madeonline/GreenhouseProject_continuation/Приемник метеостанции_MisolAmega328/MeteoMisol_WN5300CA_I2C_Slave_01/DOC/Метеостанция Misol WN5300CA.png

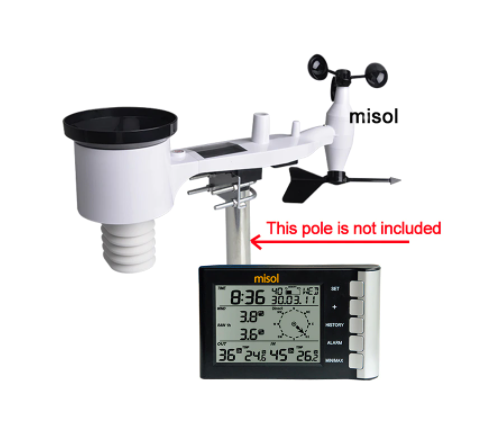
Приемник метеостанции_MisolAmega328/MeteoMisol_WN5300CA_I2C_Slave_01/DOC/Метеостанция Misol WN5300CA.png
