madeonline/GreenhouseProject_continuation/Датчик влажности грунта/Soil_moisture_sensorAmega328_6/2021-06-04_08-44-53.jpg

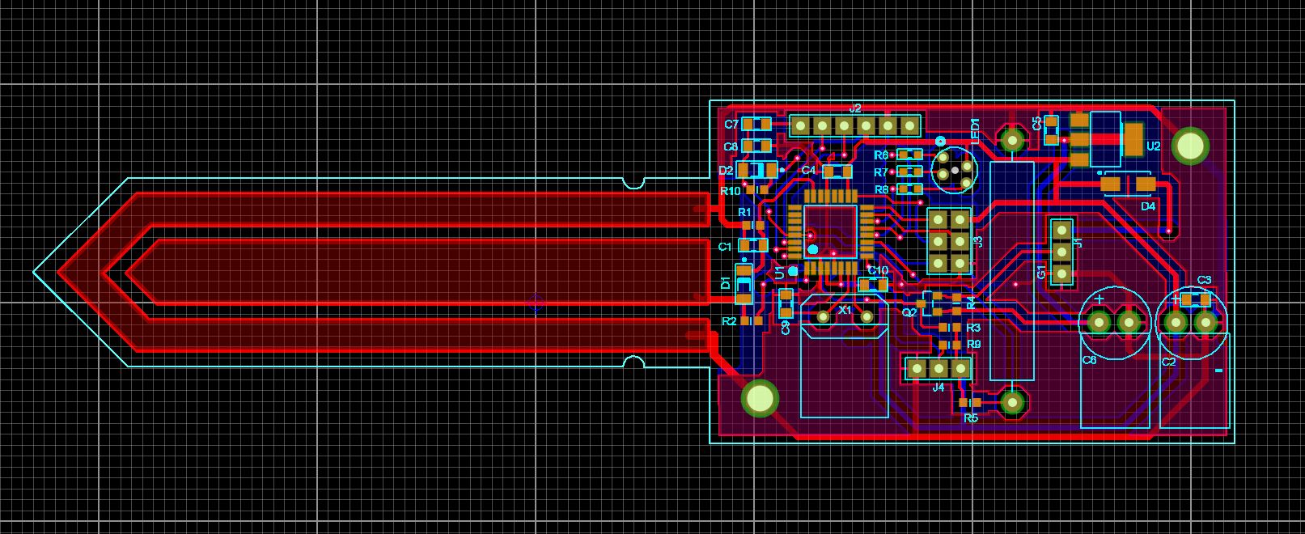
Датчик влажности грунта/Soil_moisture_sensorAmega328_6/2021-06-04_08-44-53.jpg
