madeonline/GreenhouseProject_continuation/Инструкции на контроллер теплицы/Локальный сайт теплицы/WEB/README.TXT

1. Требования к веб-серверу

  * На сервере должна быть установлена поддержка PHP версии не ниже 5.4
    (в случае Apache это mod_php5);
    
  * На сервере должна быть установлена поддержка SQLite3 для PHP,
    для Apache под Windows это:
    
      extension=php_pdo.dll
      extension=php_pdo_sqlite.dll
      extension=php_sqlite3.dll

2. Работа по расписанию.

  Для работы по расписанию необходимо поставить скрипт cron.php
  в планировщик. Этот скрипт собирает данные со всех прописанных в БД
  контроллеров и помещает их в базу. В дальнейшем на основе этих
  данных строятся графики.
