madeonline/GreenhouseProject_continuation/Инструкции на контроллер теплицы/ПРОГРАММЫ ДЛЯ ПОЛЬЗОВАТЕЛЕЙ/lang/en.ini.richTextBox4.rtf

When device is connected to the MQTT-broker, it's start publishing the topics, provided by user. Also device is subscribed to the CLIENT_NAME/SET/# topic, where "CLIENT_NAME" - is the MQTT-client name, entered in firmware settings. By publish the CLIENT_NAME/SET/..., you can send commands to the device. All of commands are in uppercase! Below you can find the list of frequently used commands:

• CLIENT_NAME/SET/STATE/WINDOW/ALL/OPEN - open all windows;
• CLIENT_NAME/SET/STATE/WINDOW/ALL/CLOSE - close all windows;
• CLIENT_NAME/SET/STATE/WINDOW/0/OPEN - open window number 1;
• CLIENT_NAME/SET/STATE/WINDOW/2/CLOSE - close window number 3;
• CLIENT_NAME/SET/WATER/ON - start watering;
• CLIENT_NAME/SET/WATER/ON/1 - start watering on channel 2;
• CLIENT_NAME/SET/WATER/OFF - stop watering;
• CLIENT_NAME/SET/WATER/OFF/0 - stop watering on channel 1;
• CLIENT_NAME/SET/LIGHT/ON - light on;
• CLIENT_NAME/SET/LIGHT/OFF - light off;
• CLIENT_NAME/SET/STATE/MODE/AUTO - switch to automatic windows management mode;
• CLIENT_NAME/SET/STATE/MODE/MANUAL - switch to manual windows management mode;
• CLIENT_NAME/SET/WATER/MODE/AUTO - switch to automatic watering management mode;
• CLIENT_NAME/SET/WATER/MODE/MANUAL - switch to manual watering management mode;
• CLIENT_NAME/SET/LIGHT/MODE/AUTO - switch to automatic light management mode;
• CLIENT_NAME/SET/LIGHT/MODE/MANUAL - switch to manual light management mode;
• CLIENT_NAME/SET/PIN/13/ON - turn pin 13 on;
• CLIENT_NAME/SET/PIN/10/OFF - turn pin 10 off;
• CLIENT_NAME/SET/CC/EXEC/0 - execute composite command number 1;
• CLIENT_NAME/SET/RULE_STATE/ALL/ON - enable all rules;
• CLIENT_NAME/SET/RULE_STATE/ALL/OFF - disable all rules;
• CLIENT_NAME/SET/RULE_ALERT/ALL/ON - enable all alarm rules;
• CLIENT_NAME/SET/RULE_ALERT/ALL/OFF - disable all alarm rules;
• CLIENT_NAME/SET/0/AUTO - turn into automatic work mode.

Also you can receive any firmware settings by publish the CLIENT_NAME/GET/... topic.

Also by using the CLIENT_NAME/SET/... topics you can set any settings of any firmware module, if you wish. For additional information - please write to spywarrior@gmail.com, and I can extend this help with explanation of your query.

Result of the requested command are published to the CLIENT_NAME/REPORT topic.
