madeonline/GreenhouseProject_continuation/Инструкции на контроллер теплицы/Аппаратная информация/Greenhouse_STM32_Maxi.png

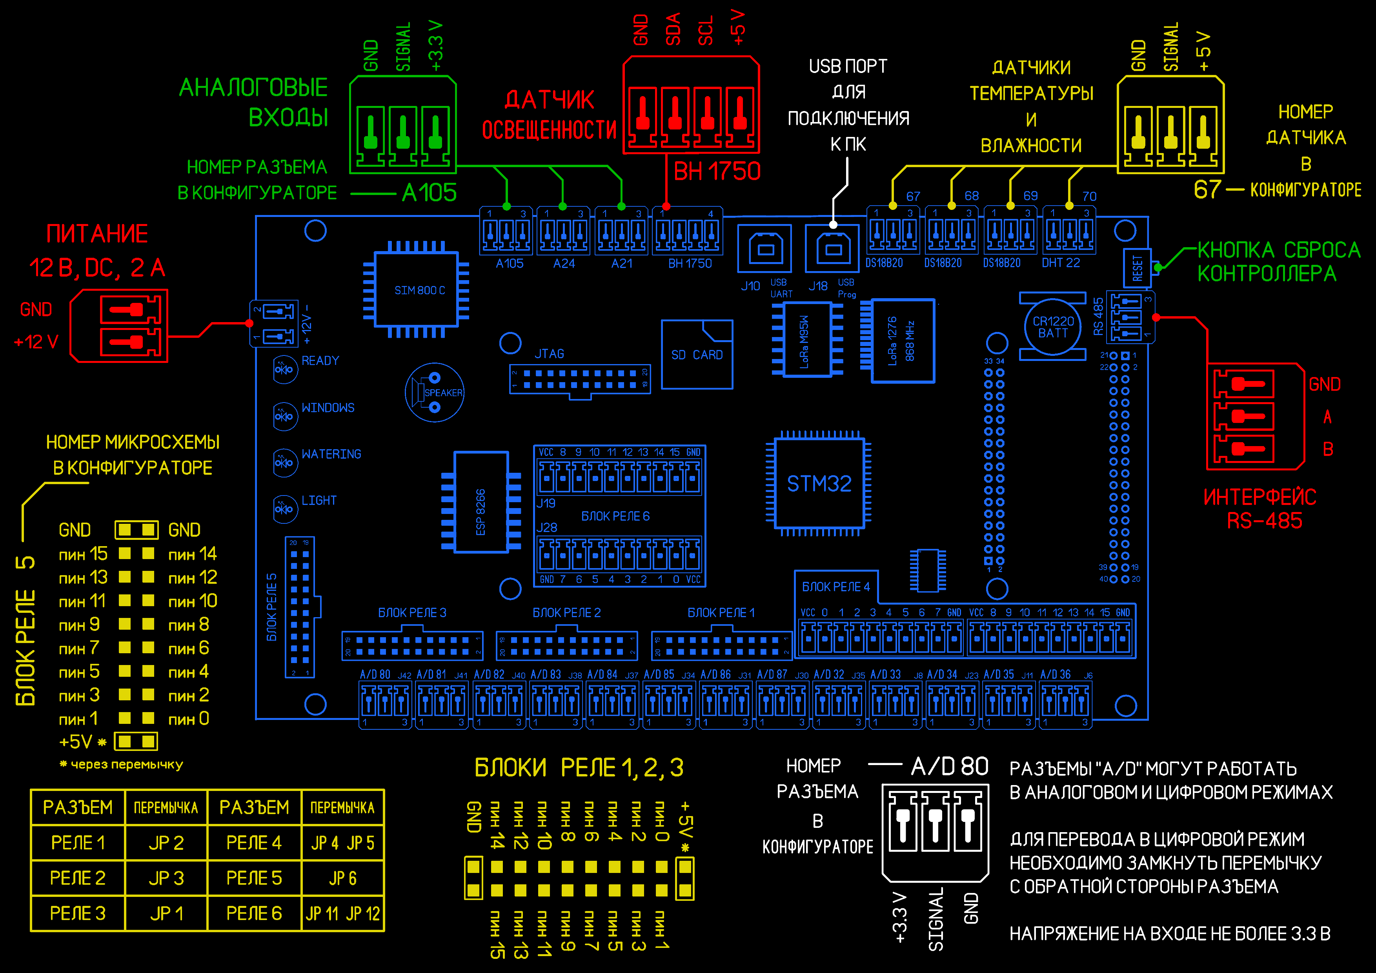
Инструкции на контроллер теплицы/Аппаратная информация/Greenhouse_STM32_Maxi.png
