madeonline/GreenhouseProject_continuation/Инструкции на контроллер теплицы/Аппаратная информация/Щит-сборка1.jpg

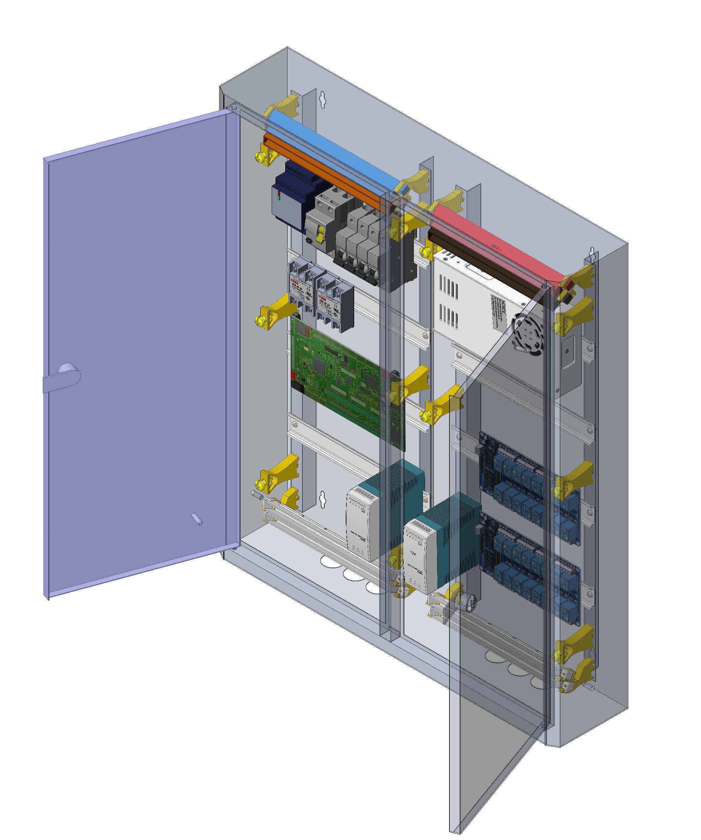
Инструкции на контроллер теплицы/Аппаратная информация/Щит-сборка1.jpg
