madeonline/GreenhouseProject_continuation/Инструкции на контроллер теплицы/Локальный сайт теплицы/2020-04-10_18-04-55.png

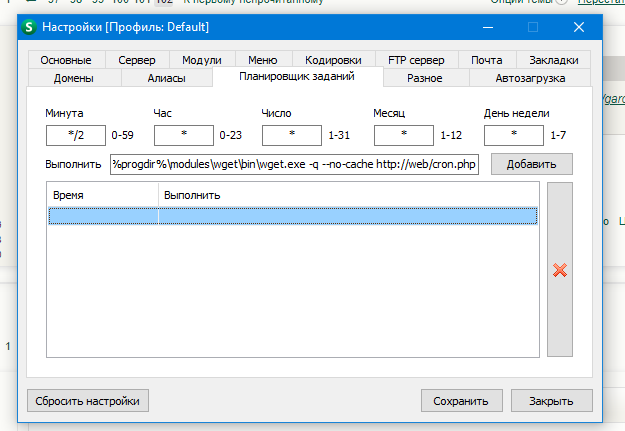
Инструкции на контроллер теплицы/Локальный сайт теплицы/2020-04-10_18-04-55.png
