madeonline/GreenhouseProject_continuation/Приемник метеостанции_MisolAmega328/2021-06-04_10-09-00.jpg

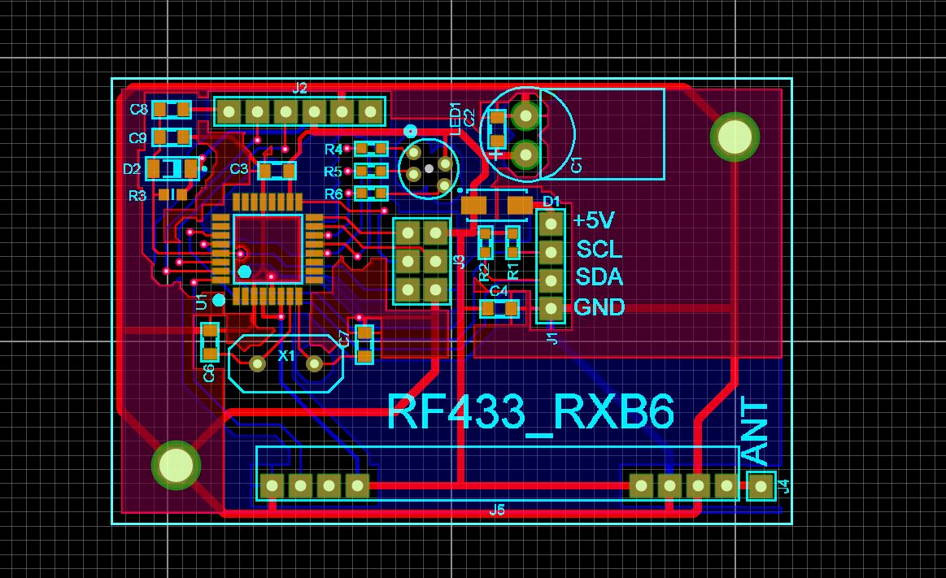
Приемник метеостанции_MisolAmega328/2021-06-04_10-09-00.jpg
