madeonline/GreenhouseProject_continuation/Приемник метеостанции_MisolAmega328/MeteoMisol_WS0232_I2C_Slave_01/DOC/Метеостанция WS0232.png

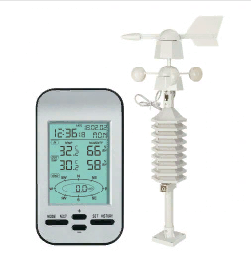
Приемник метеостанции_MisolAmega328/MeteoMisol_WS0232_I2C_Slave_01/DOC/Метеостанция WS0232.png
