madeonline/GreenhouseProject_continuation/Ультразвуковой модуль уровня воды/UniversalUltrasonicModule_02/2021-05-02_10-48-28.png

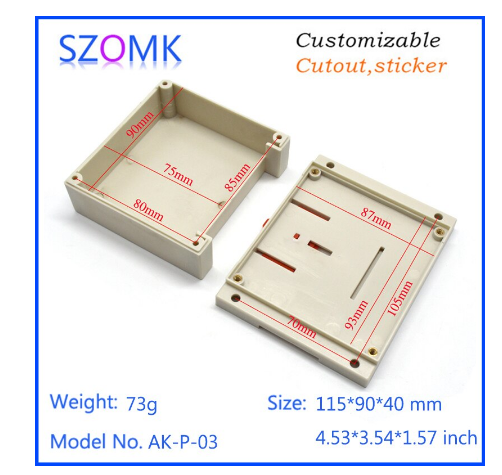
Ультразвуковой модуль уровня воды/UniversalUltrasonicModule_02/2021-05-02_10-48-28.png
