madeonline/GreenhouseProject_continuation/Приемник метеостанции_MisolAmega328/Receive_MisolAmega328_1.PDF

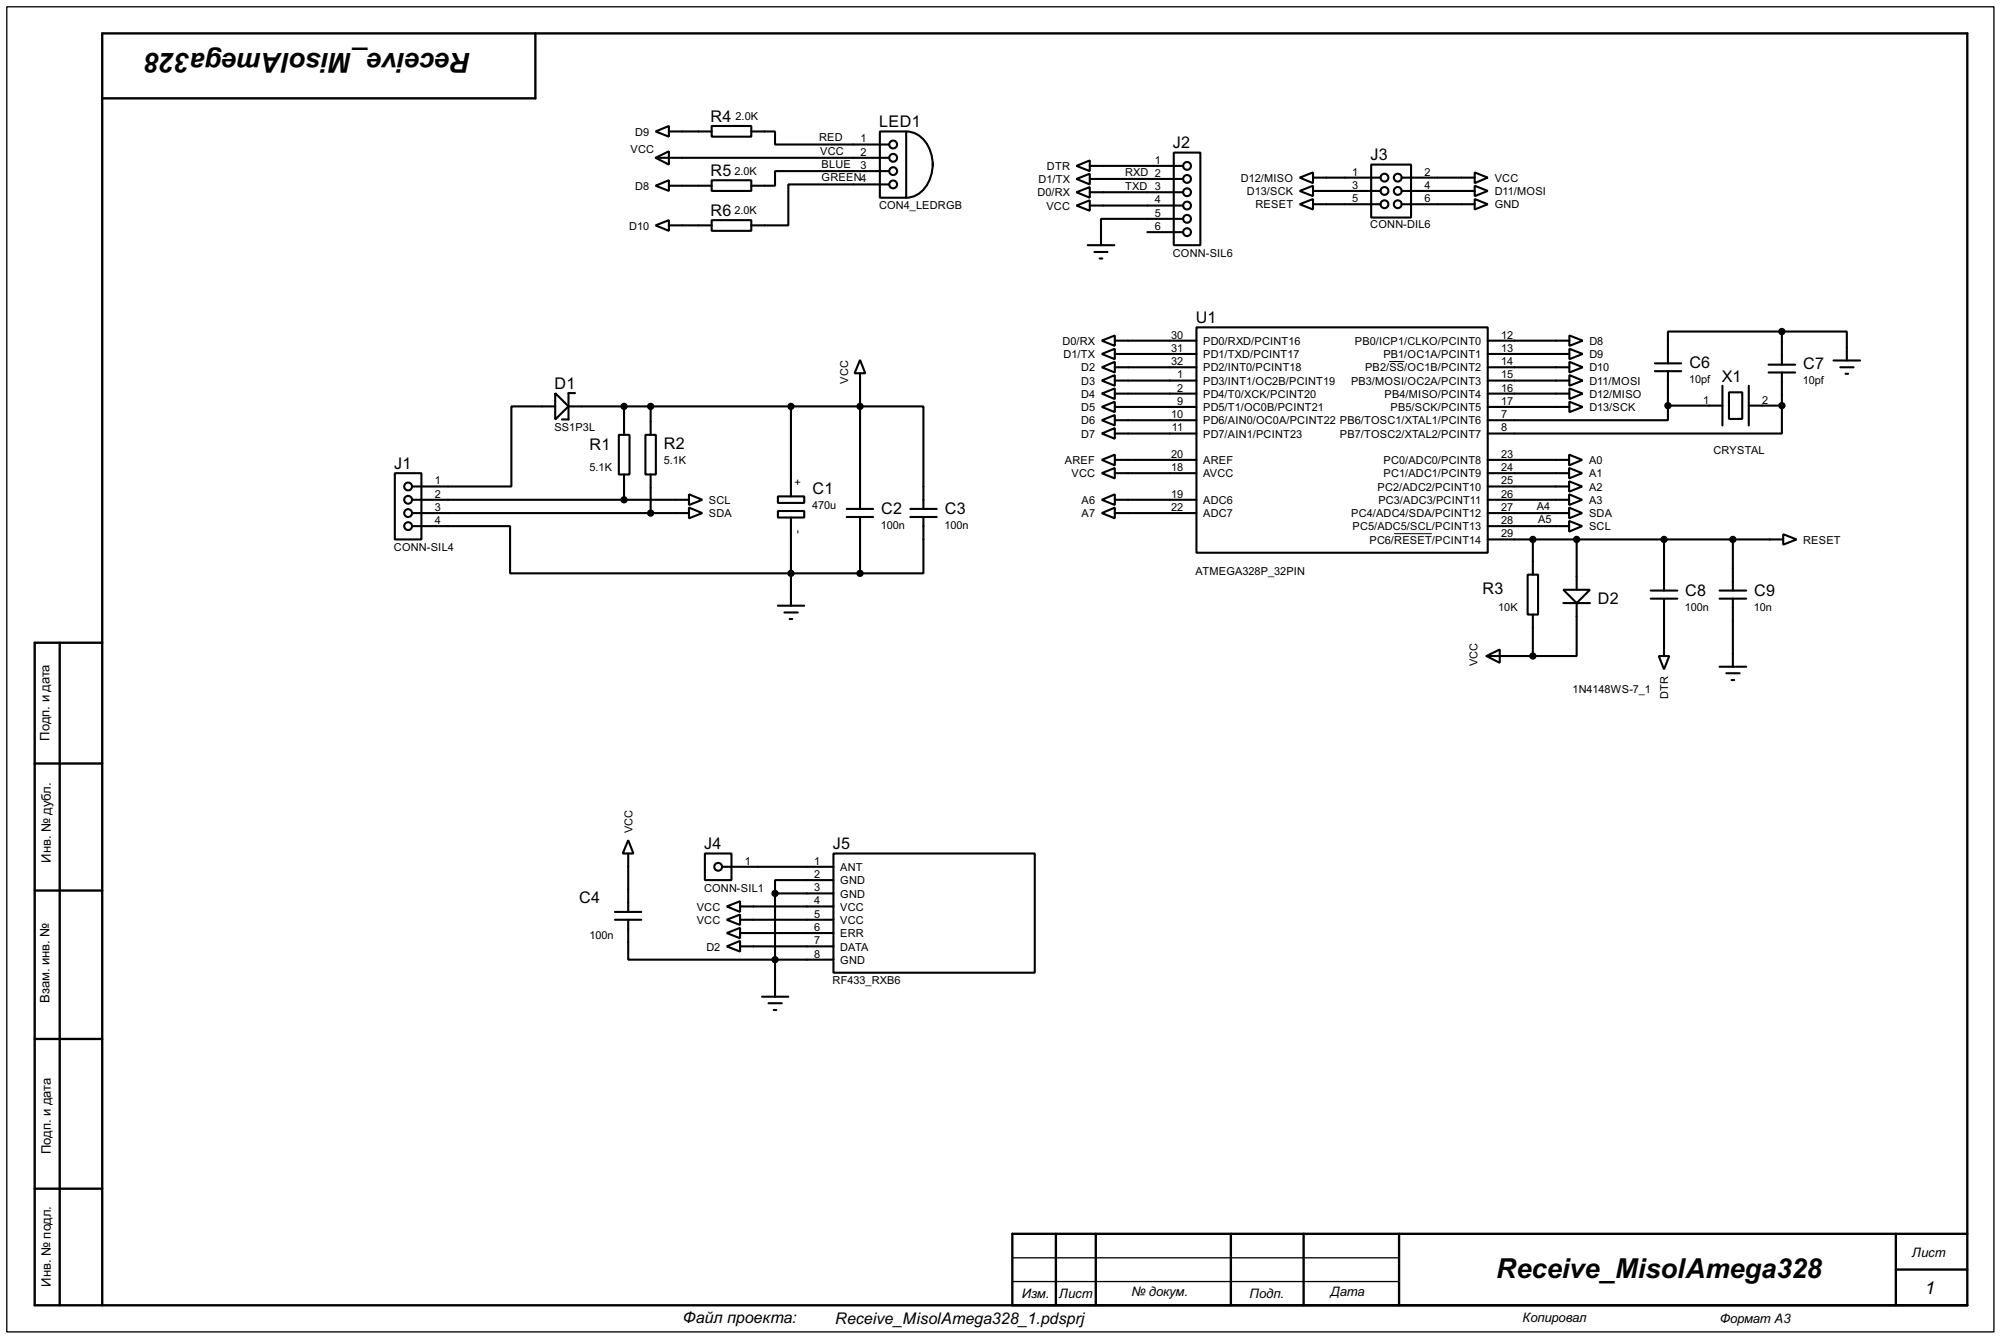
[picture p14: page 1]

Инв. № подл. Подп. и дата Взам. инв. № Инв. № дубл. Подп. и дата
