madeonline/GreenhouseProject_continuation/Внешний модуль полива/WateringExecutionModule_01.PDF

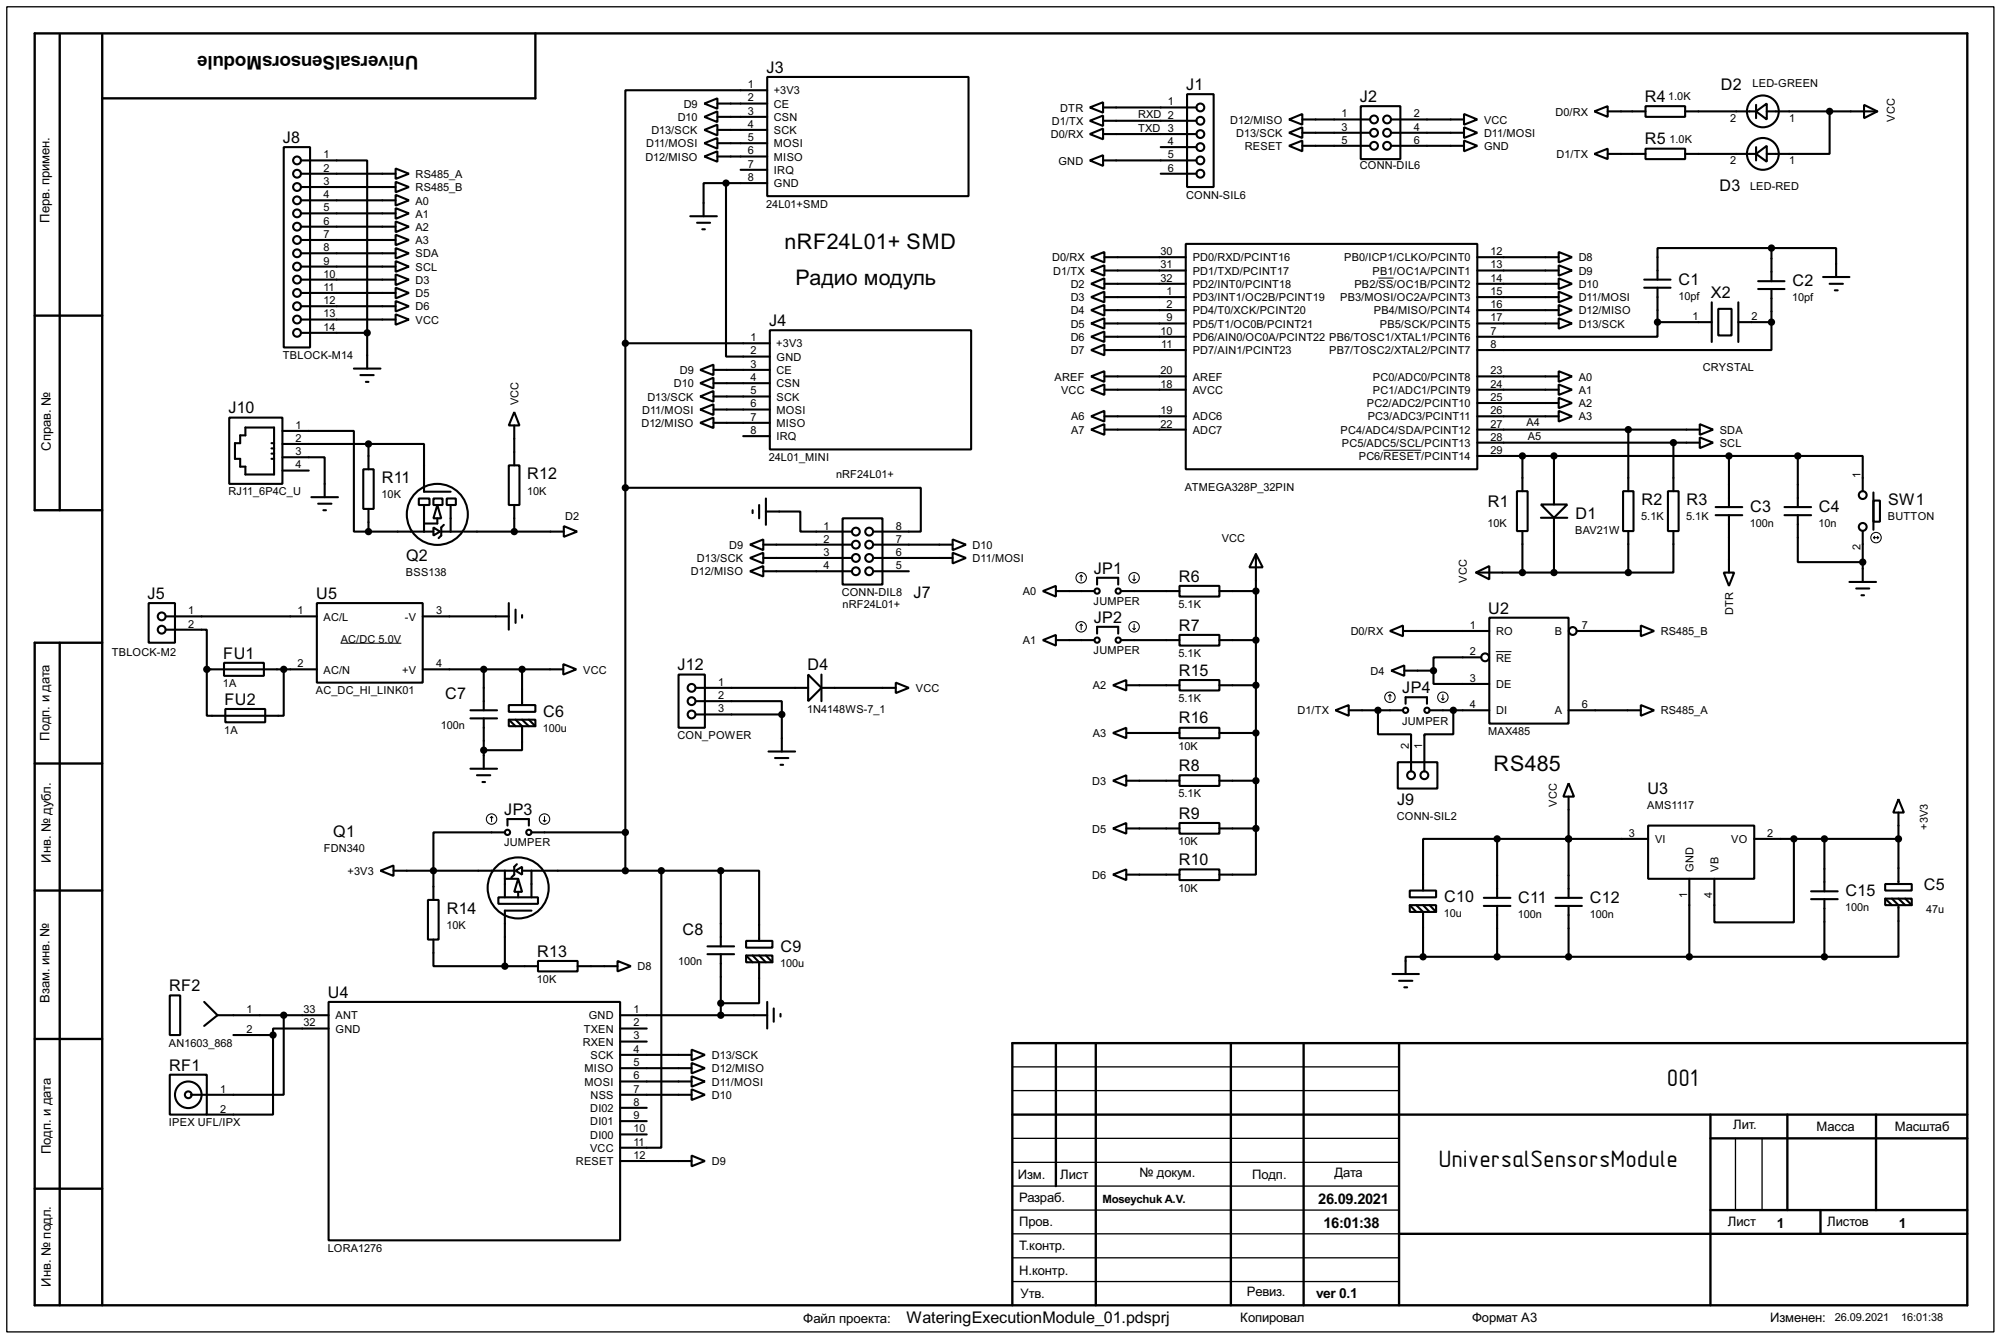
[picture p15: page 1]

Инв. № подл. Подп. и дата Взам. инв. № Инв. № дубл. Справ. № Перв. примен. Подп. и дата

Изм. Лист Разраб. Пров. Т.контр. Н.контр. Утв. | | 16:01:38 | | Лист 1 | Листов 1

№ докум. | Подп. | Дата

Moseychuk A.V. | | 26.09.2021
