madeonline/GreenhouseProject_continuation/Инструкции на контроллер теплицы/Аппаратная информация/STM32F407VGT6_Mini_01.PDF

U1

J2

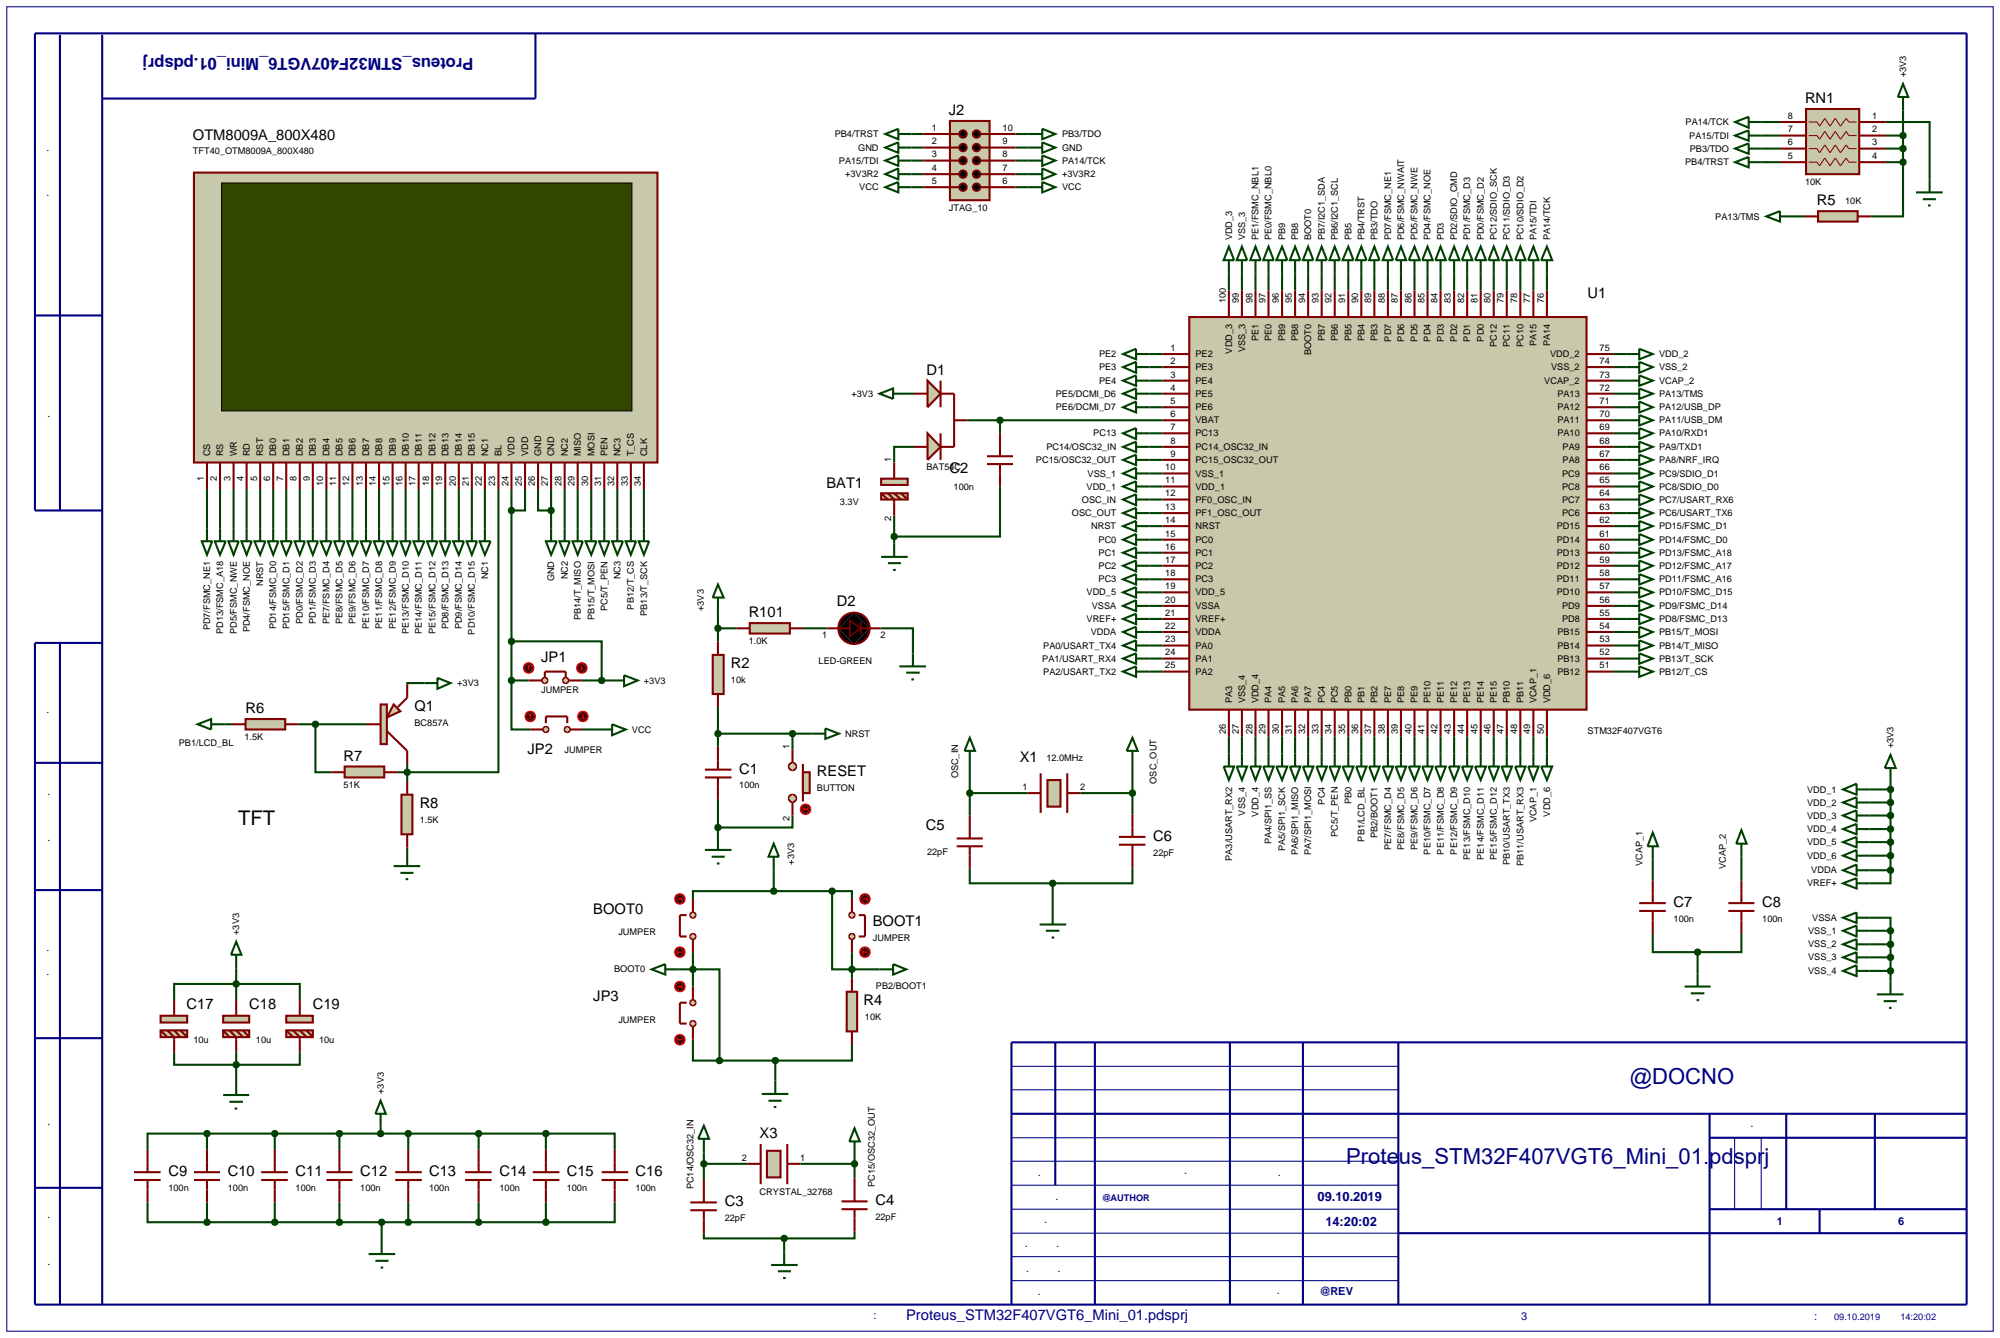
[picture p16: page 1]

Инв. № подл. Подп. и дата Взам. инв. № Инв. № дубл. Справ. № Перв. примен. Подп. и дата

@DOCNO

Лит. | Масса | Масштаб

Изм. | Лист | № докум. | Подп. | Дата
Разраб. | | @AUTHOR | | 09.10.2019
Пров. | | | 14:20:02 | | Лист 1 6 | Листов
Т.контр.

Н.контр.
Утв. | | Ревиз. | @REV
