madeonline/GreenhouseProject_continuation/Инструкции на контроллер теплицы/Аппаратная информация/STM32F407VGT6_Mini_02.PDF

U1

## OTM8009A_800X480

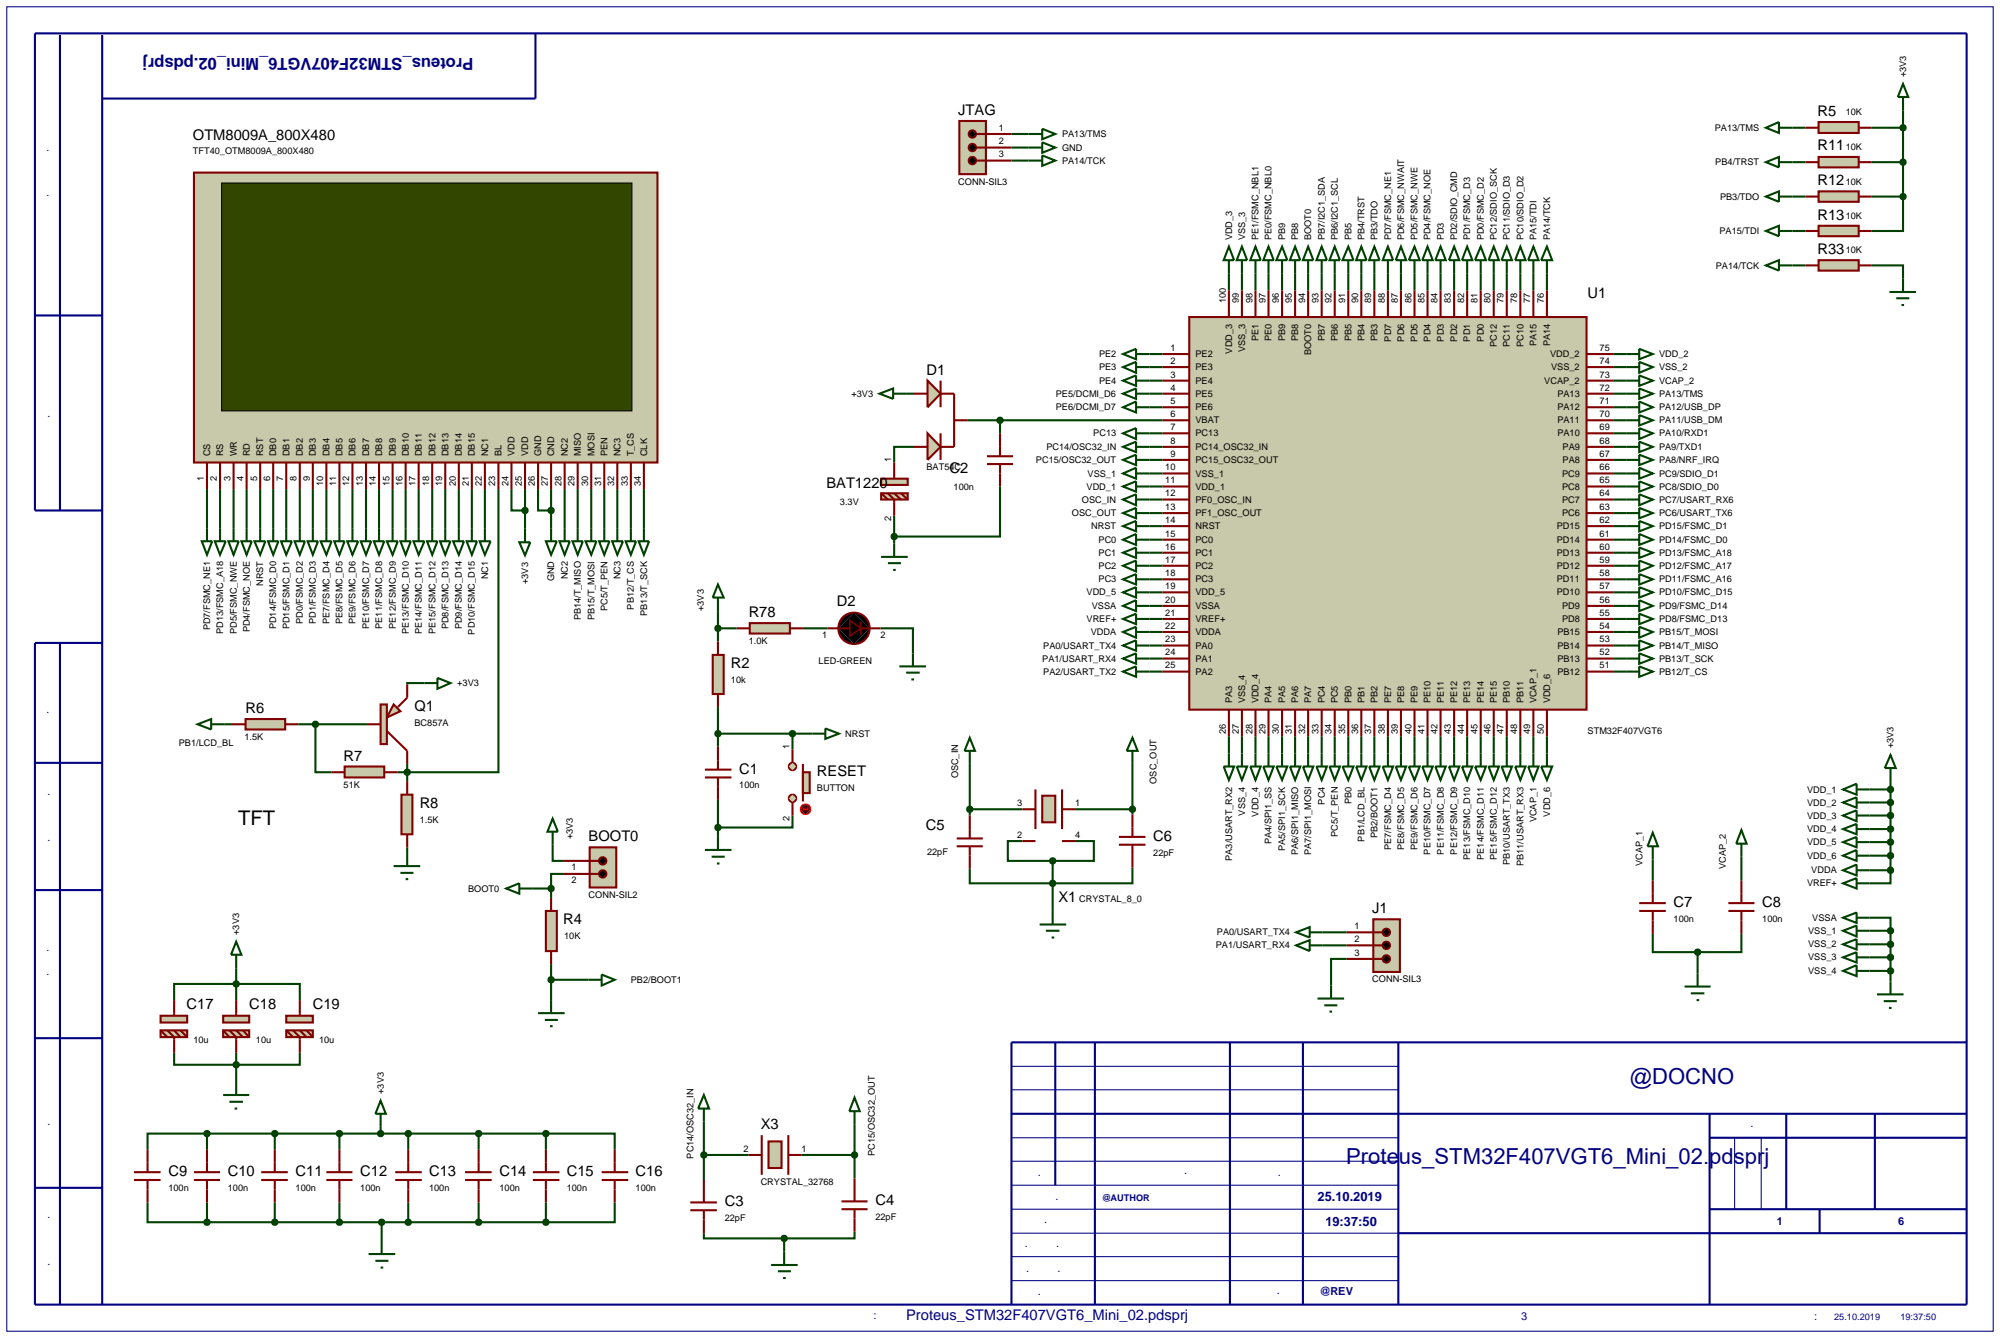
[picture p17: page 1]

Инв. № подл. Подп. и дата Взам. инв. № Инв. № дубл. Справ. № Перв. примен. Подп. и дата

Разъем TFT дисплея PD⁰/FSMC_D² PD¹/FSMC_D³ PD¹⁴/FSMC_D⁰ PD¹⁵/FSMC_D¹

@DOCNO

Лит. | Масса | Масштаб

Изм. | Лист | № докум. | Подп. | Дата
Разраб. | | @AUTHOR | | 25.10.2019
Пров. | | | 19:37:50 | | Лист 1 6 | Листов
Т.контр.

Н.контр.
Утв. | | Ревиз. | @REV

Q3

R19

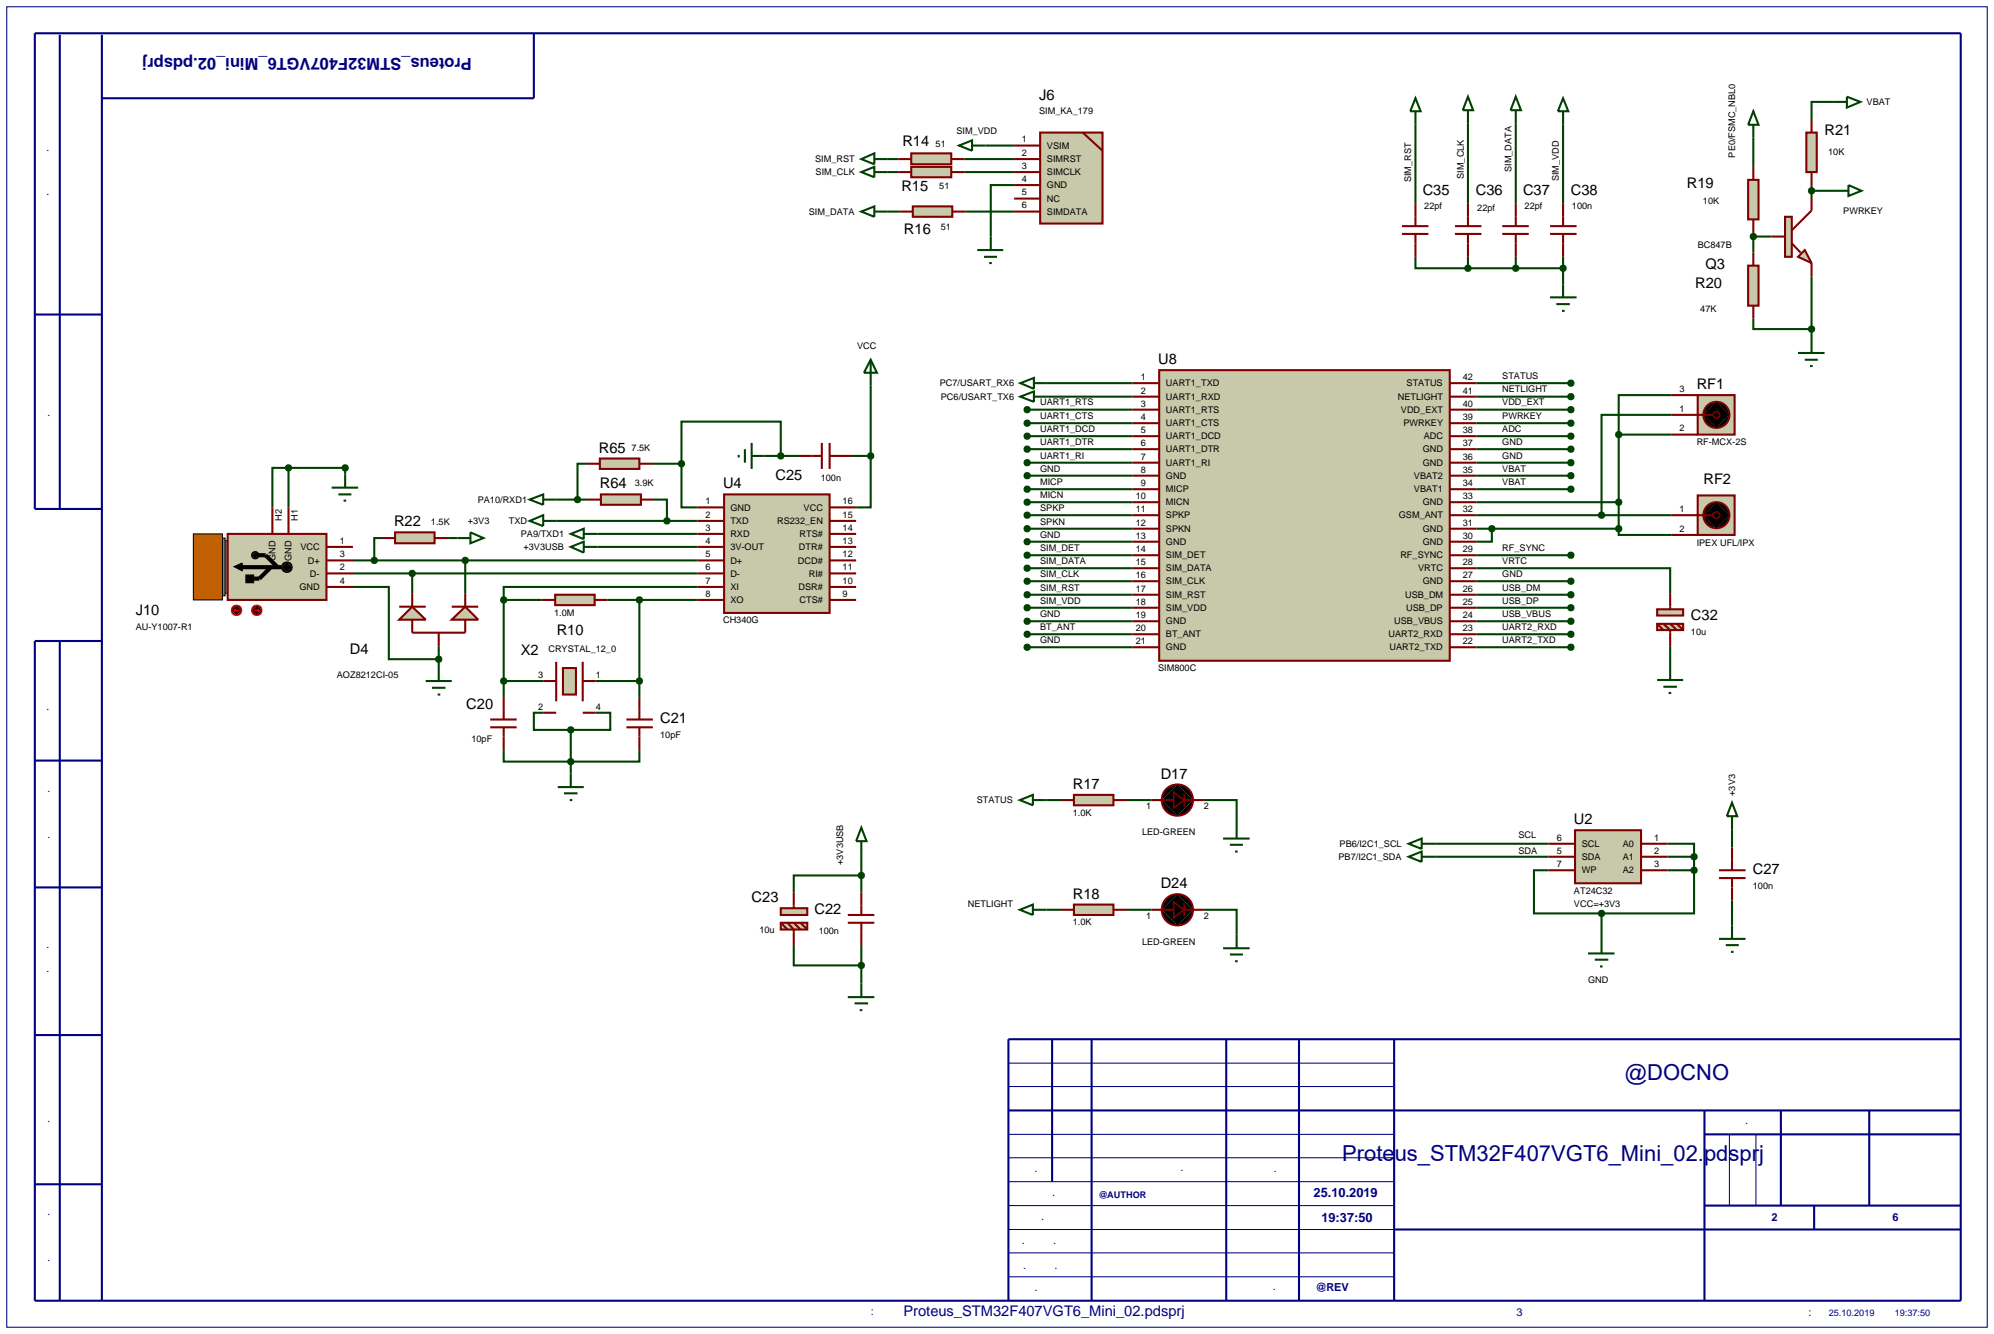
[picture p18: page 2]

Инв. № подл. Подп. и дата Взам. инв. № Инв. № дубл. Справ. № Перв. примен. Подп. и дата

@DOCNO

Лит. | Масса | Масштаб

Изм. | Лист | № докум. | Подп. | Дата
Разраб. | | @AUTHOR | | 25.10.2019
Пров. | | | 19:37:50 | | Лист 2 6 | Листов

U7

RS485

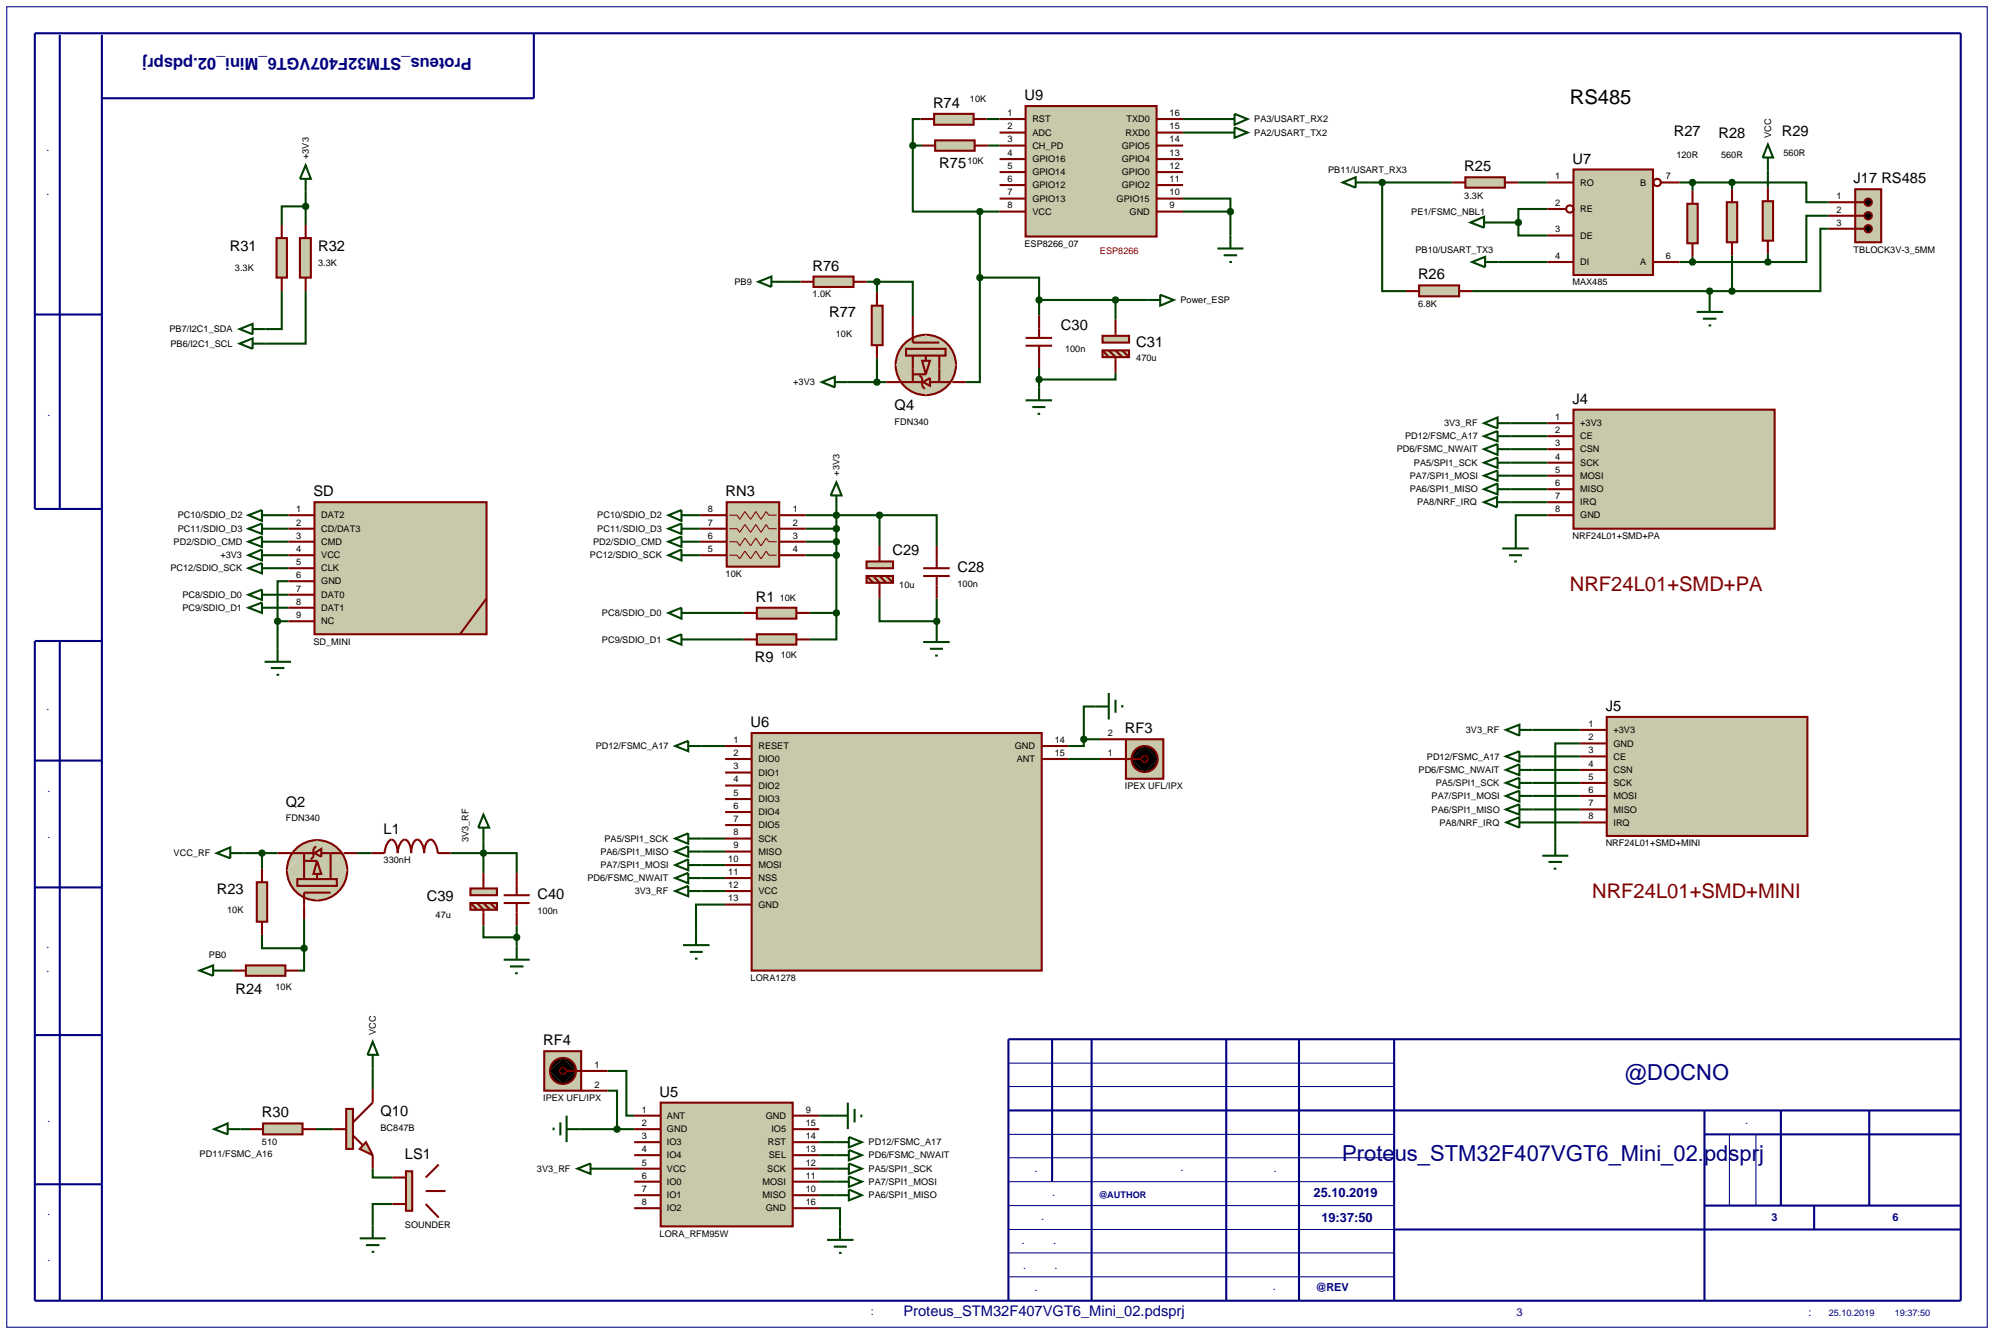
[picture p19: page 3]

Инв. № подл. Подп. и дата Взам. инв. № Инв. № дубл. Справ. № Перв. примен. Подп. и дата

@DOCNO

Лит. | Масса | Масштаб

Изм. | Лист | № докум. | Подп. | Дата
Разраб. | | @AUTHOR | | 25.10.2019
Пров. | | | 19:37:50 | | Лист 3 6 | Листов

R45

R38

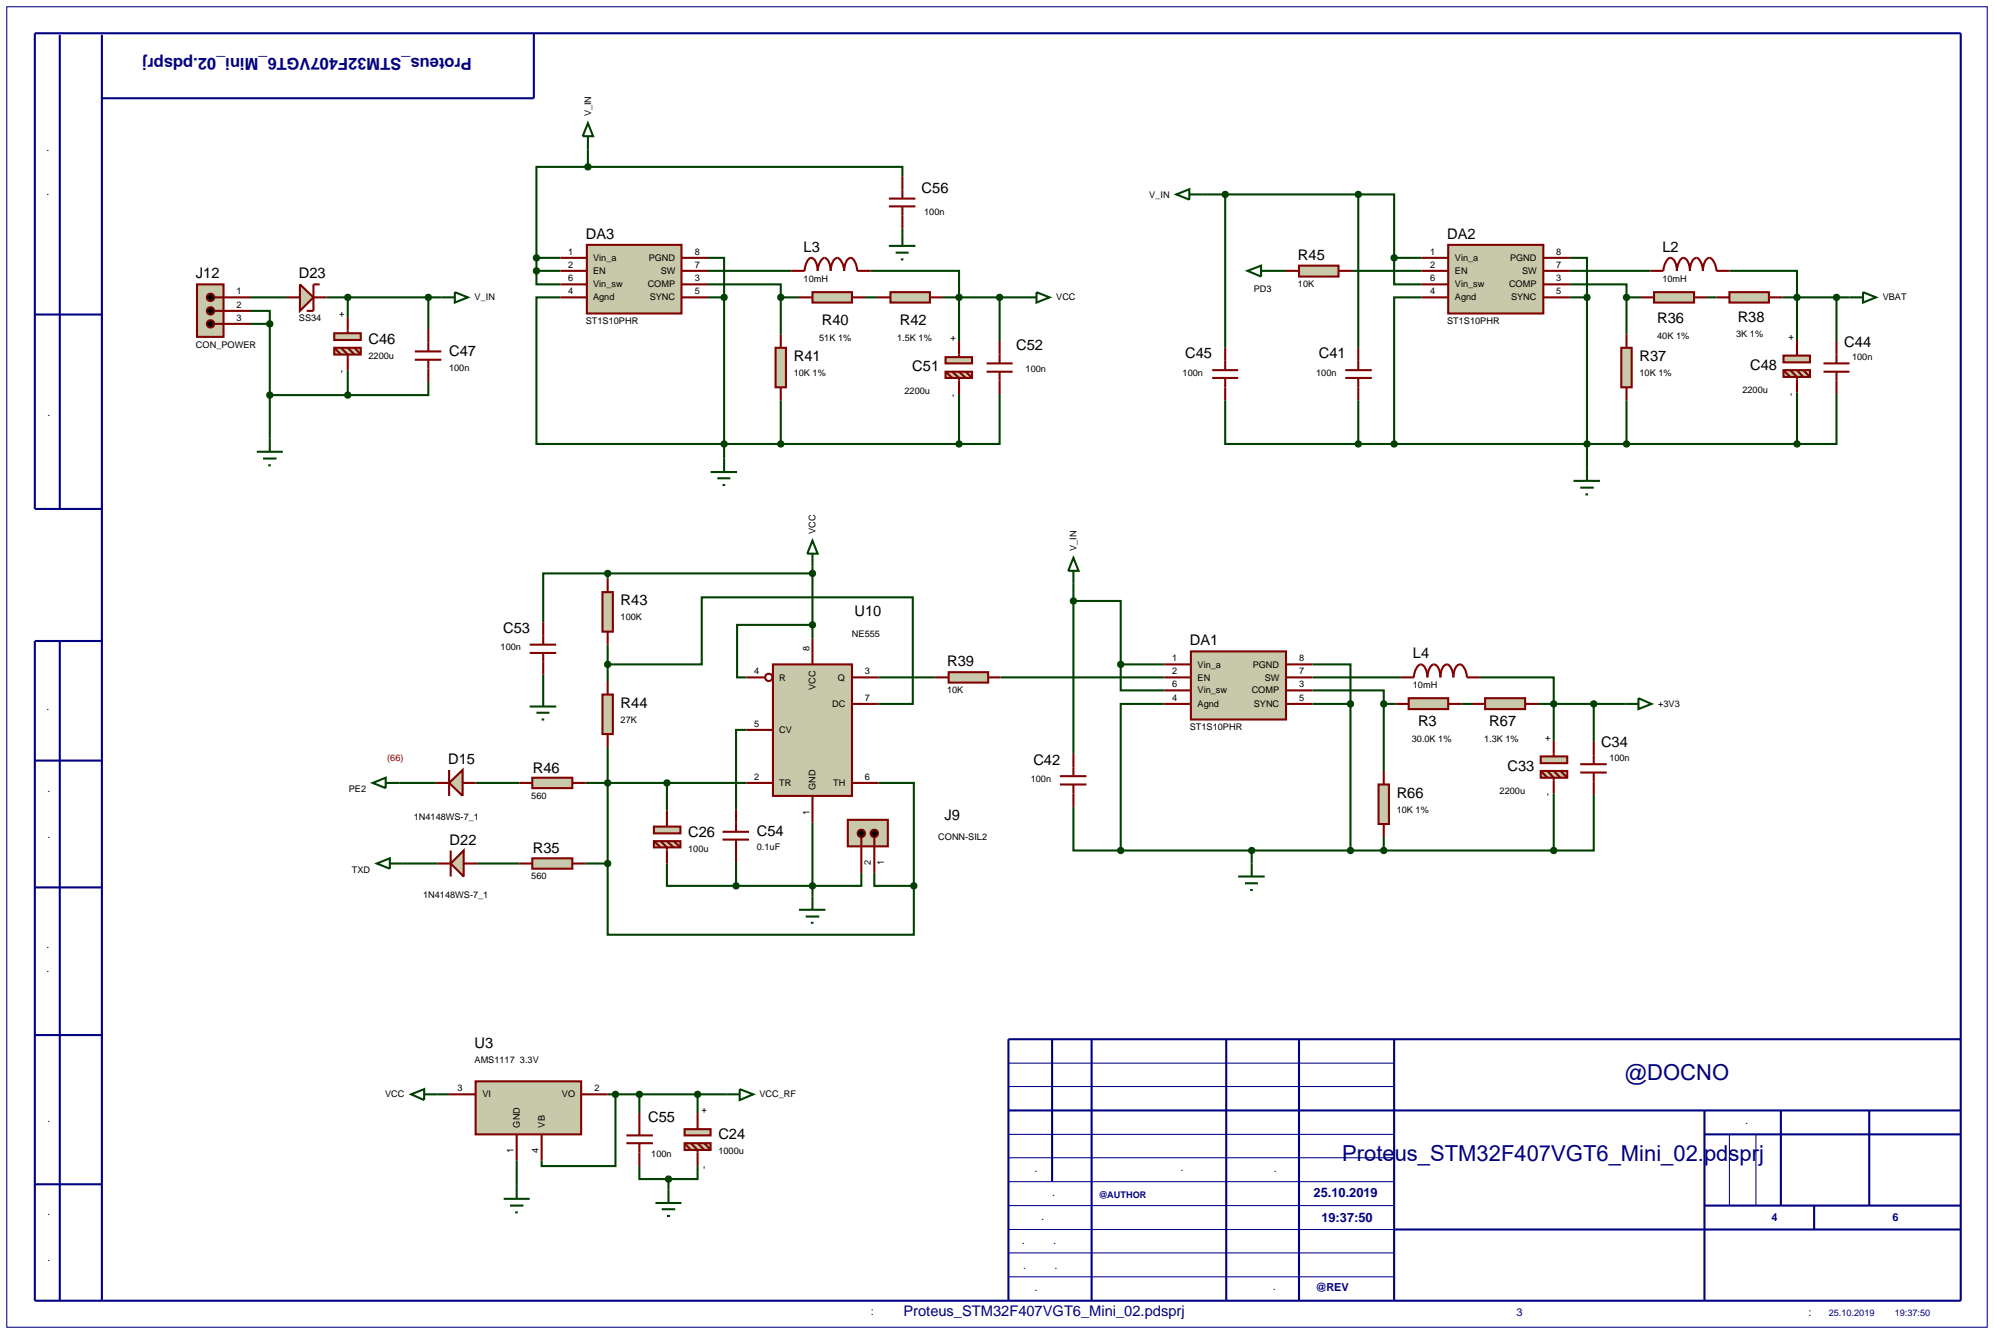
[picture p20: page 4]

Инв. № подл. Подп. и дата Взам. инв. № Инв. № дубл. Справ. № Перв. примен. Подп. и дата

@DOCNO

Лит. | Масса | Масштаб

Изм. | Лист | № докум. | Подп. | Дата
Разраб. | | @AUTHOR | | 25.10.2019
Пров. | | | 19:37:50 | | Лист 4 6 | Листов

U12

JP2

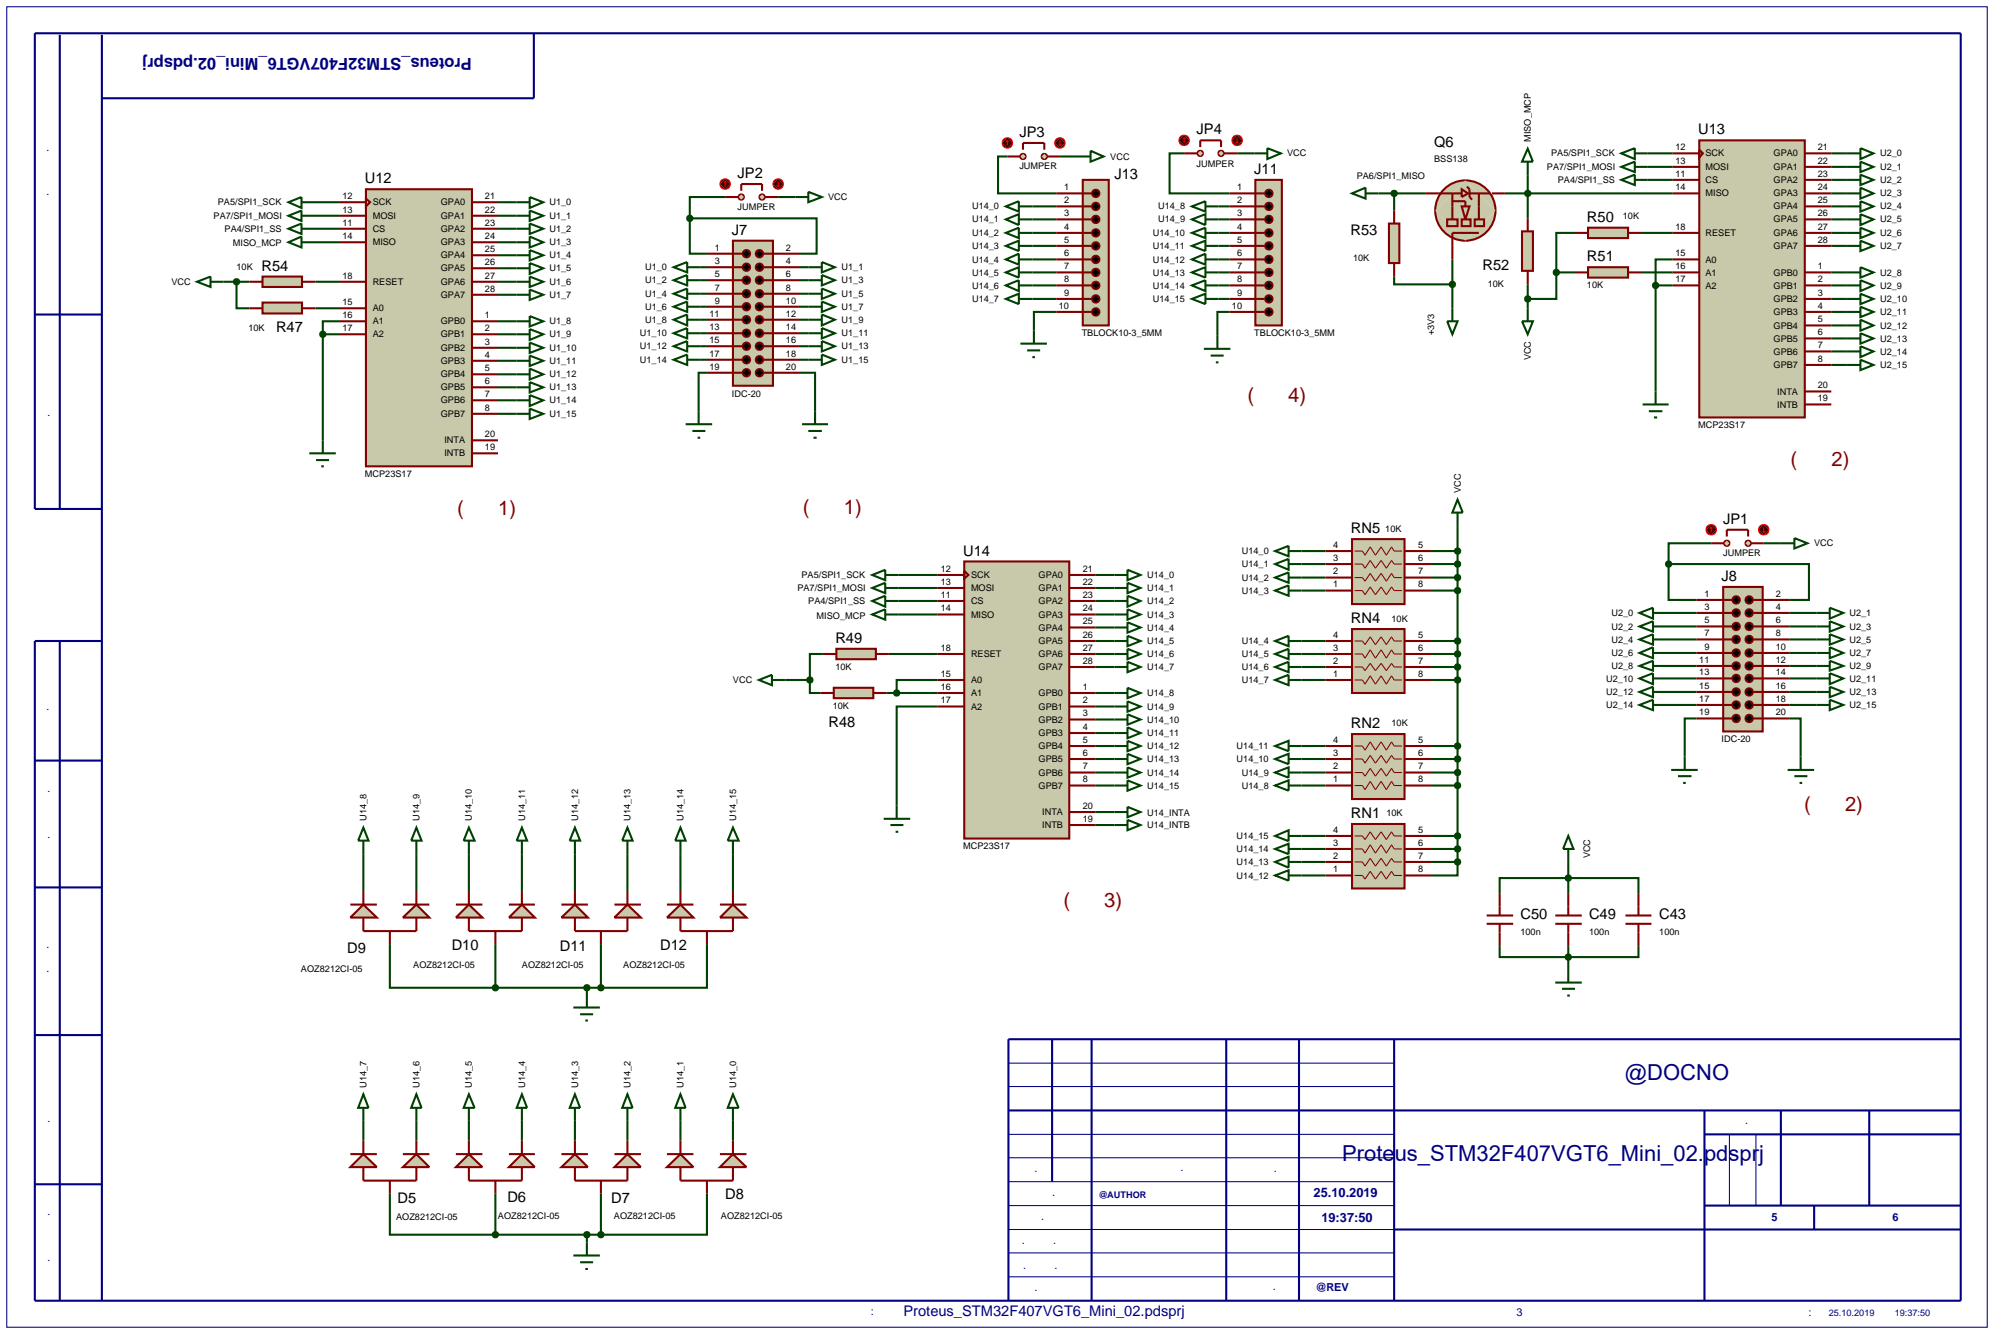
[picture p21: page 5]

Инв. № подл. Подп. и дата Взам. инв. № Инв. № дубл. Справ. № Перв. примен. Подп. и дата

@DOCNO

Лит. | Масса | Масштаб

J16 33

J14 36

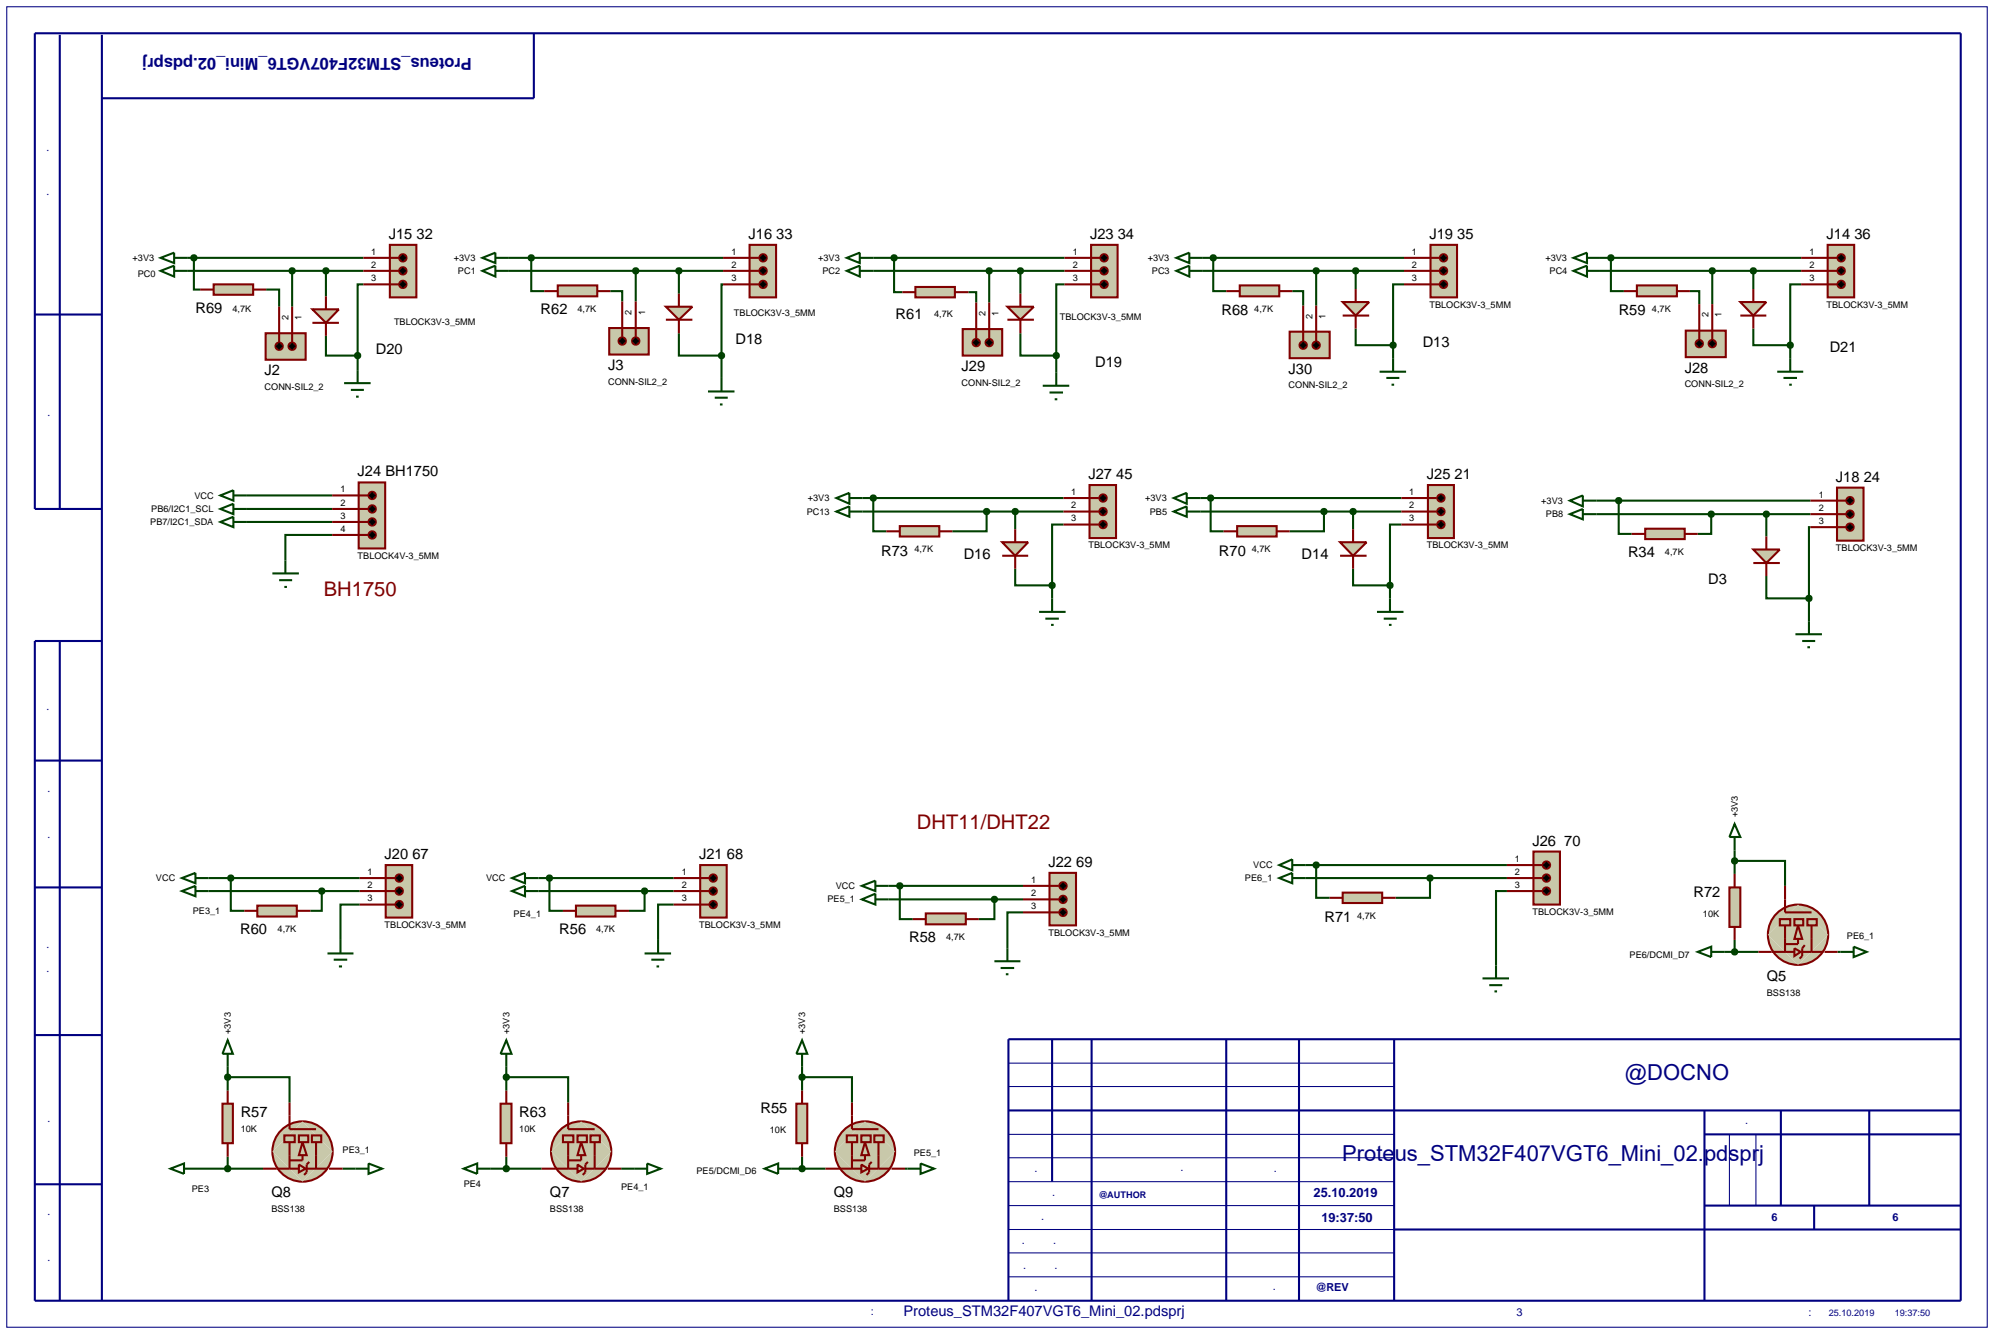
[picture p22: page 6]

Инв. № подл. Подп. и дата Взам. инв. № Инв. № дубл. Справ. № Перв. примен. Подп. и дата

@DOCNO

Лит. | Масса | Масштаб

Разраб. | @AUTHOR | 25.10.2019
Пров. | | 19:37:50 | Лист 6 6 | Листов
