madeonline/GreenhouseProject_continuation/Инструкции на контроллер теплицы/Аппаратная информация/STM32F407ZGT6_Maxi_03.PDF

J30

J31

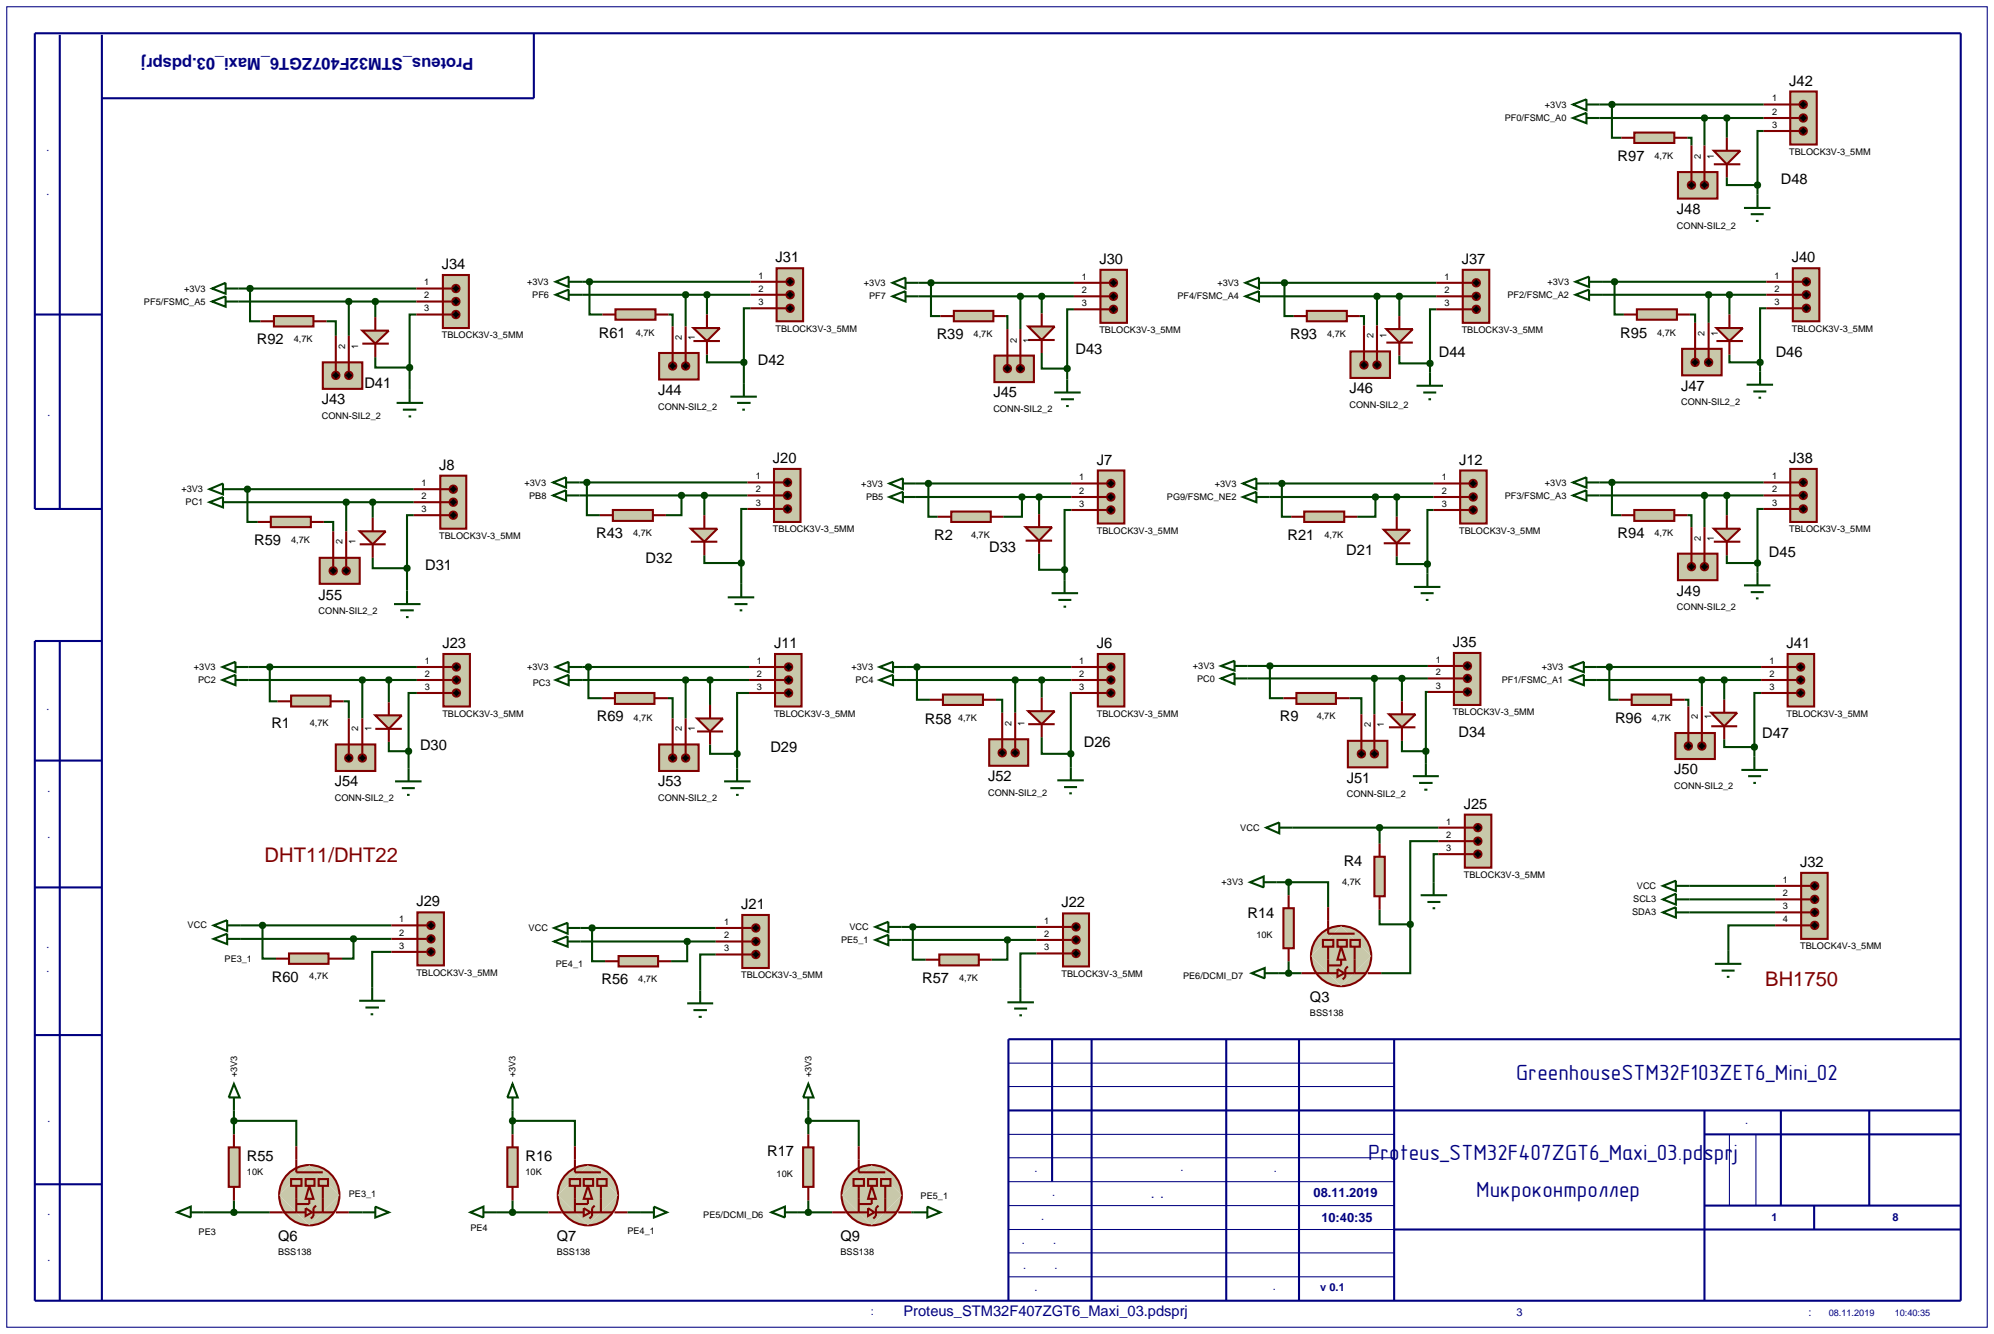
[picture p23: page 1]

Инв. № подл. Подп. и дата Взам. инв. № Инв. № дубл. Справ. № Перв. примен. Подп. и дата

GreenhouseSTM32F103ZET6_Mini_02

Микроконтроллер | Лит. | Масса | Масштаб

Изм. | Лист | № докум. | Подп. | Дата

Разраб. | | Мосейчук А.В. | | 08.11.2019

Т.контр.

Н.контр.
Утв. | Ревиз. | v 0.1

## LCD1

U3

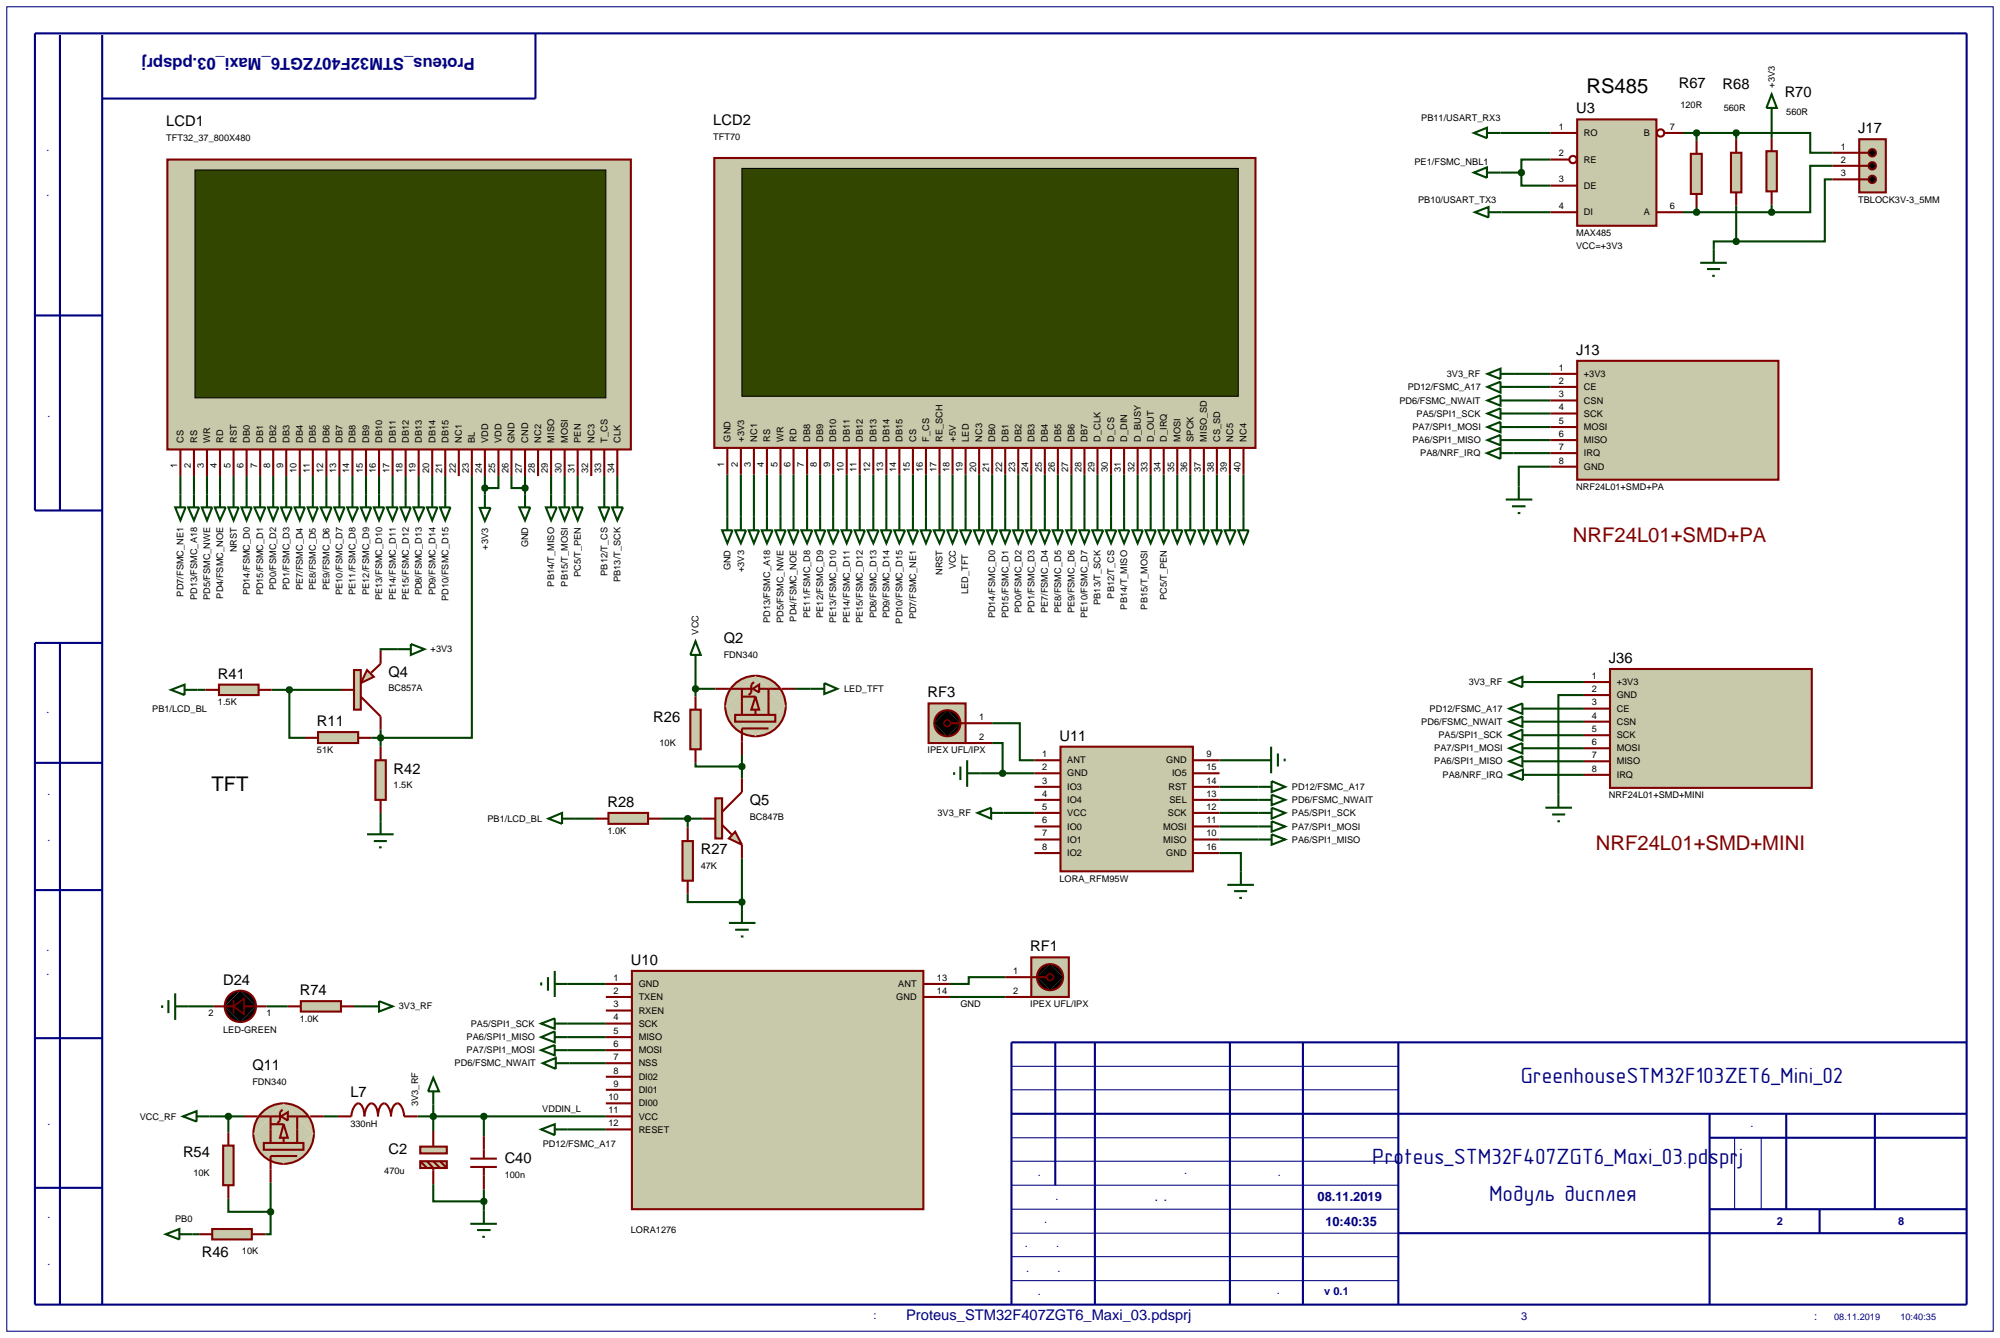
[picture p24: page 2]

Инв. № подл. Подп. и дата Взам. инв. № Инв. № дубл. Справ. № Перв. примен. Подп. и дата

Изм. | Лист | № докум. | Подп. | Дата

Разраб. | | Мосейчук А.В. | | 08.11.2019
Пров. | | | 10:40:35 | | Лист 2 8 | Листов

U2
Q1

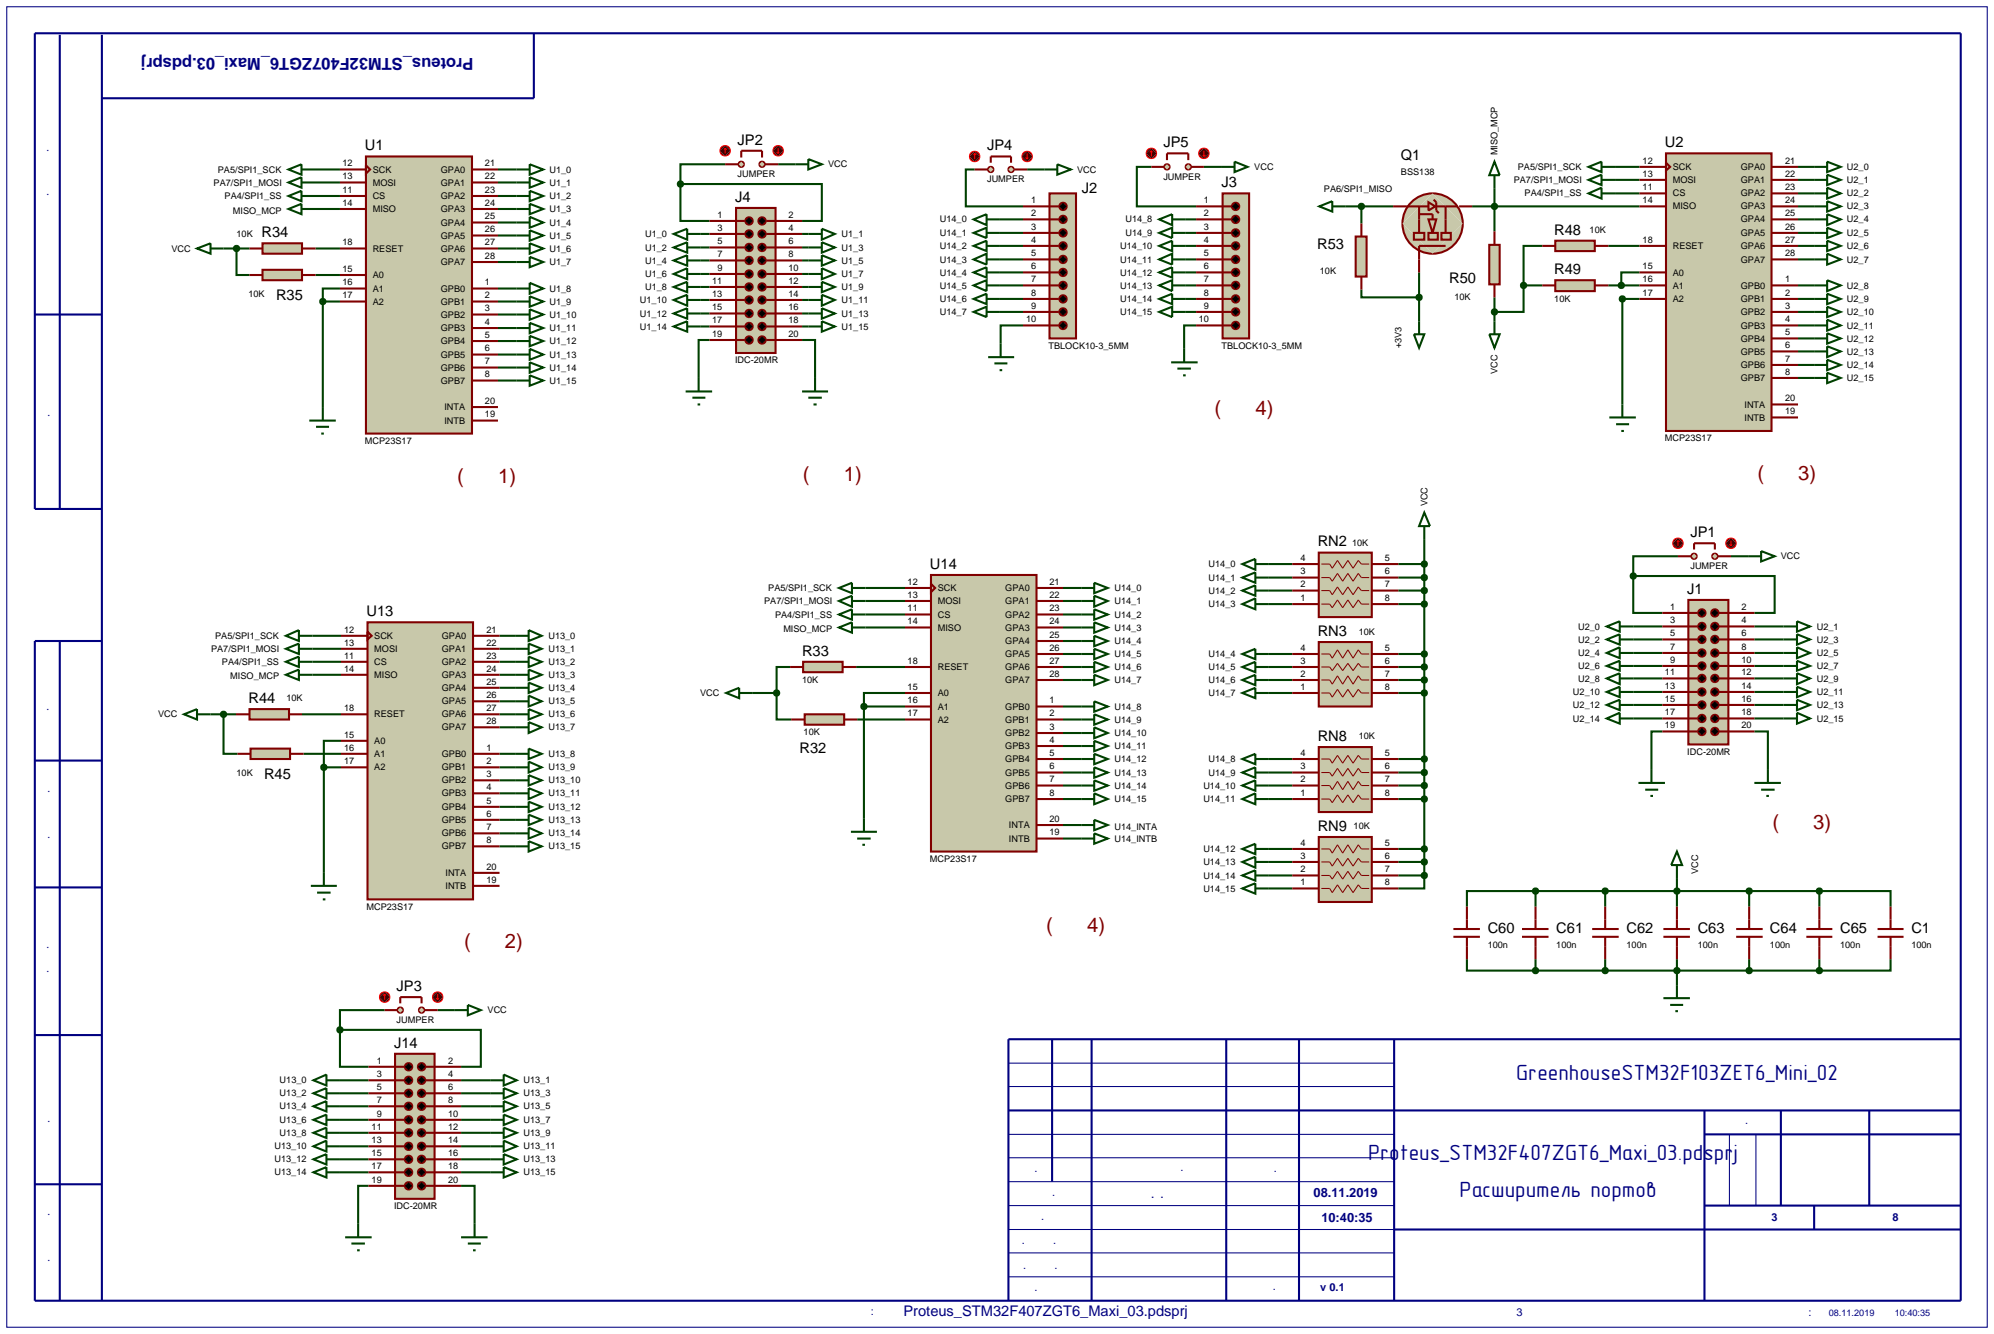
[picture p25: page 3]

Инв. № подл. Подп. и дата Взам. инв. № Инв. № дубл. Справ. № Перв. примен. Подп. и дата

GreenhouseSTM32F103ZET6_Mini_02

Расширитель портов | Лит. | Масса | Масштаб

Изм. | Лист | № докум. | Подп. | Дата

Разраб. | | Мосейчук А.В. | | 08.11.2019
Пров. | | | 10:40:35 | | Лист 3 8 | Листов

R18

L2

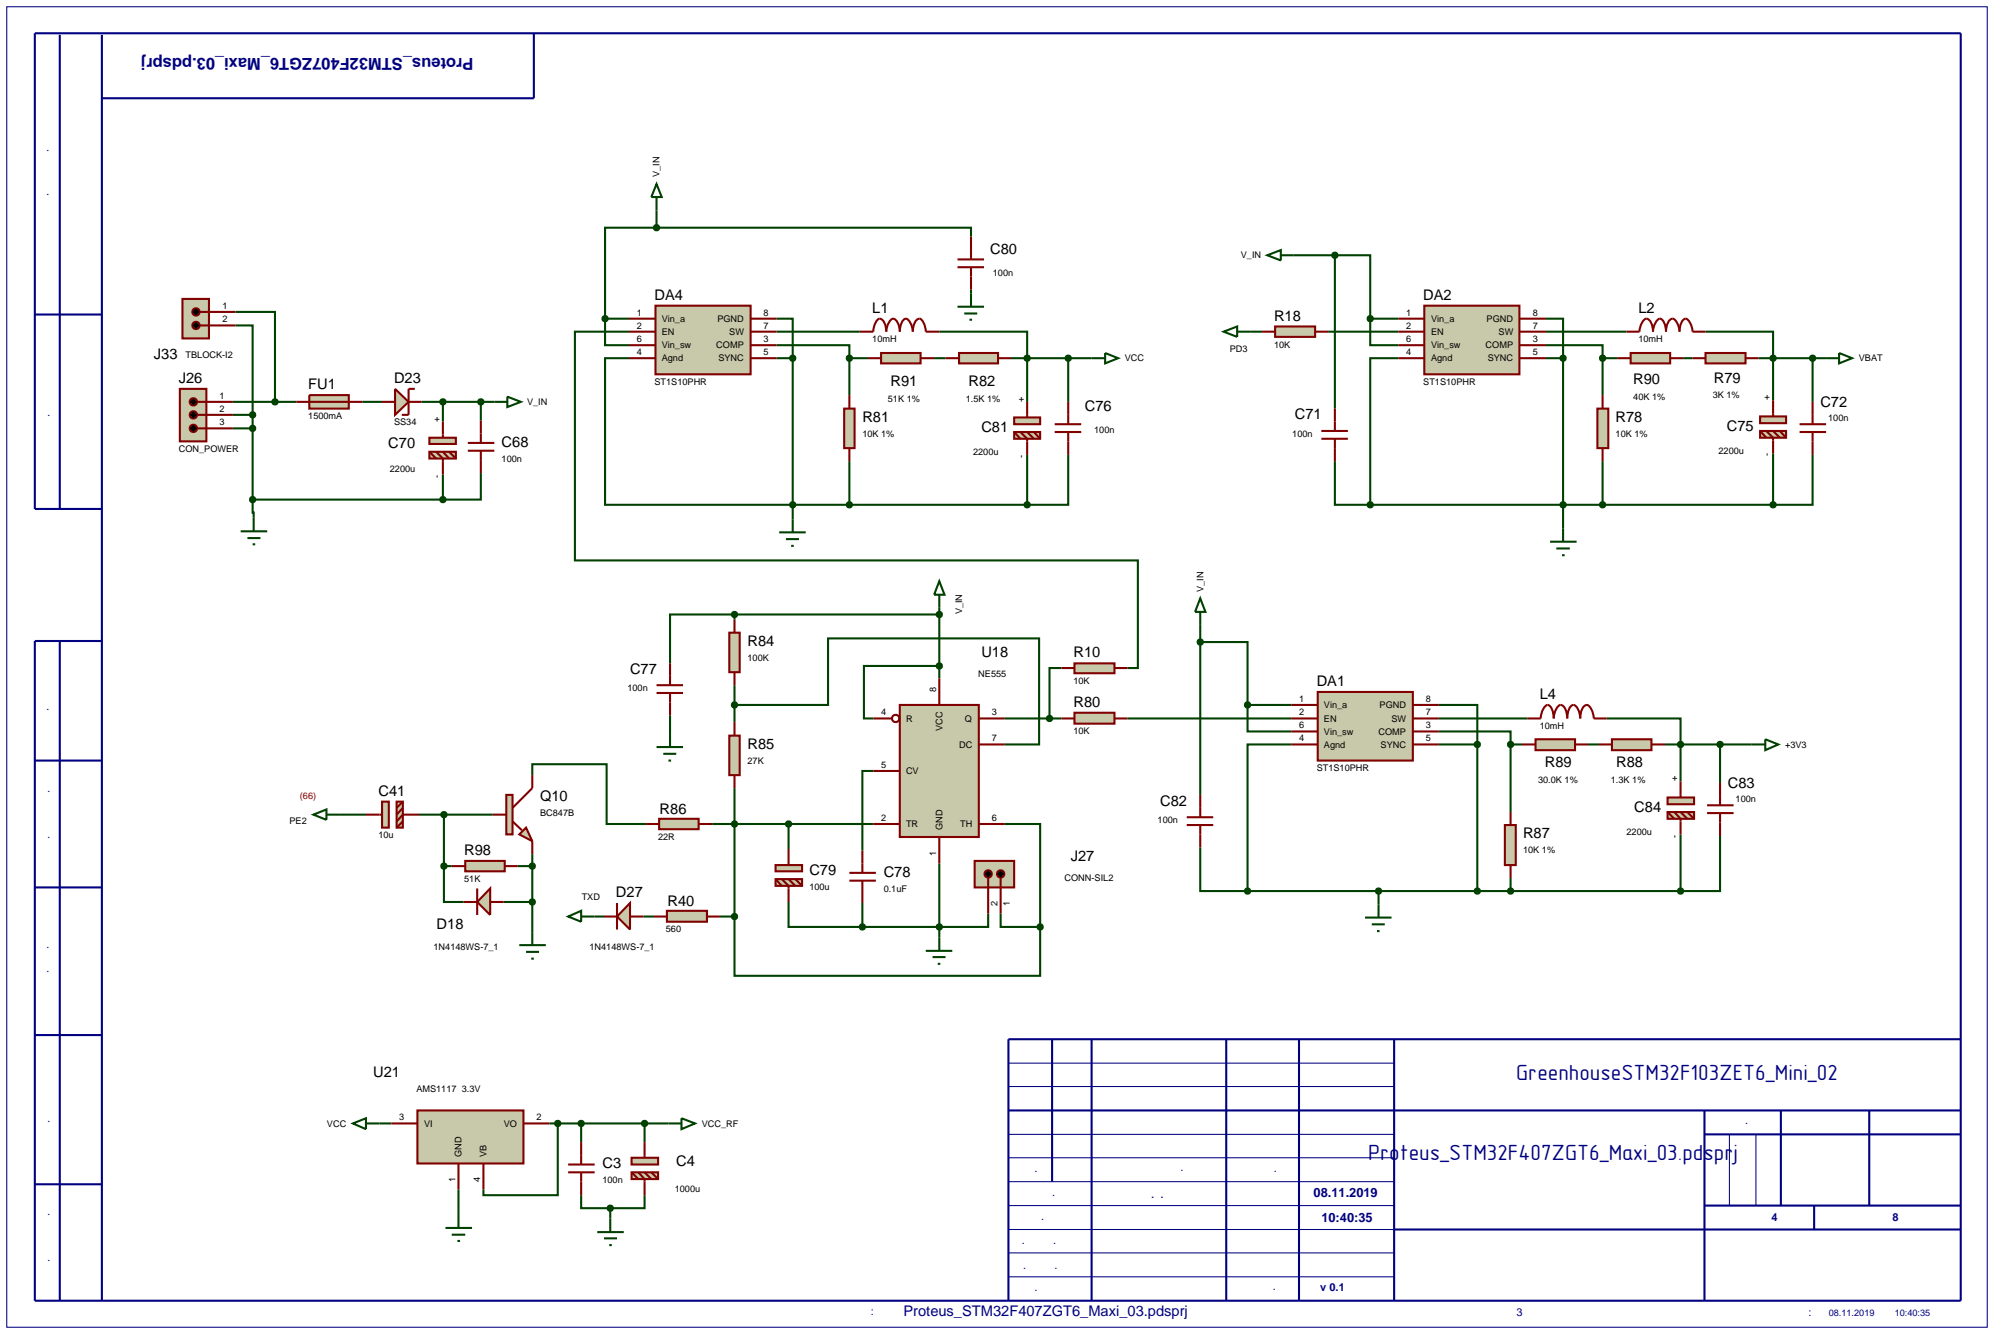
[picture p26: page 4]

Инв. № подл. Подп. и дата Взам. инв. № Инв. № дубл. Справ. № Перв. примен. Подп. и дата

GreenhouseSTM32F103ZET6_Mini_02

Лит. | Масса | Масштаб

Изм. | Лист | № докум. | Подп. | Дата

Разраб. | | Мосейчук А.В. | | 08.11.2019
Пров. | | | 10:40:35 | | Лист 4 8 | Листов

D6

J18

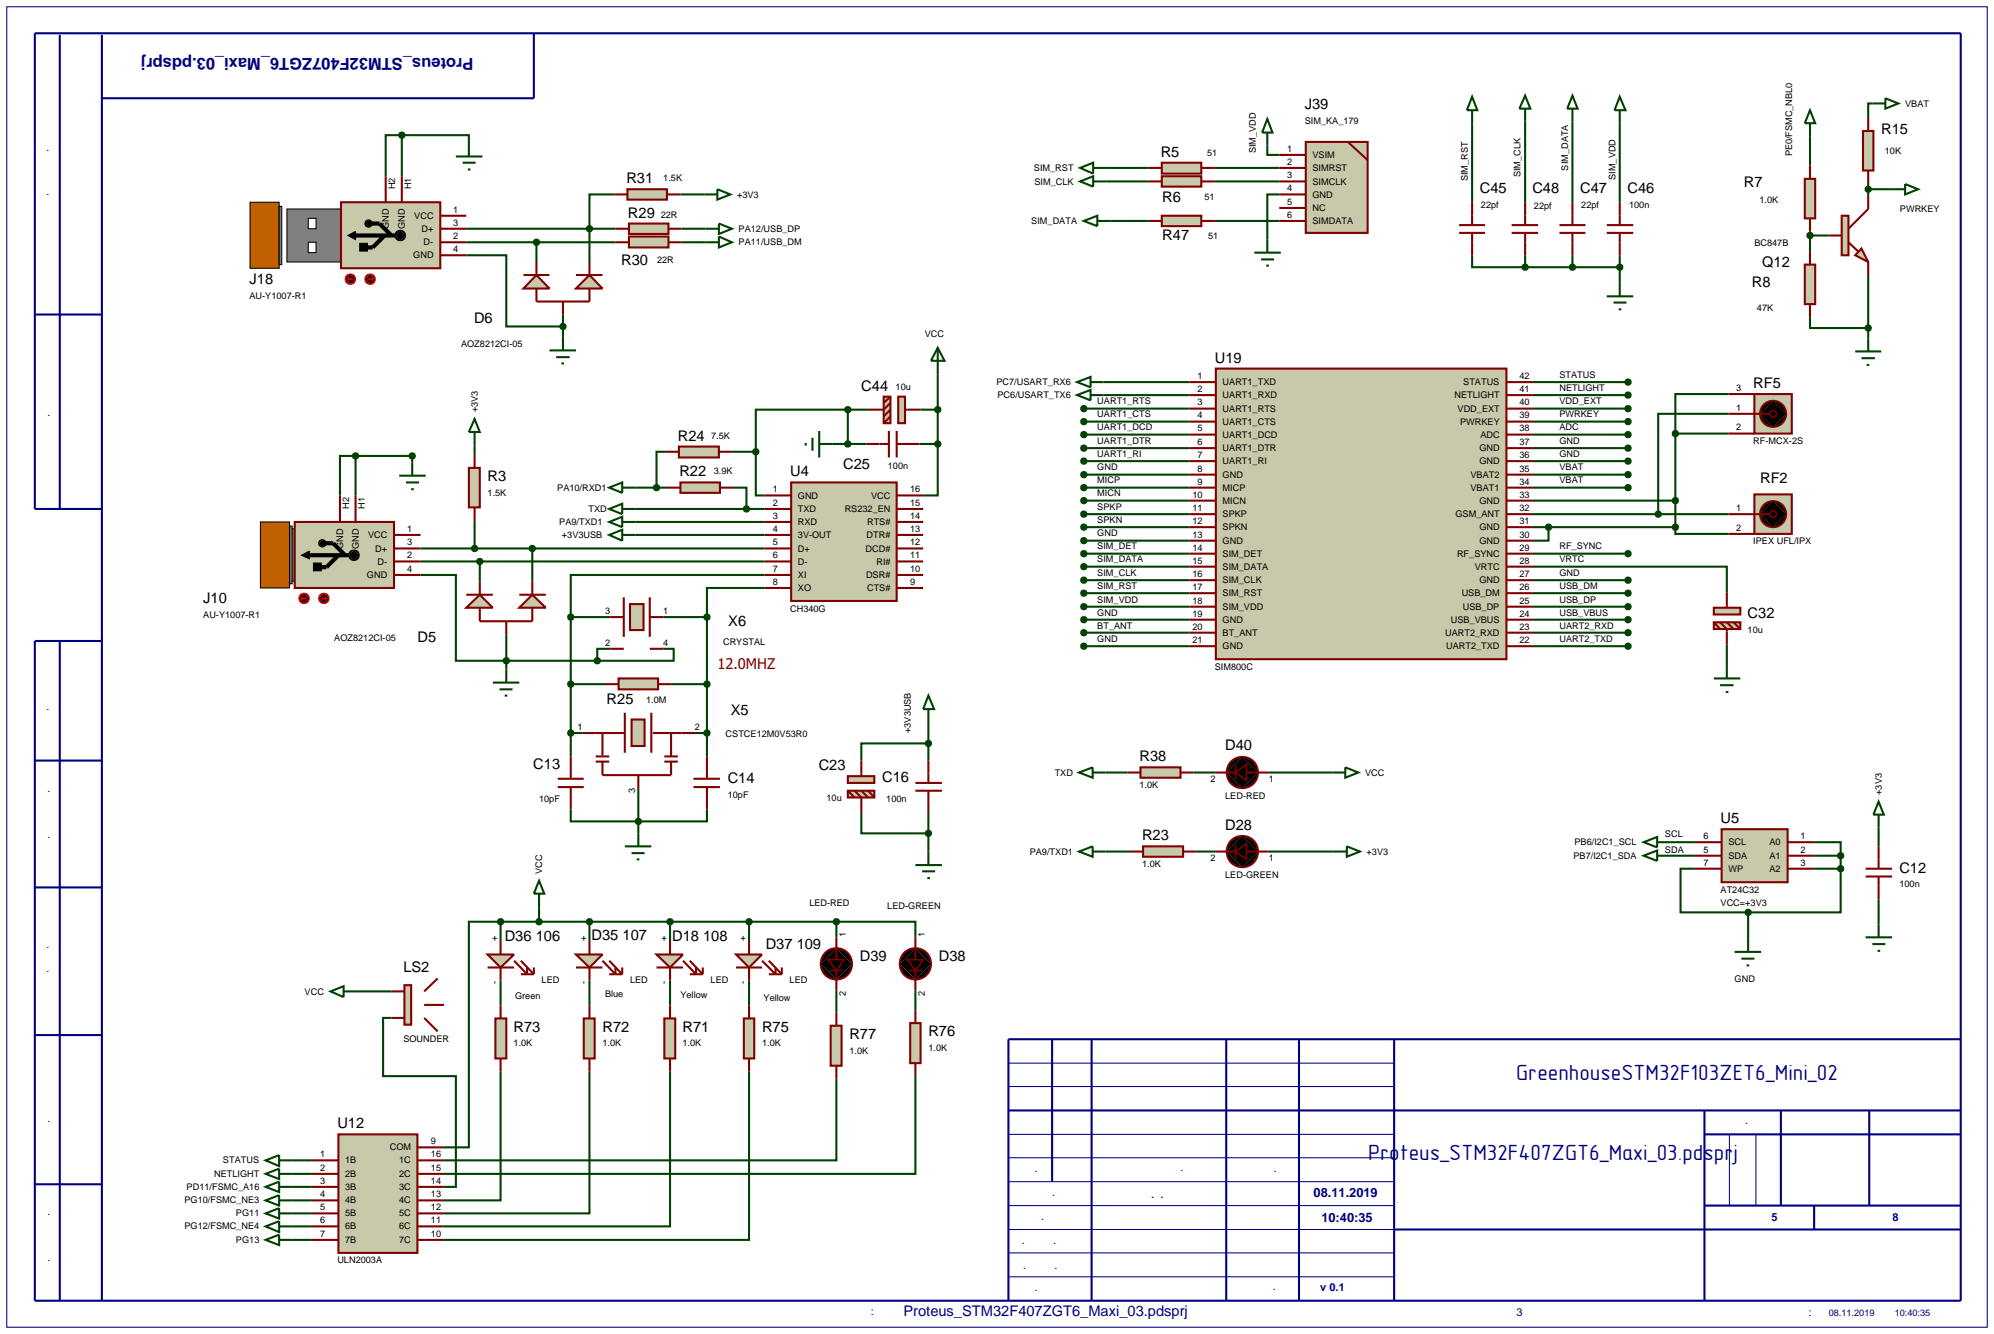
[picture p27: page 5]

Инв. № подл. Подп. и дата Взам. инв. № Инв. № дубл. Справ. № Перв. примен. Подп. и дата

GreenhouseSTM32F103ZET6_Mini_02

Лит. | Масса | Масштаб

U6
RN7

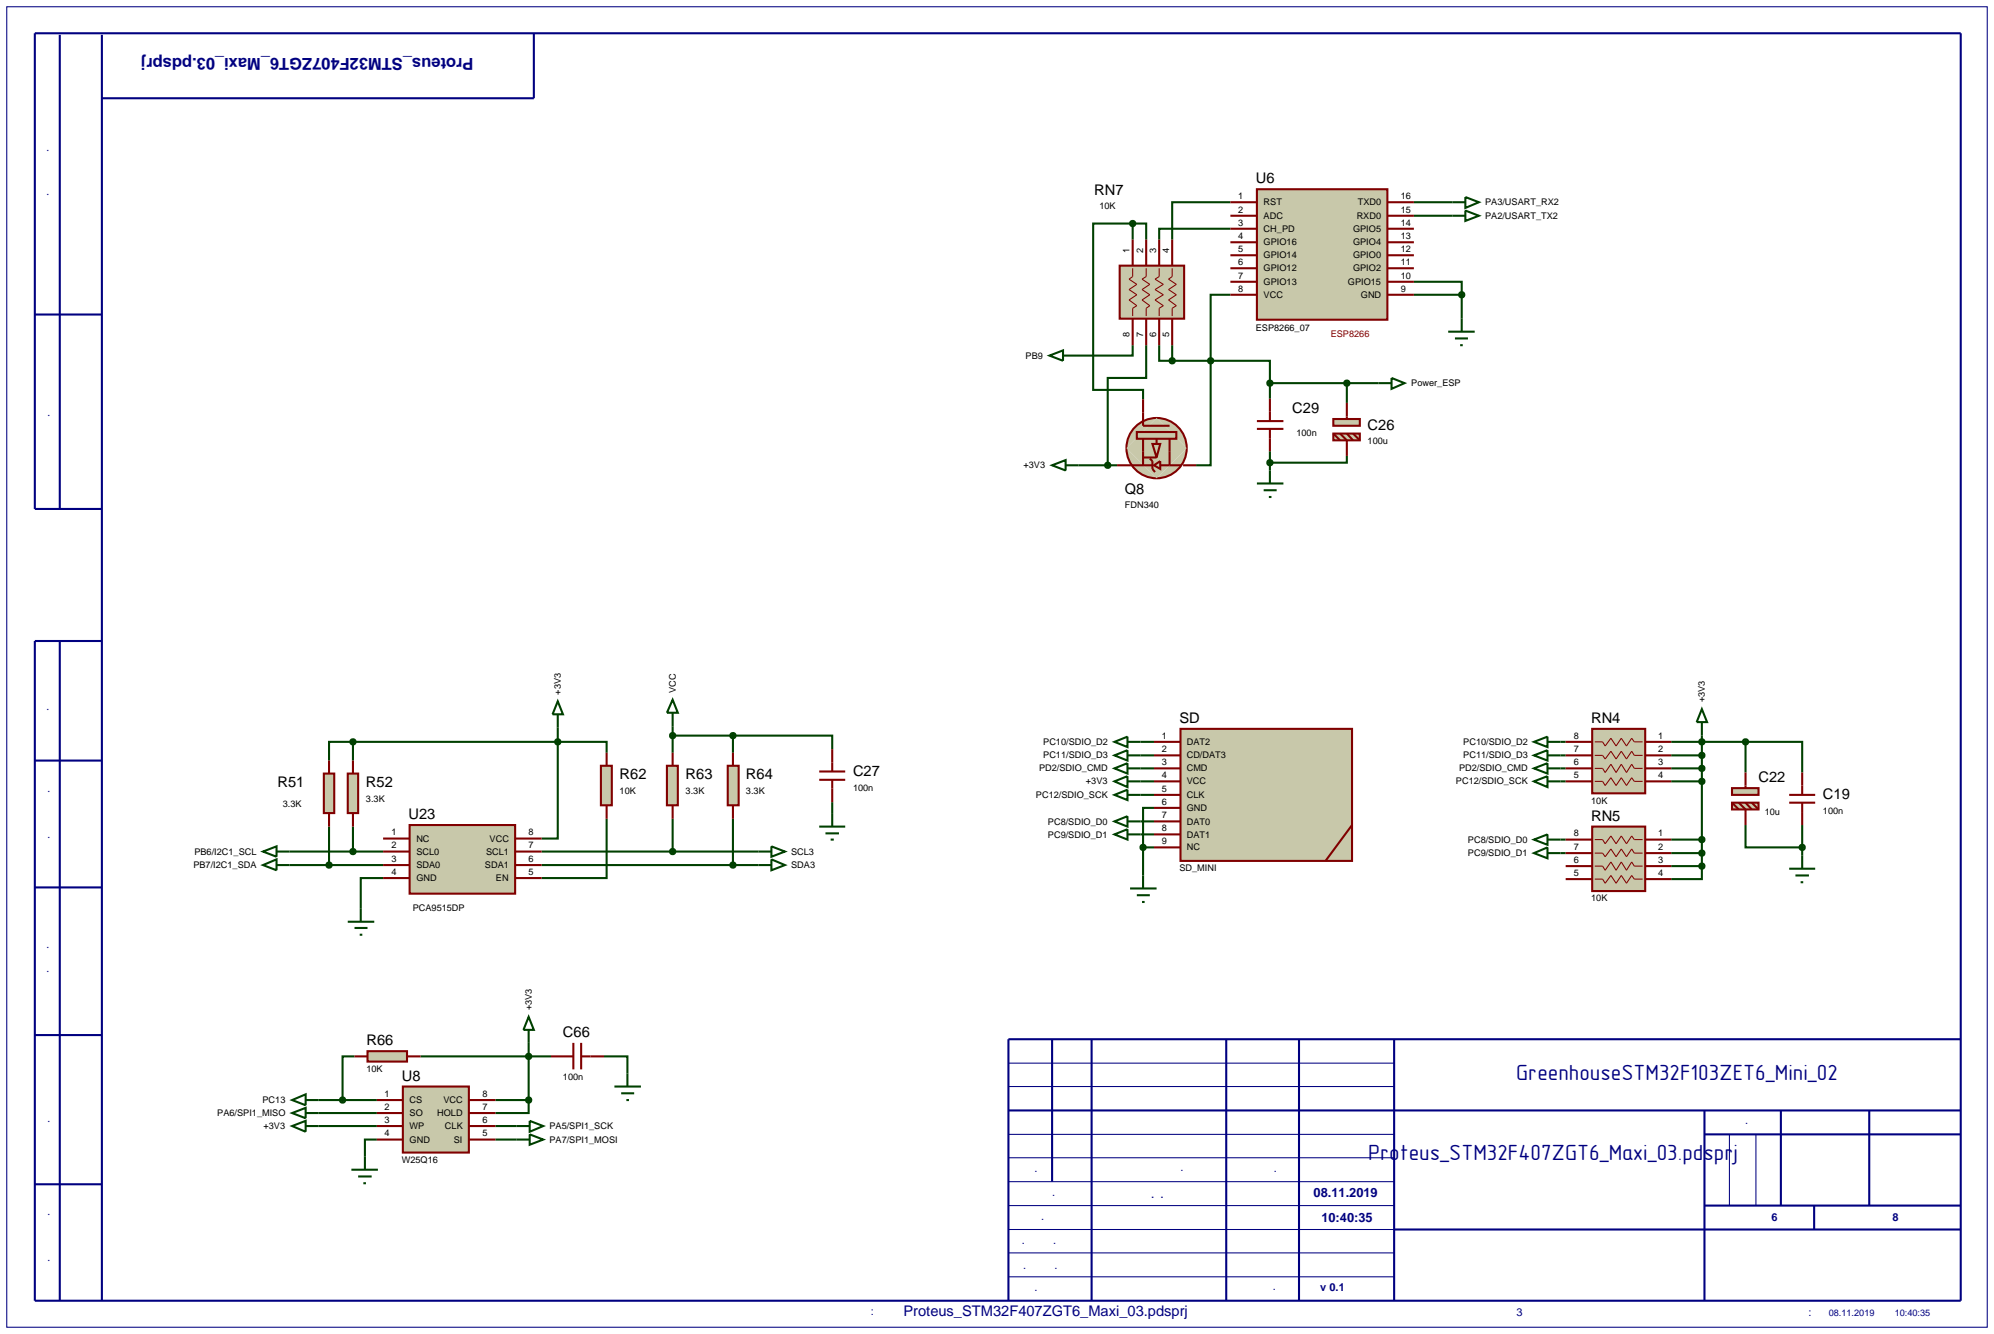
[picture p28: page 6]

Инв. № подл. Подп. и дата Взам. инв. № Инв. № дубл. Справ. № Перв. примен. Подп. и дата

GreenhouseSTM32F103ZET6_Mini_02

Лит. | Масса | Масштаб

Изм. | Лист | № докум. | Подп. | Дата

Разраб. | | Мосейчук А.В. | | 08.11.2019
Пров. | | | 10:40:35 | | Лист 6 8 | Листов

U17

J16

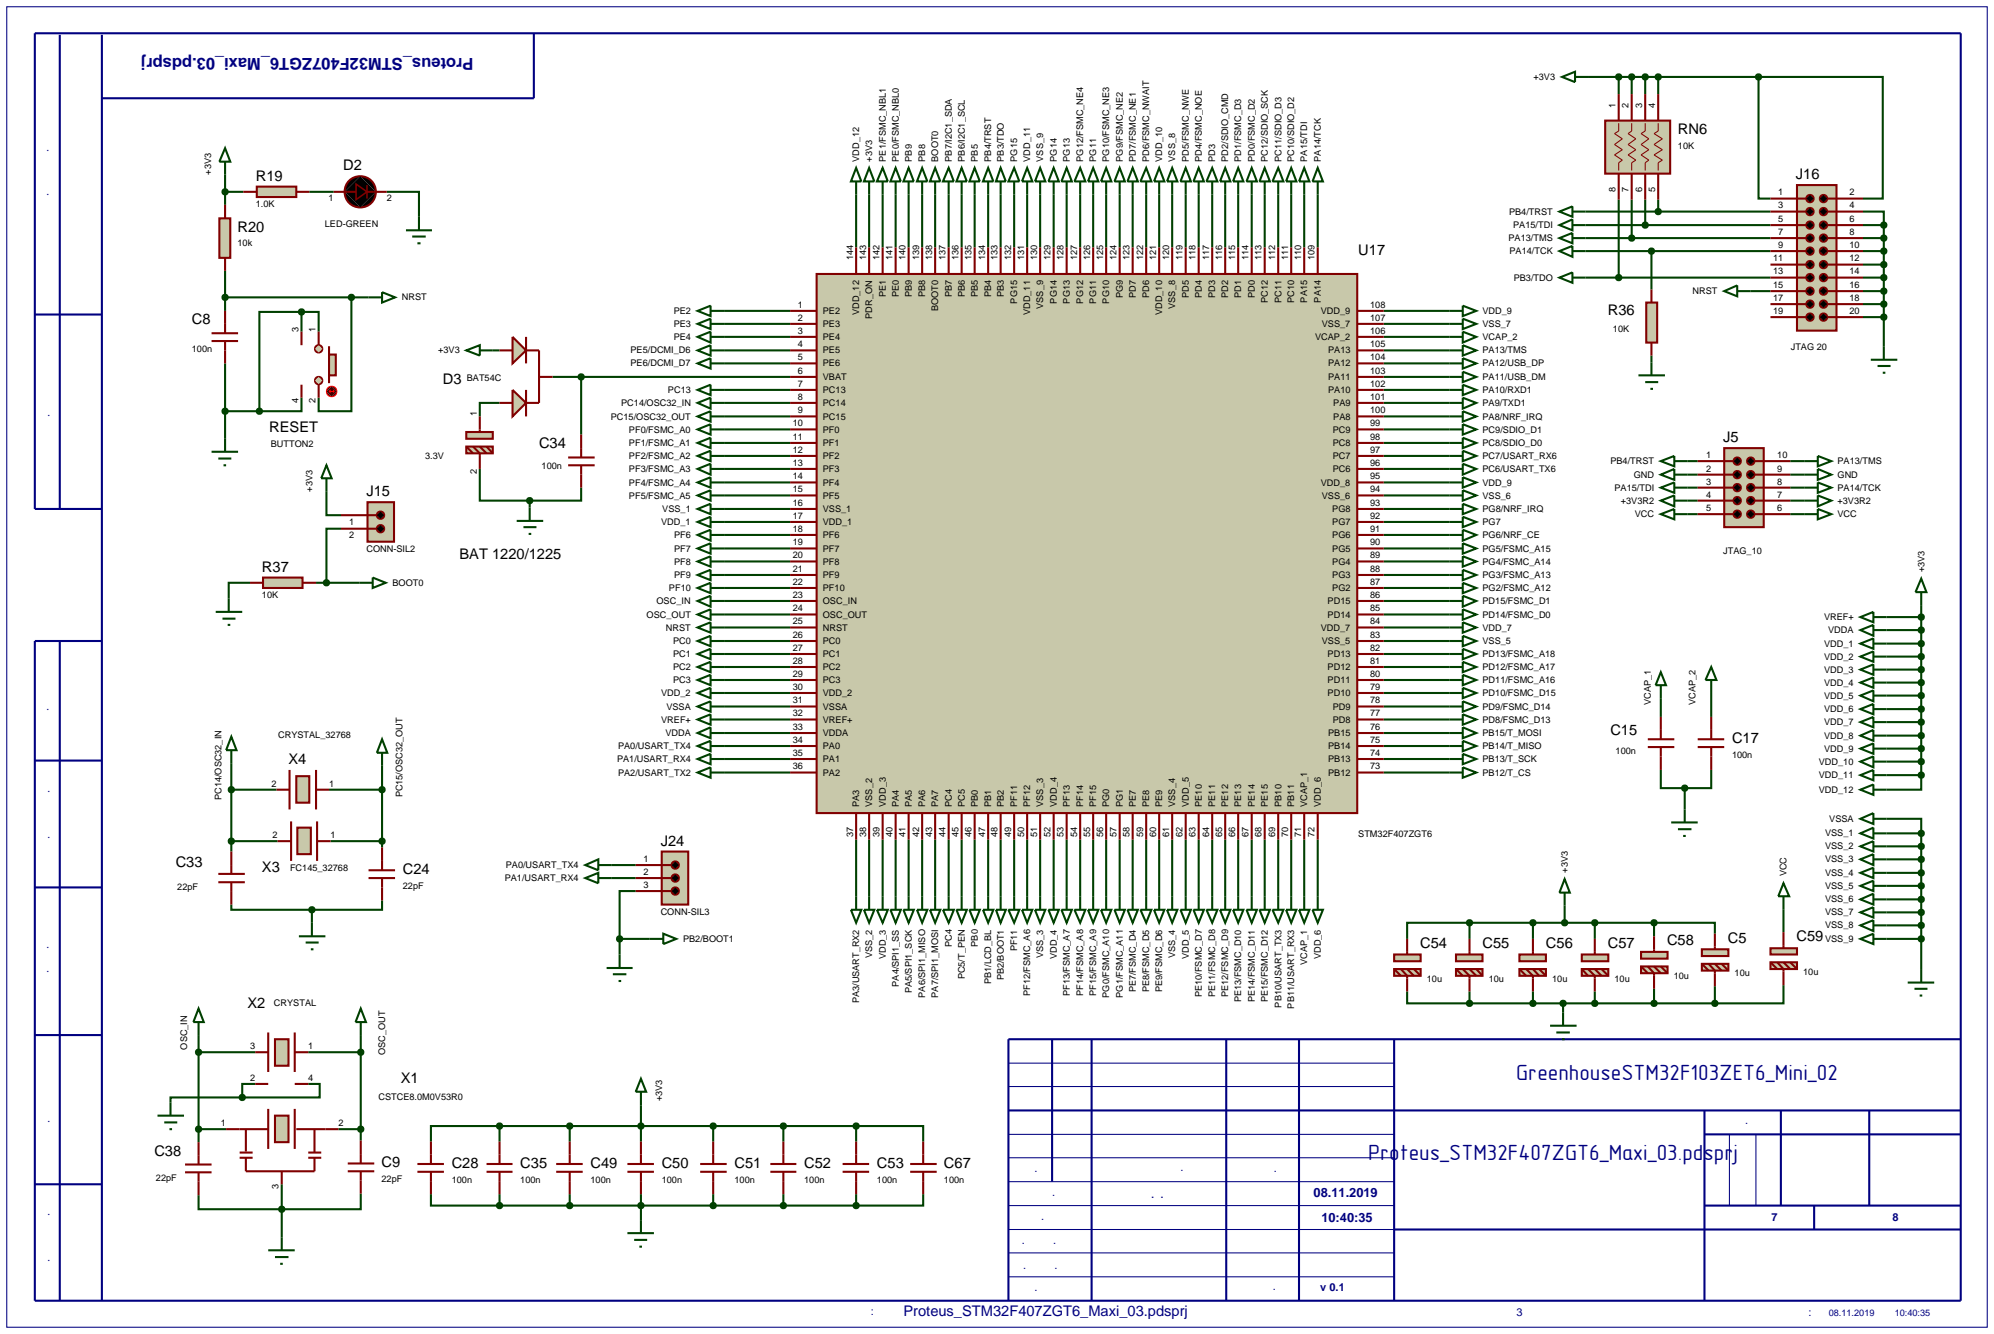
[picture p29: page 7]

Инв. № подл. Подп. и дата Взам. инв. № Инв. № дубл. Справ. № Перв. примен. Подп. и дата

GreenhouseSTM32F103ZET6_Mini_02

Лит. | Масса | Масштаб

Изм. | Лист | № докум. | Подп. | Дата

Разраб. | | Мосейчук А.В. | | 08.11.2019
Пров. | | | 10:40:35 | | Лист 7 8 | Листов

R83

## RN1 10K

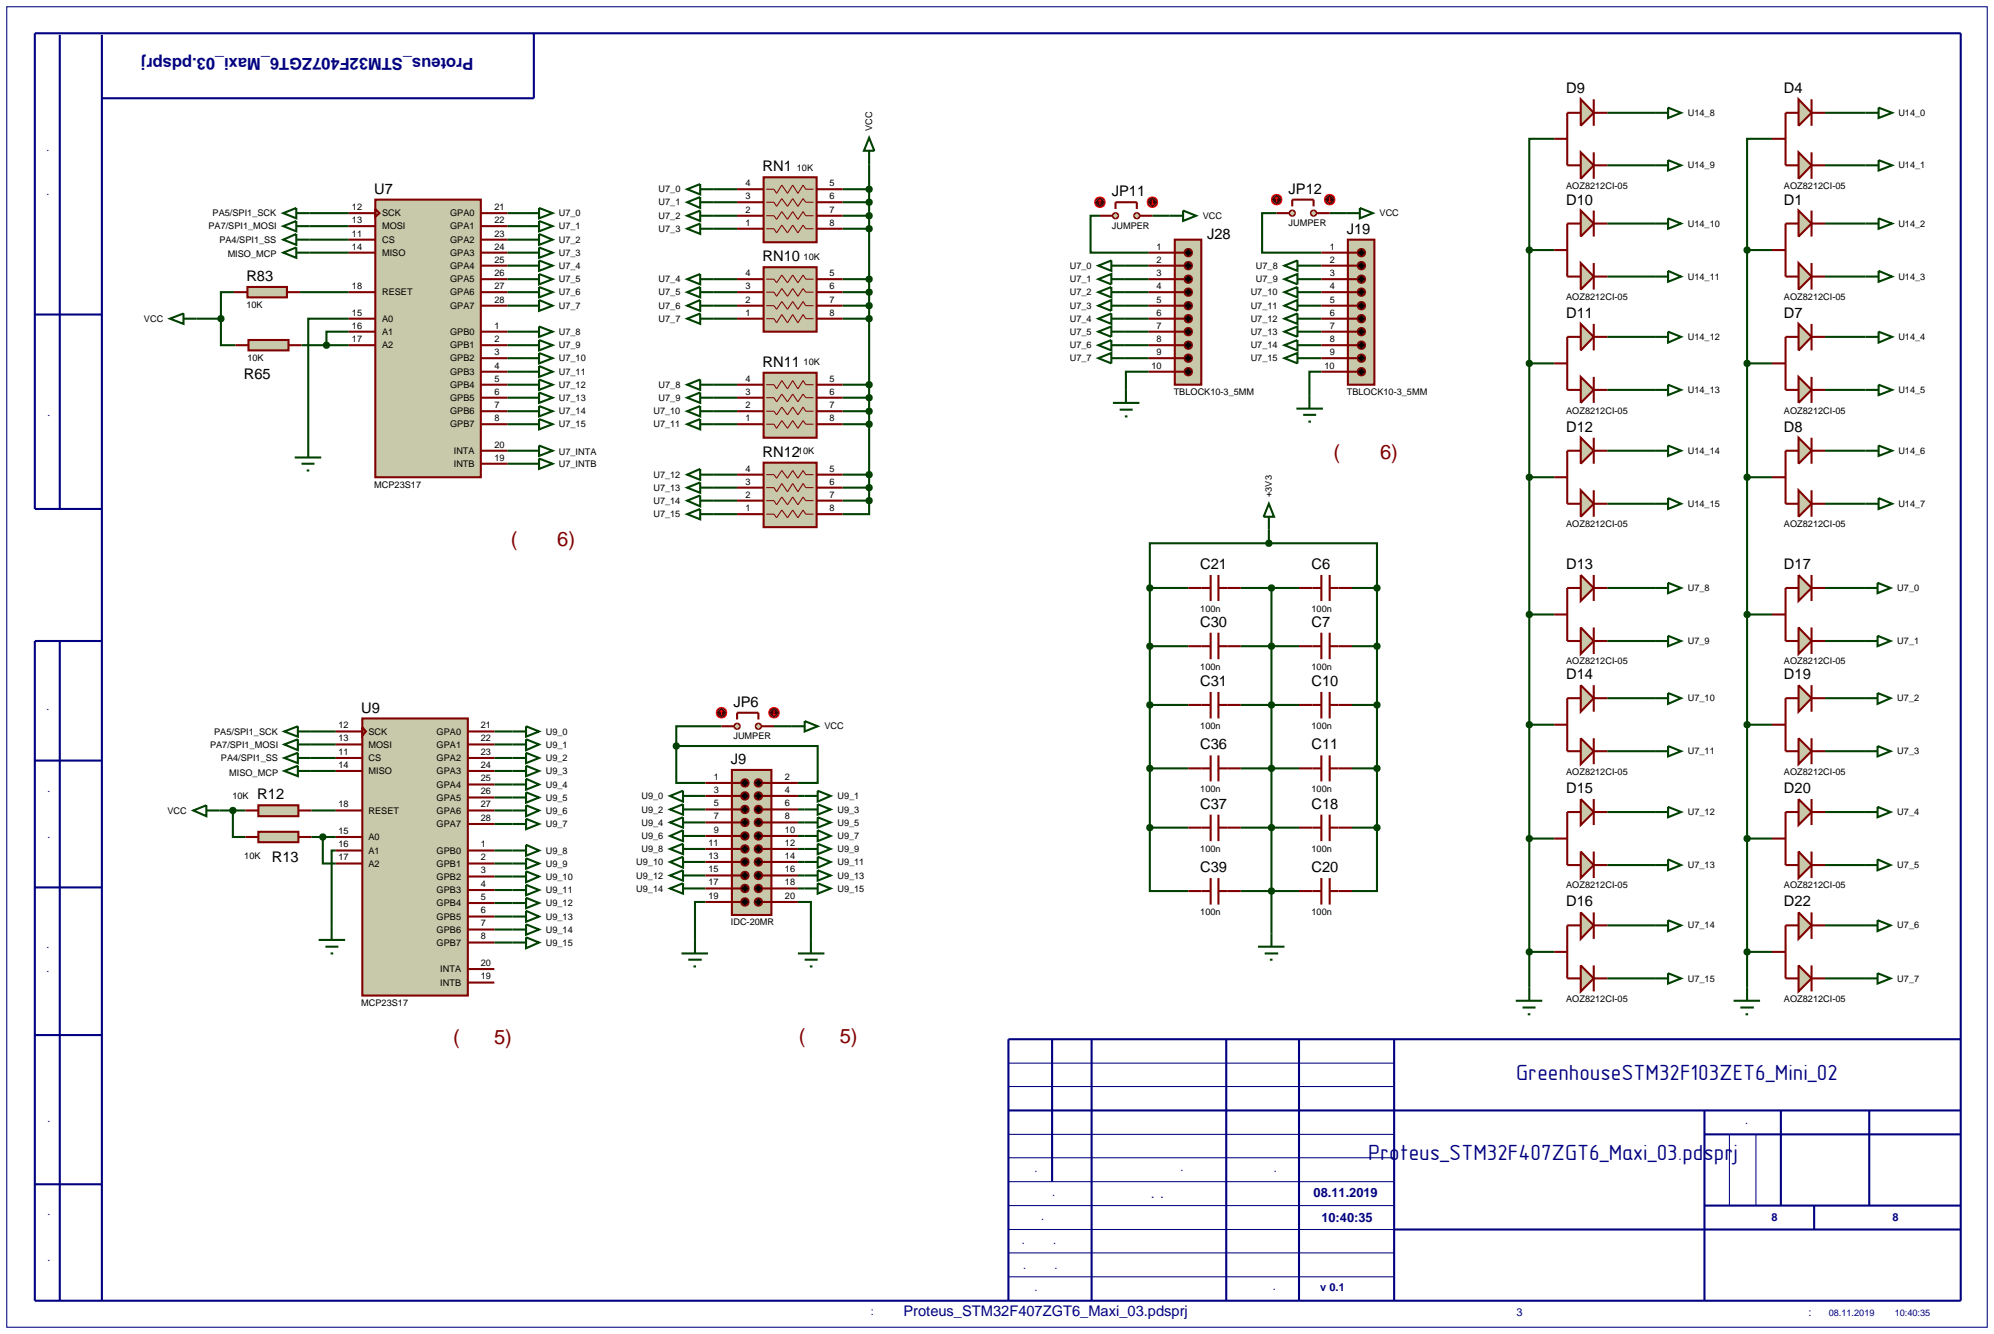
[picture p30: page 8]

Инв. № подл. Подп. и дата Взам. инв. № Инв. № дубл. Справ. № Перв. примен. Подп. и дата

Разъем блока резерных портов (адр 6)

Блок резерных портоа (адр 6)

GreenhouseSTM32F103ZET6_Mini_02

Лит. | Масса | Масштаб

Изм. | Лист | № докум. | Подп. | Дата

Разраб. | | Мосейчук А.В. | | 08.11.2019
Пров. | | | 10:40:35 | | Лист 8 8 | Листов
