madeonline/GreenhouseProject_continuation/Инструкции на контроллер теплицы/Аппаратная информация/STM32F407ZGT6_Middle03R.PDF

J7

J20

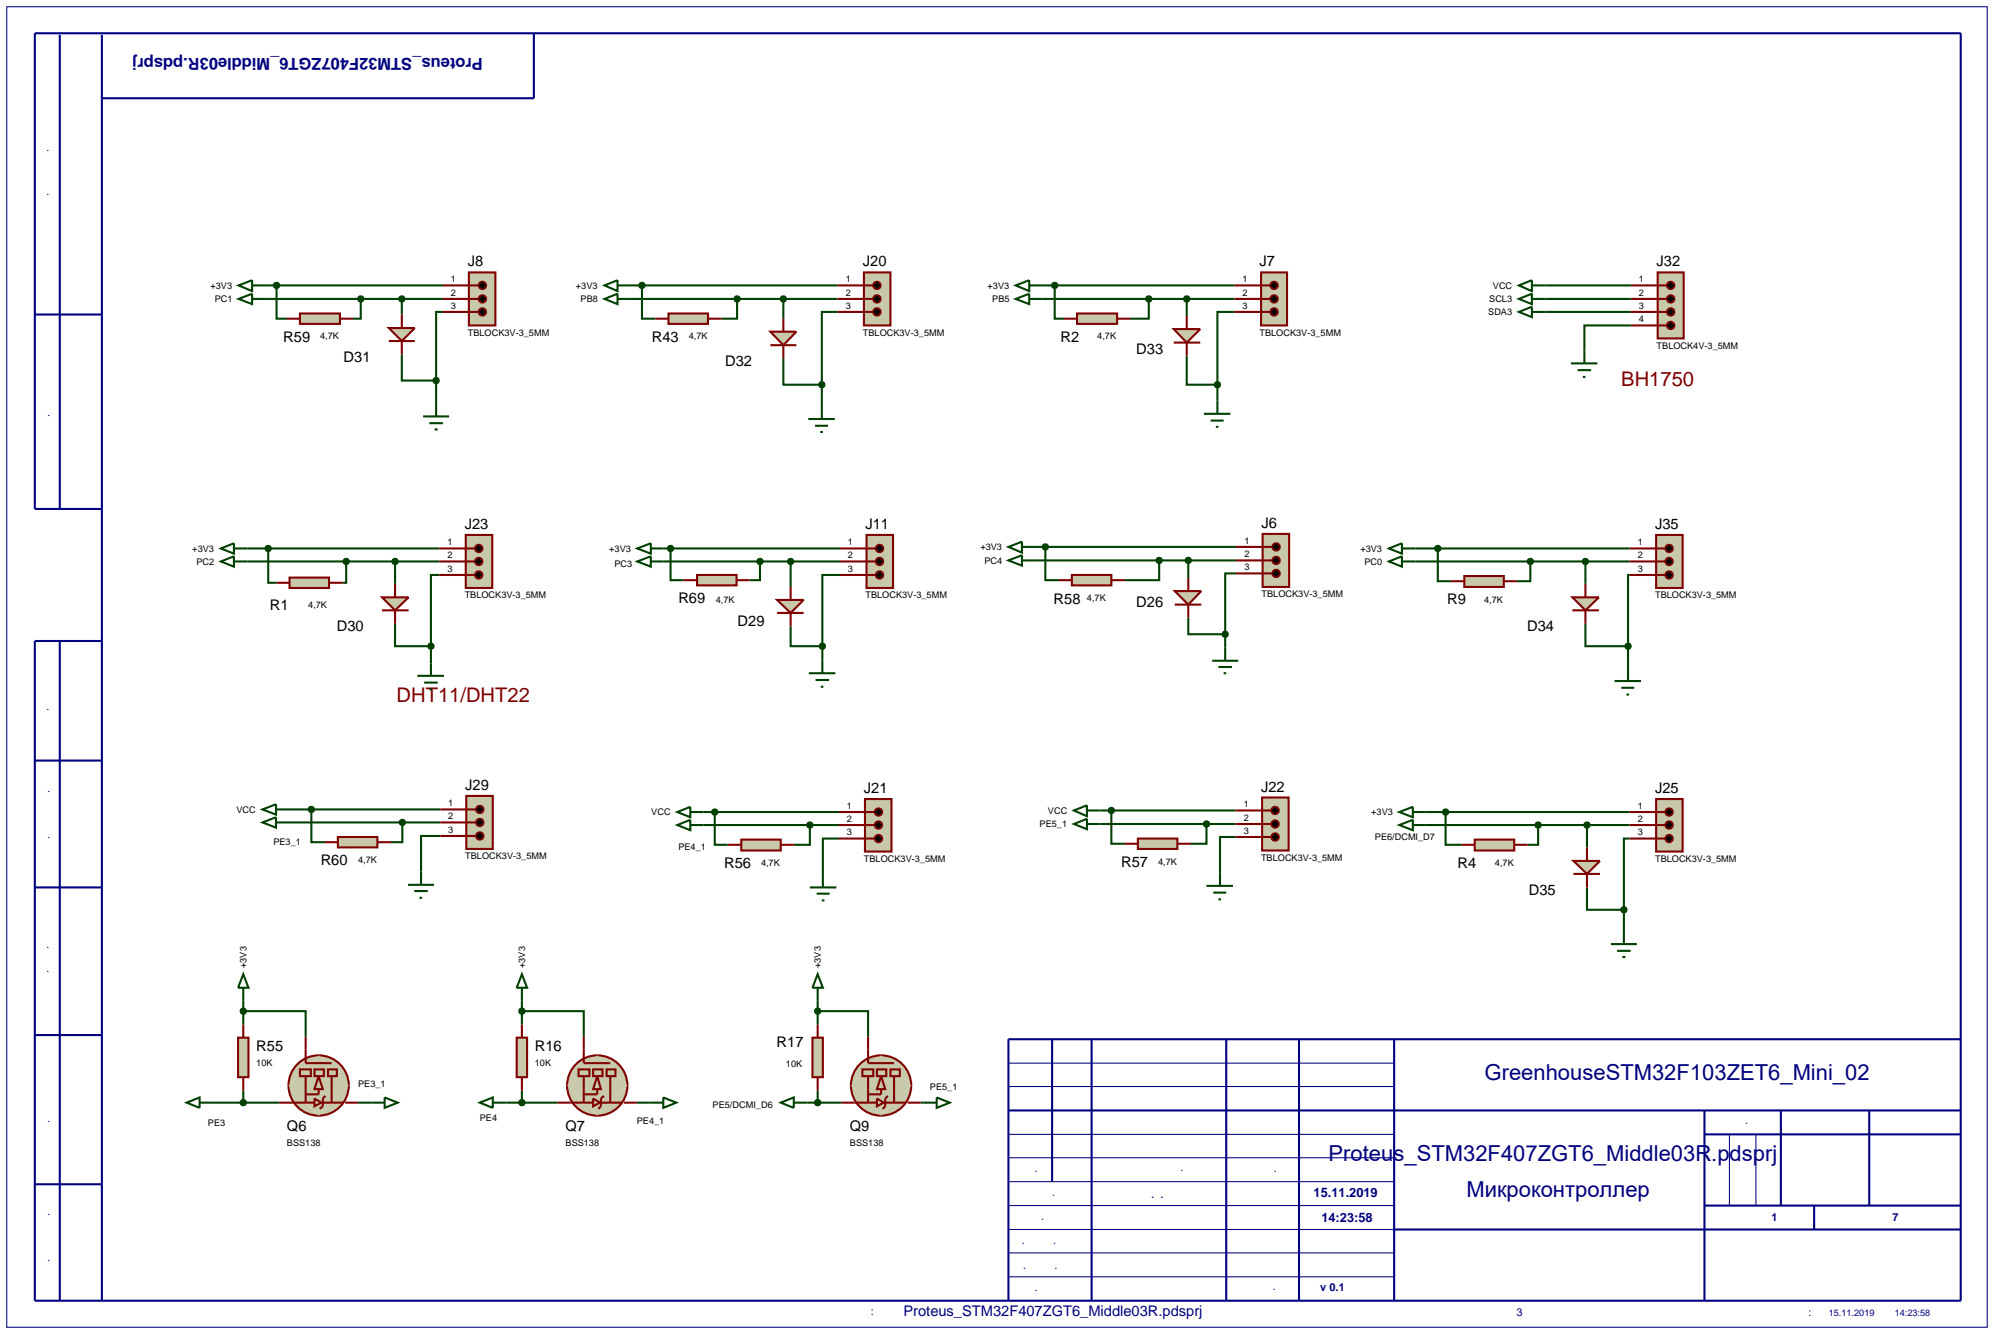
[picture p31: page 1]

Инв. № подл. Подп. и дата Взам. инв. № Инв. № дубл. Справ. № Перв. примен. Подп. и дата

GreenhouseSTM32F103ZET6_Mini_02

Микроконтроллер | Лит. | Масса | Масштаб

Изм. | Лист | № докум. | Подп. | Дата

Разраб. | | Мосейчук А.В. | | 15.11.2019
Пров. | | | 14:23:58 | | Лист 1 7 | Листов
Т.контр.

Н.контр.
Утв. | | Ревиз. | v 0.1

## LCD1

U3

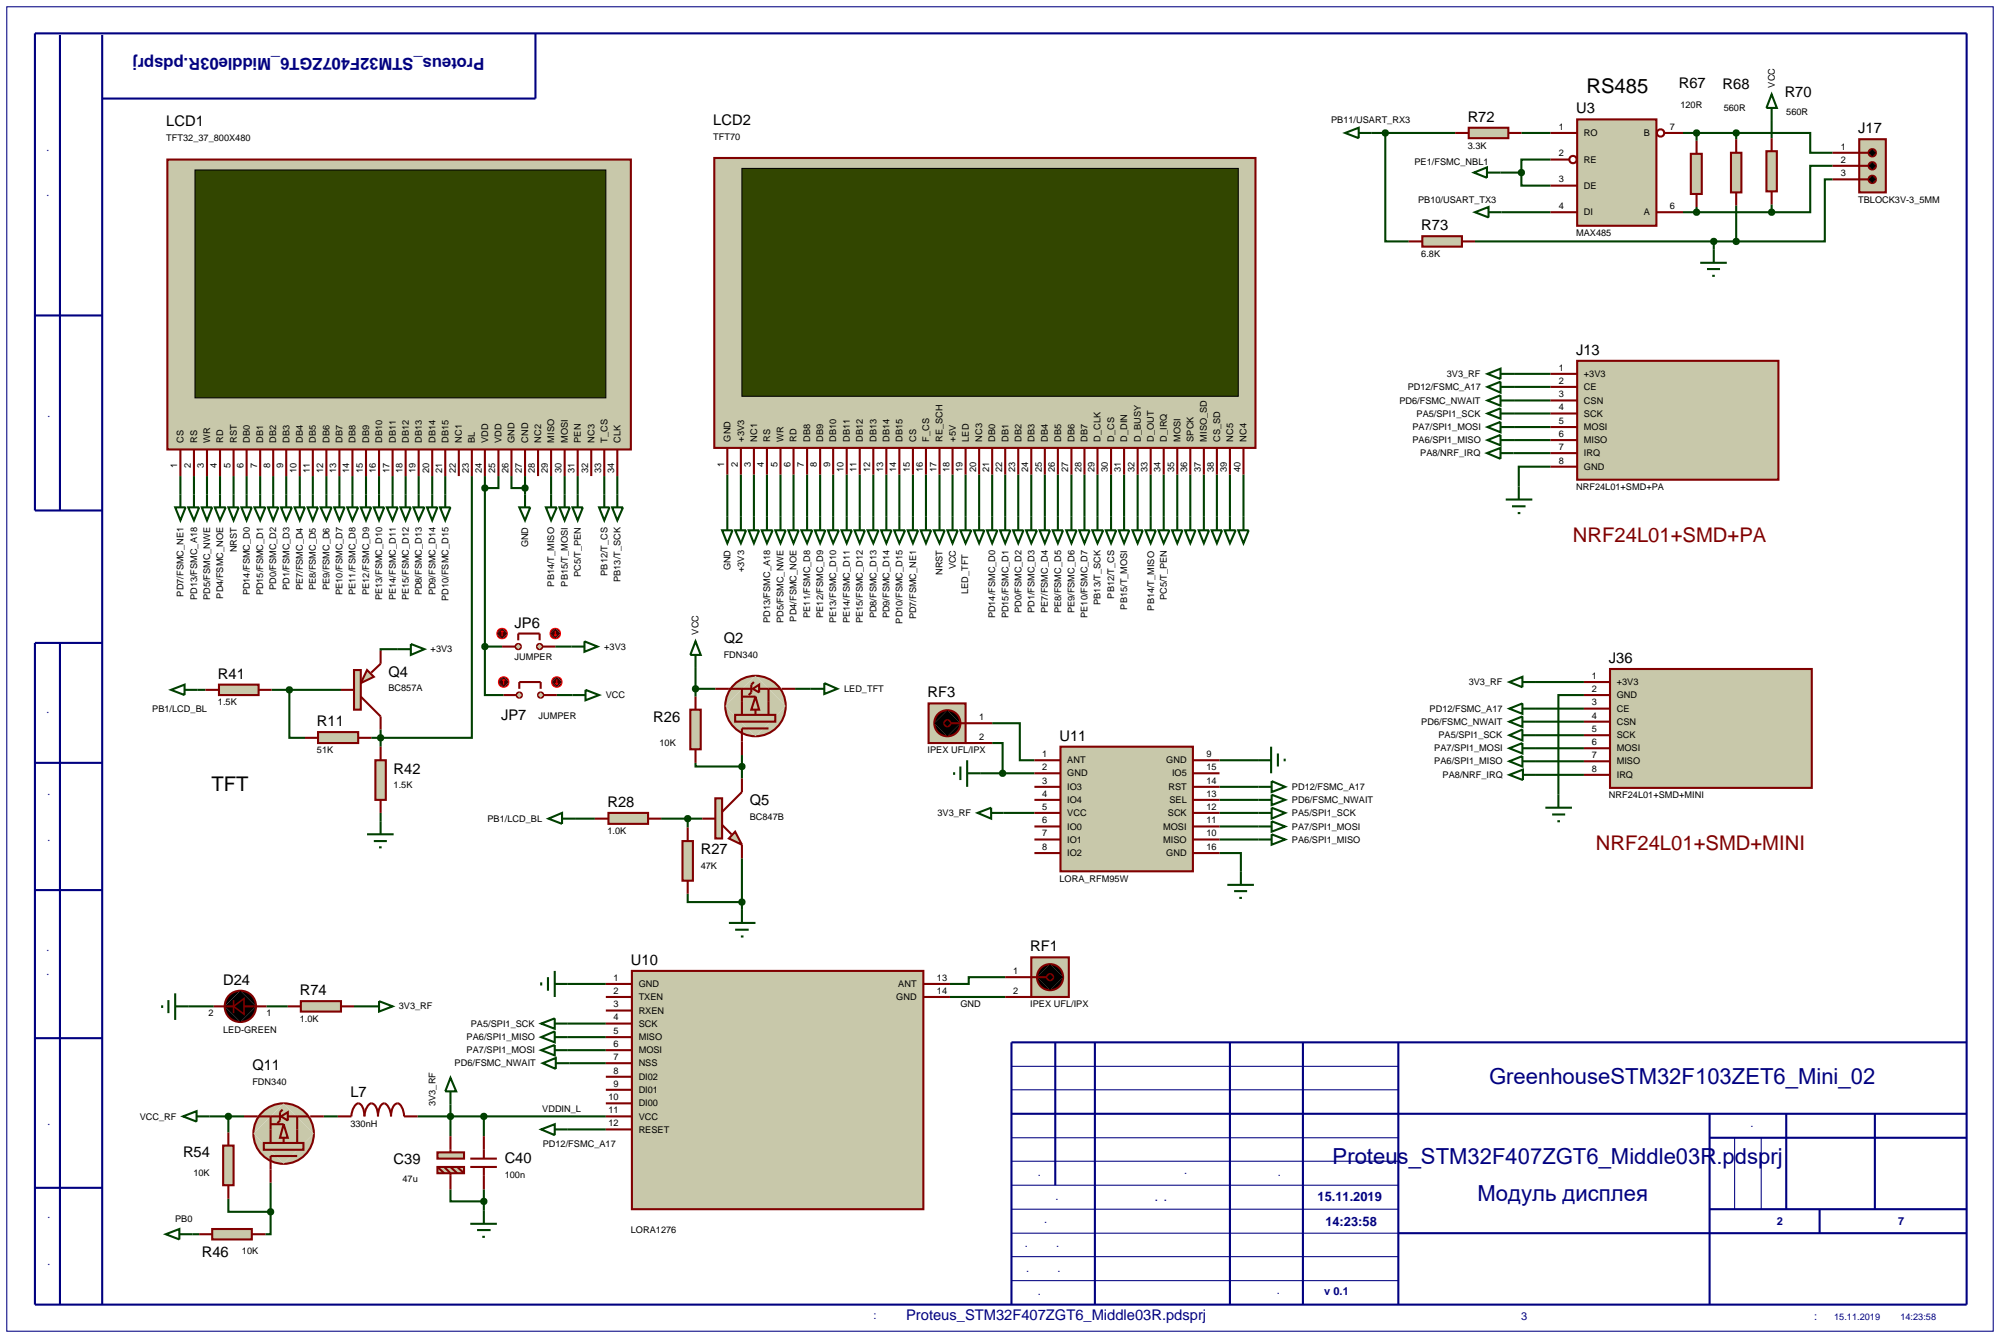
[picture p32: page 2]

Инв. № подл. Подп. и дата Взам. инв. № Инв. № дубл. Справ. № Перв. примен. Подп. и дата

Изм. | Лист | № докум. | Подп. | Дата

Разраб. | | Мосейчук А.В. | | 15.11.2019
Пров. | | | 14:23:58 | | Лист 2 7 | Листов

U2
Q1

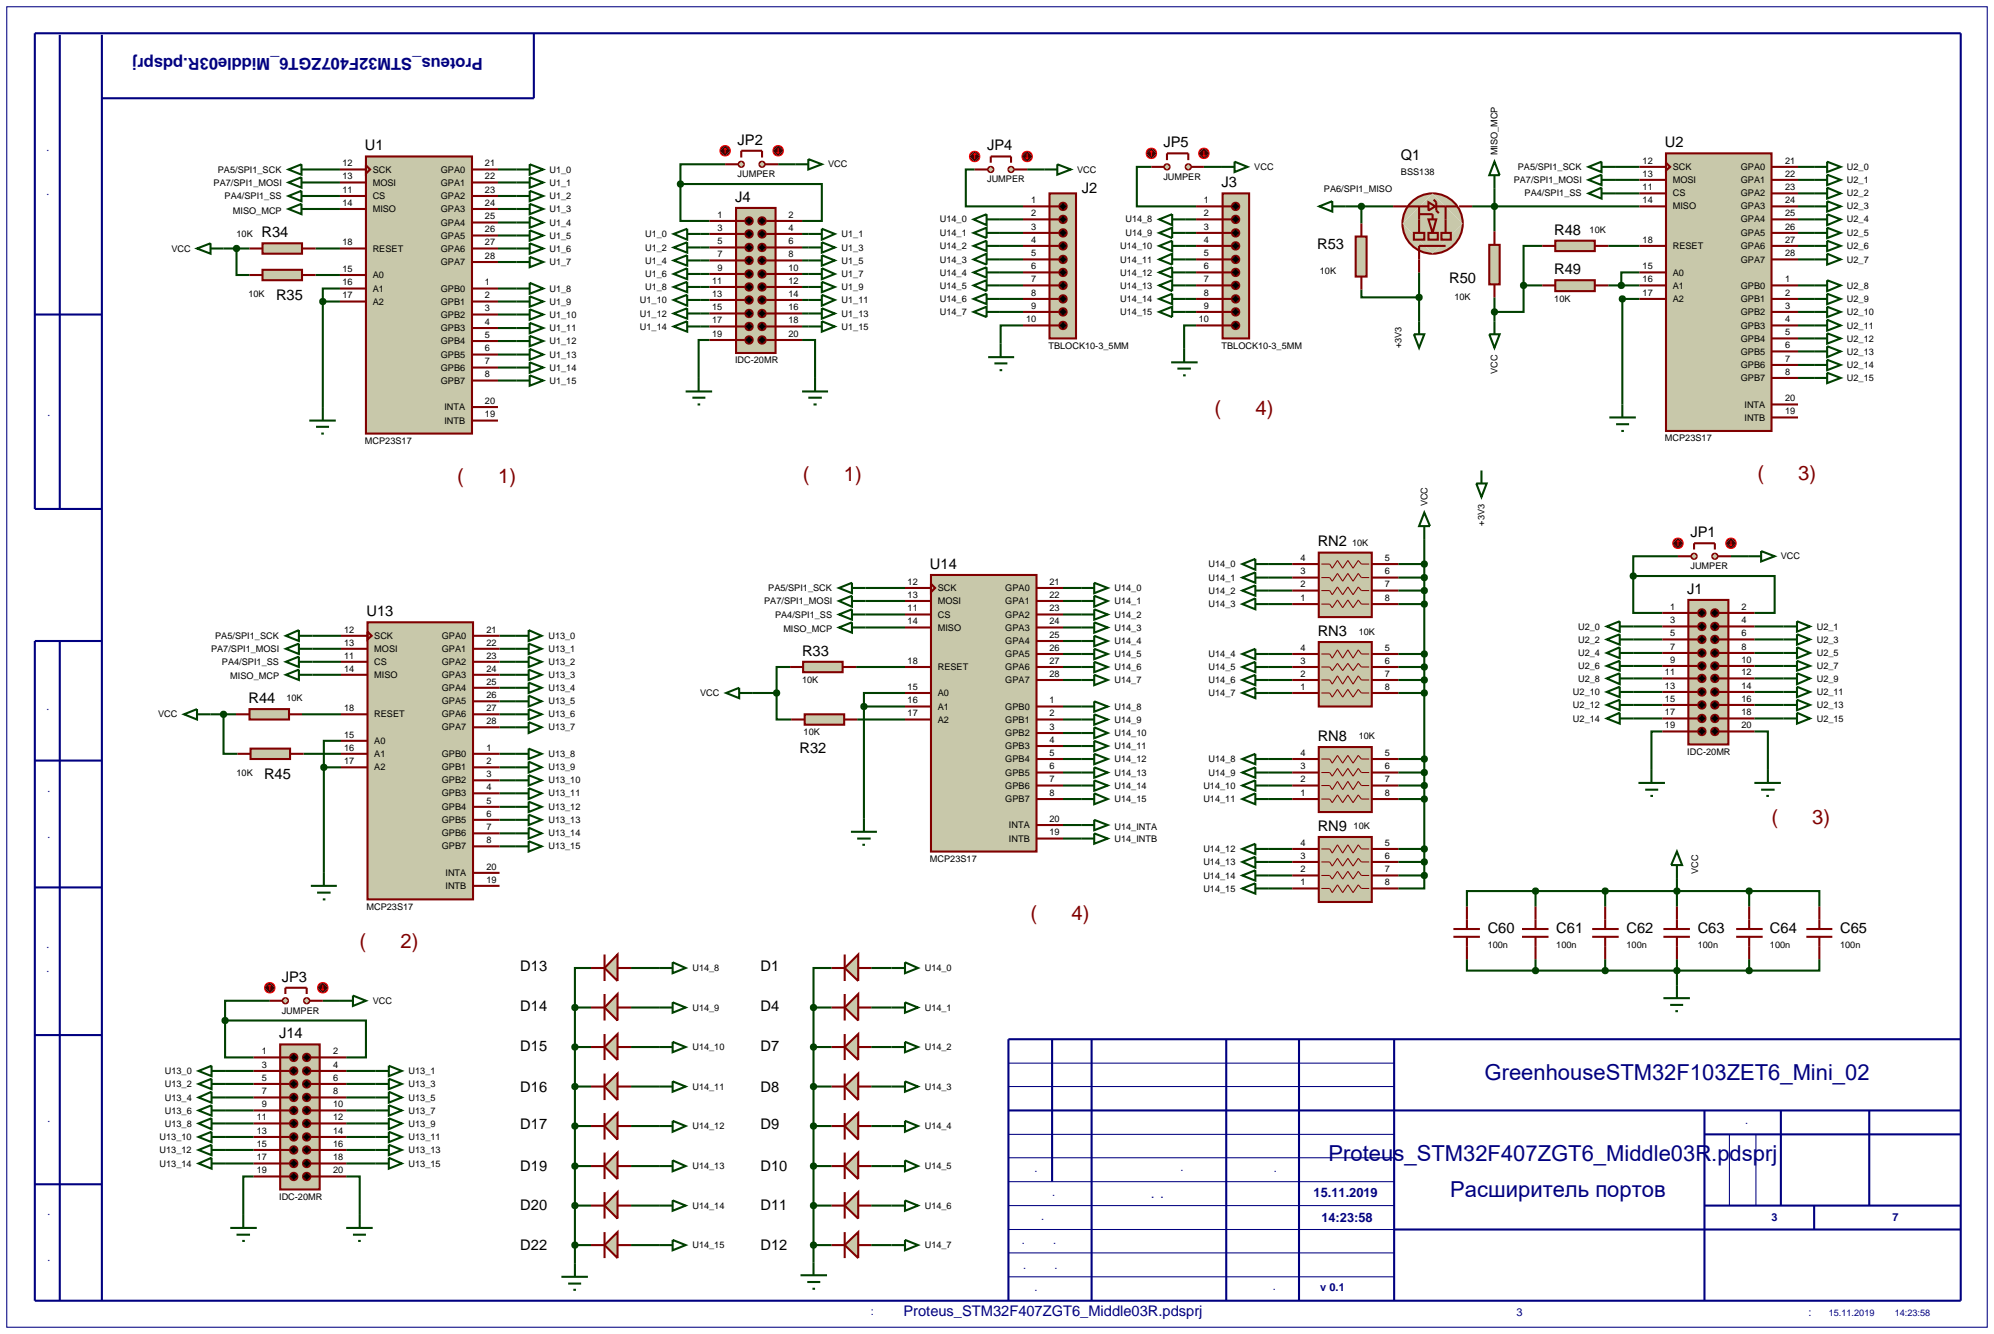
[picture p33: page 3]

Инв. № подл. Подп. и дата Взам. инв. № Инв. № дубл. Справ. № Перв. примен. Подп. и дата

GreenhouseSTM32F103ZET6_Mini_02

Расширитель портов | Лит. | Масса | Масштаб

Изм. | Лист | № докум. | Подп. | Дата

Разраб. | | Мосейчук А.В. | | 15.11.2019
Пров. | | | 14:23:58 | | Лист 3 7 | Листов

C30

R10

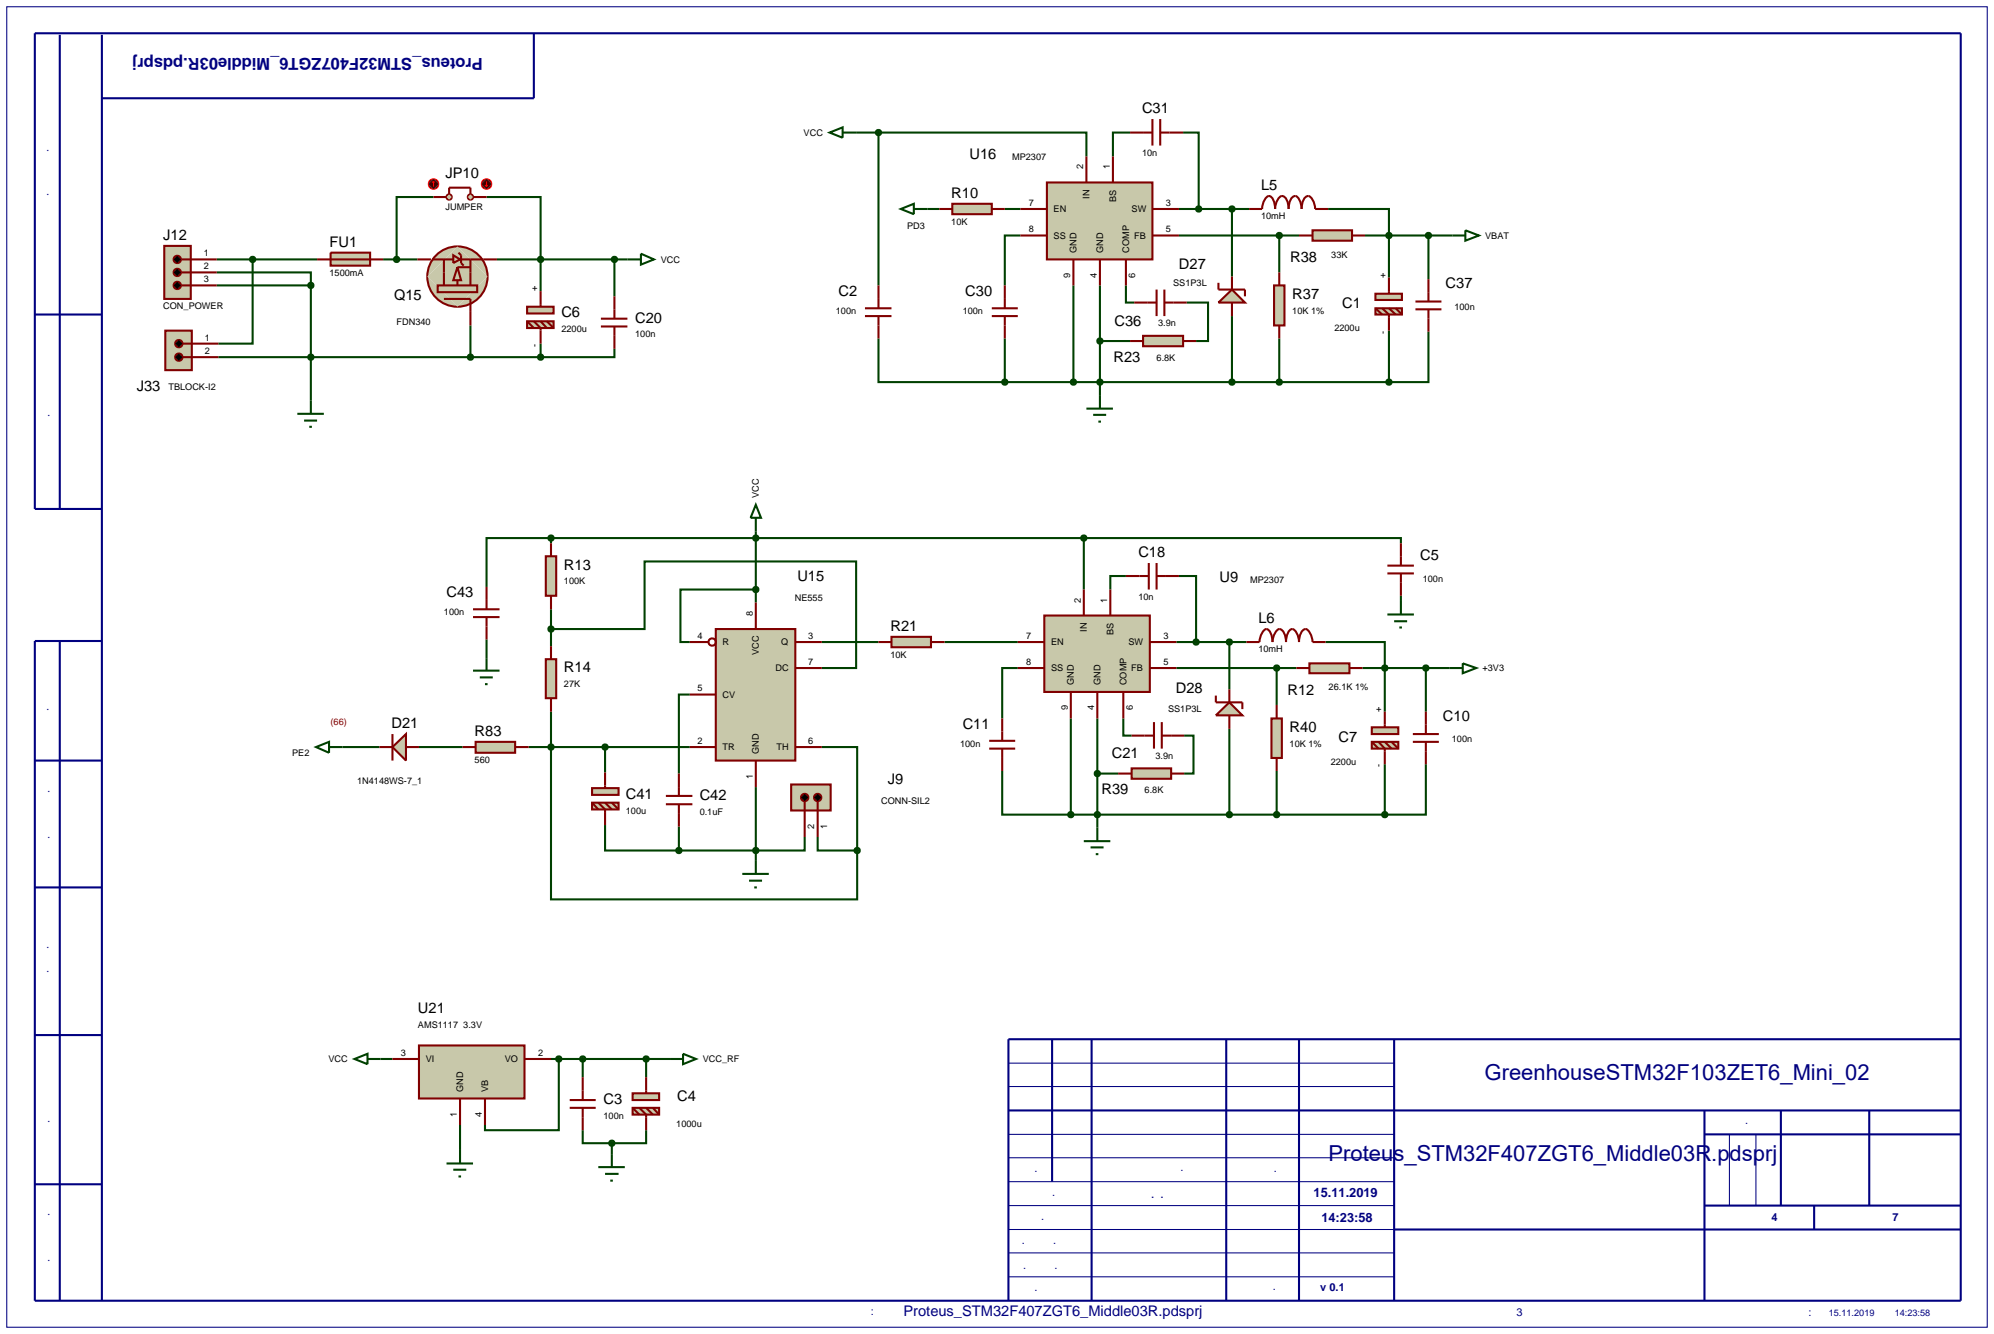
[picture p34: page 4]

Инв. № подл. Подп. и дата Взам. инв. № Инв. № дубл. Справ. № Перв. примен. Подп. и дата

GreenhouseSTM32F103ZET6_Mini_02

Лит. | Масса | Масштаб

Изм. | Лист | № докум. | Подп. | Дата

Разраб. | | Мосейчук А.В. | | 15.11.2019
Пров. | | | 14:23:58 | | Лист 4 7 | Листов

Q12

R7

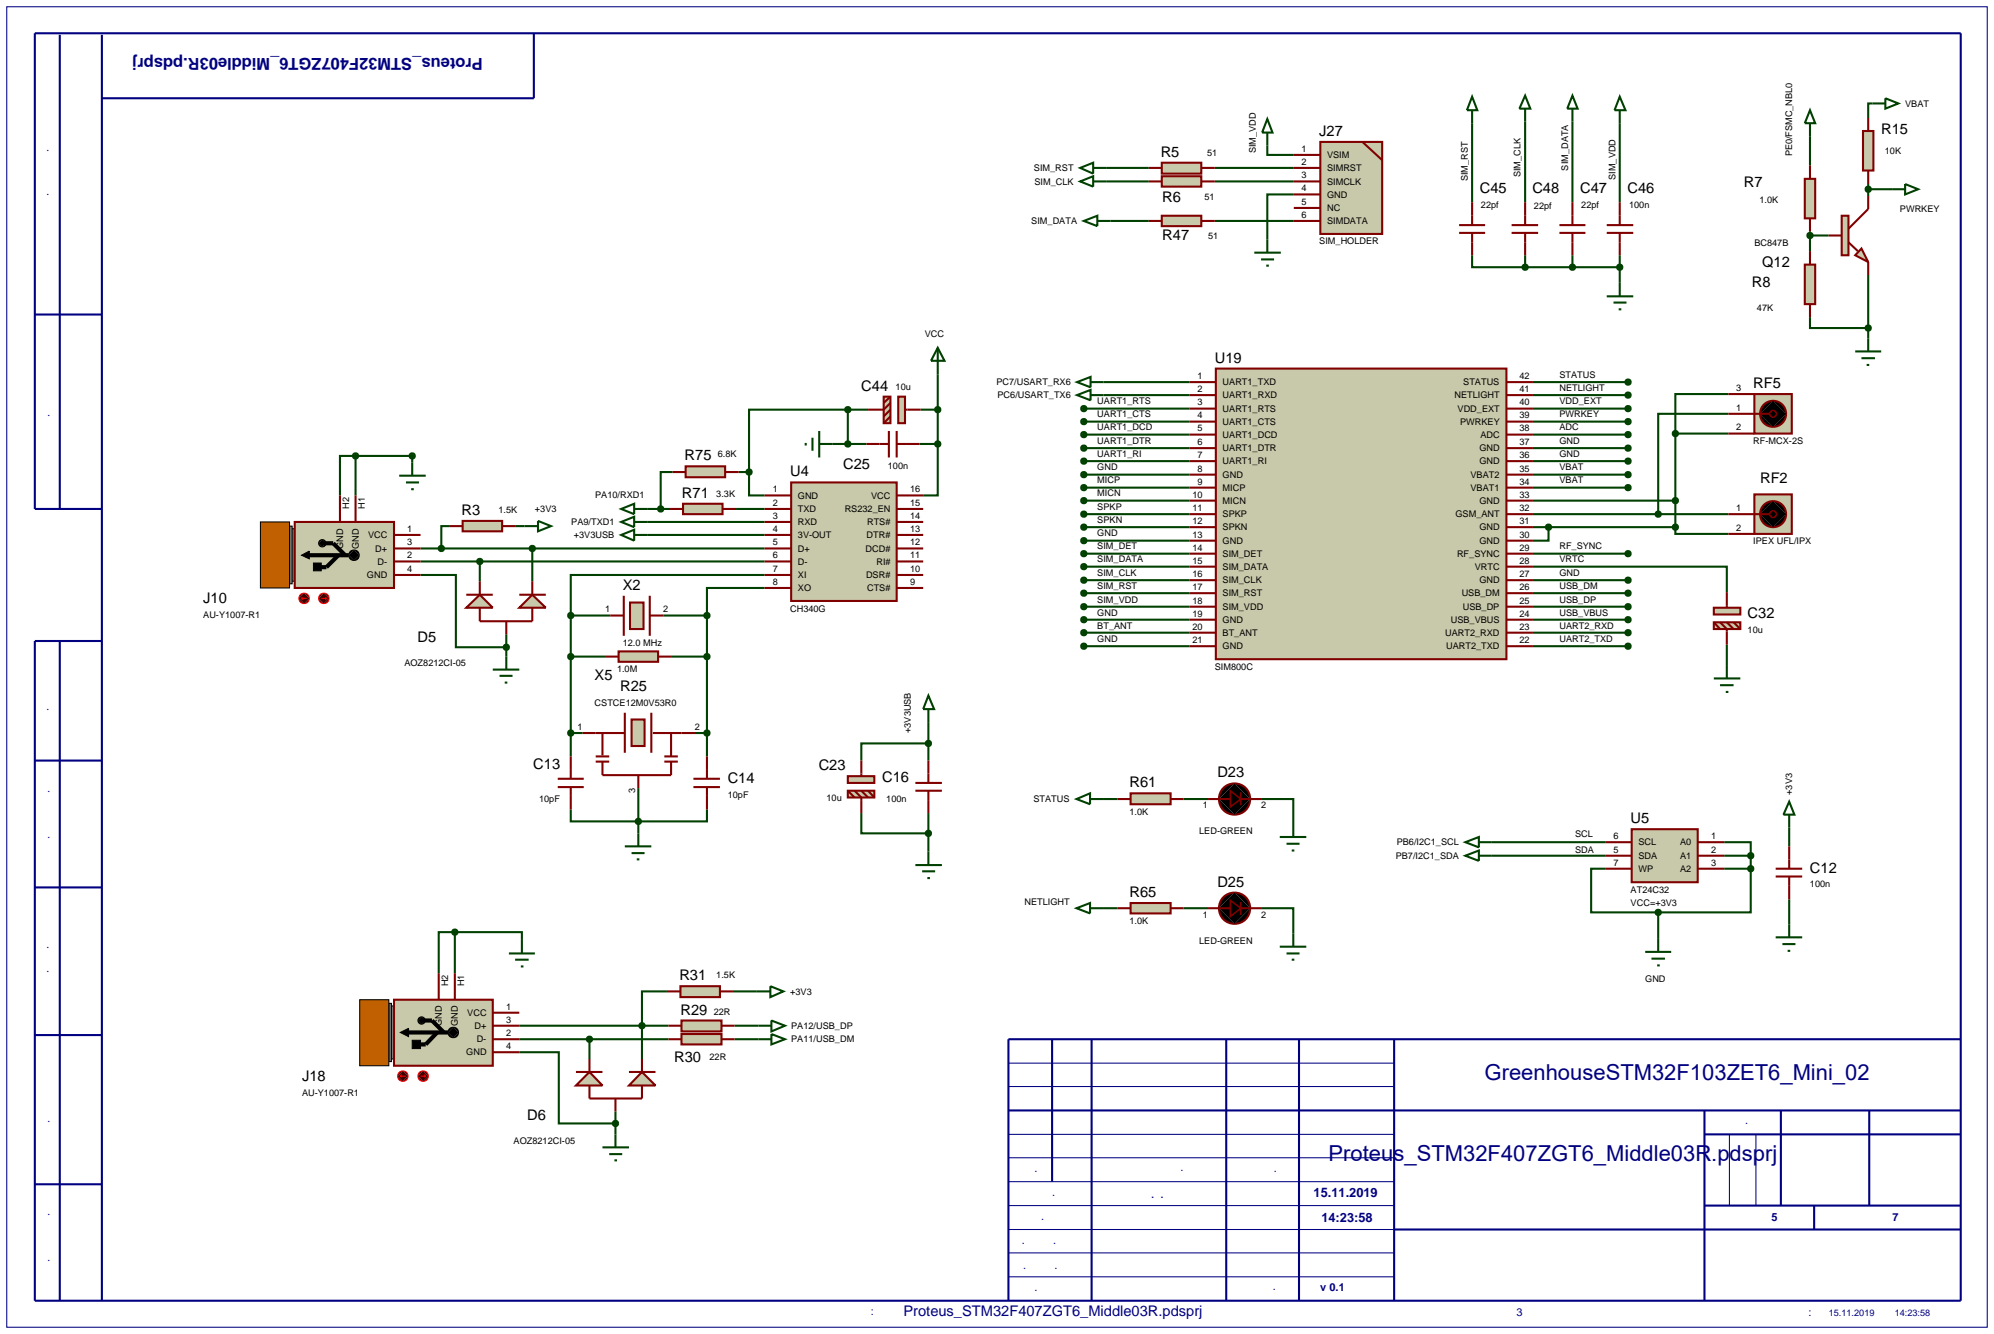
[picture p35: page 5]

Инв. № подл. Подп. и дата Взам. инв. № Инв. № дубл. Справ. № Перв. примен. Подп. и дата

GreenhouseSTM32F103ZET6_Mini_02

Лит. | Масса | Масштаб

Изм. | Лист | № докум. | Подп. | Дата

Разраб. | | Мосейчук А.В. | | 15.11.2019
Пров. | | | 14:23:58 | | Лист 5 7 | Листов

U6
RN7

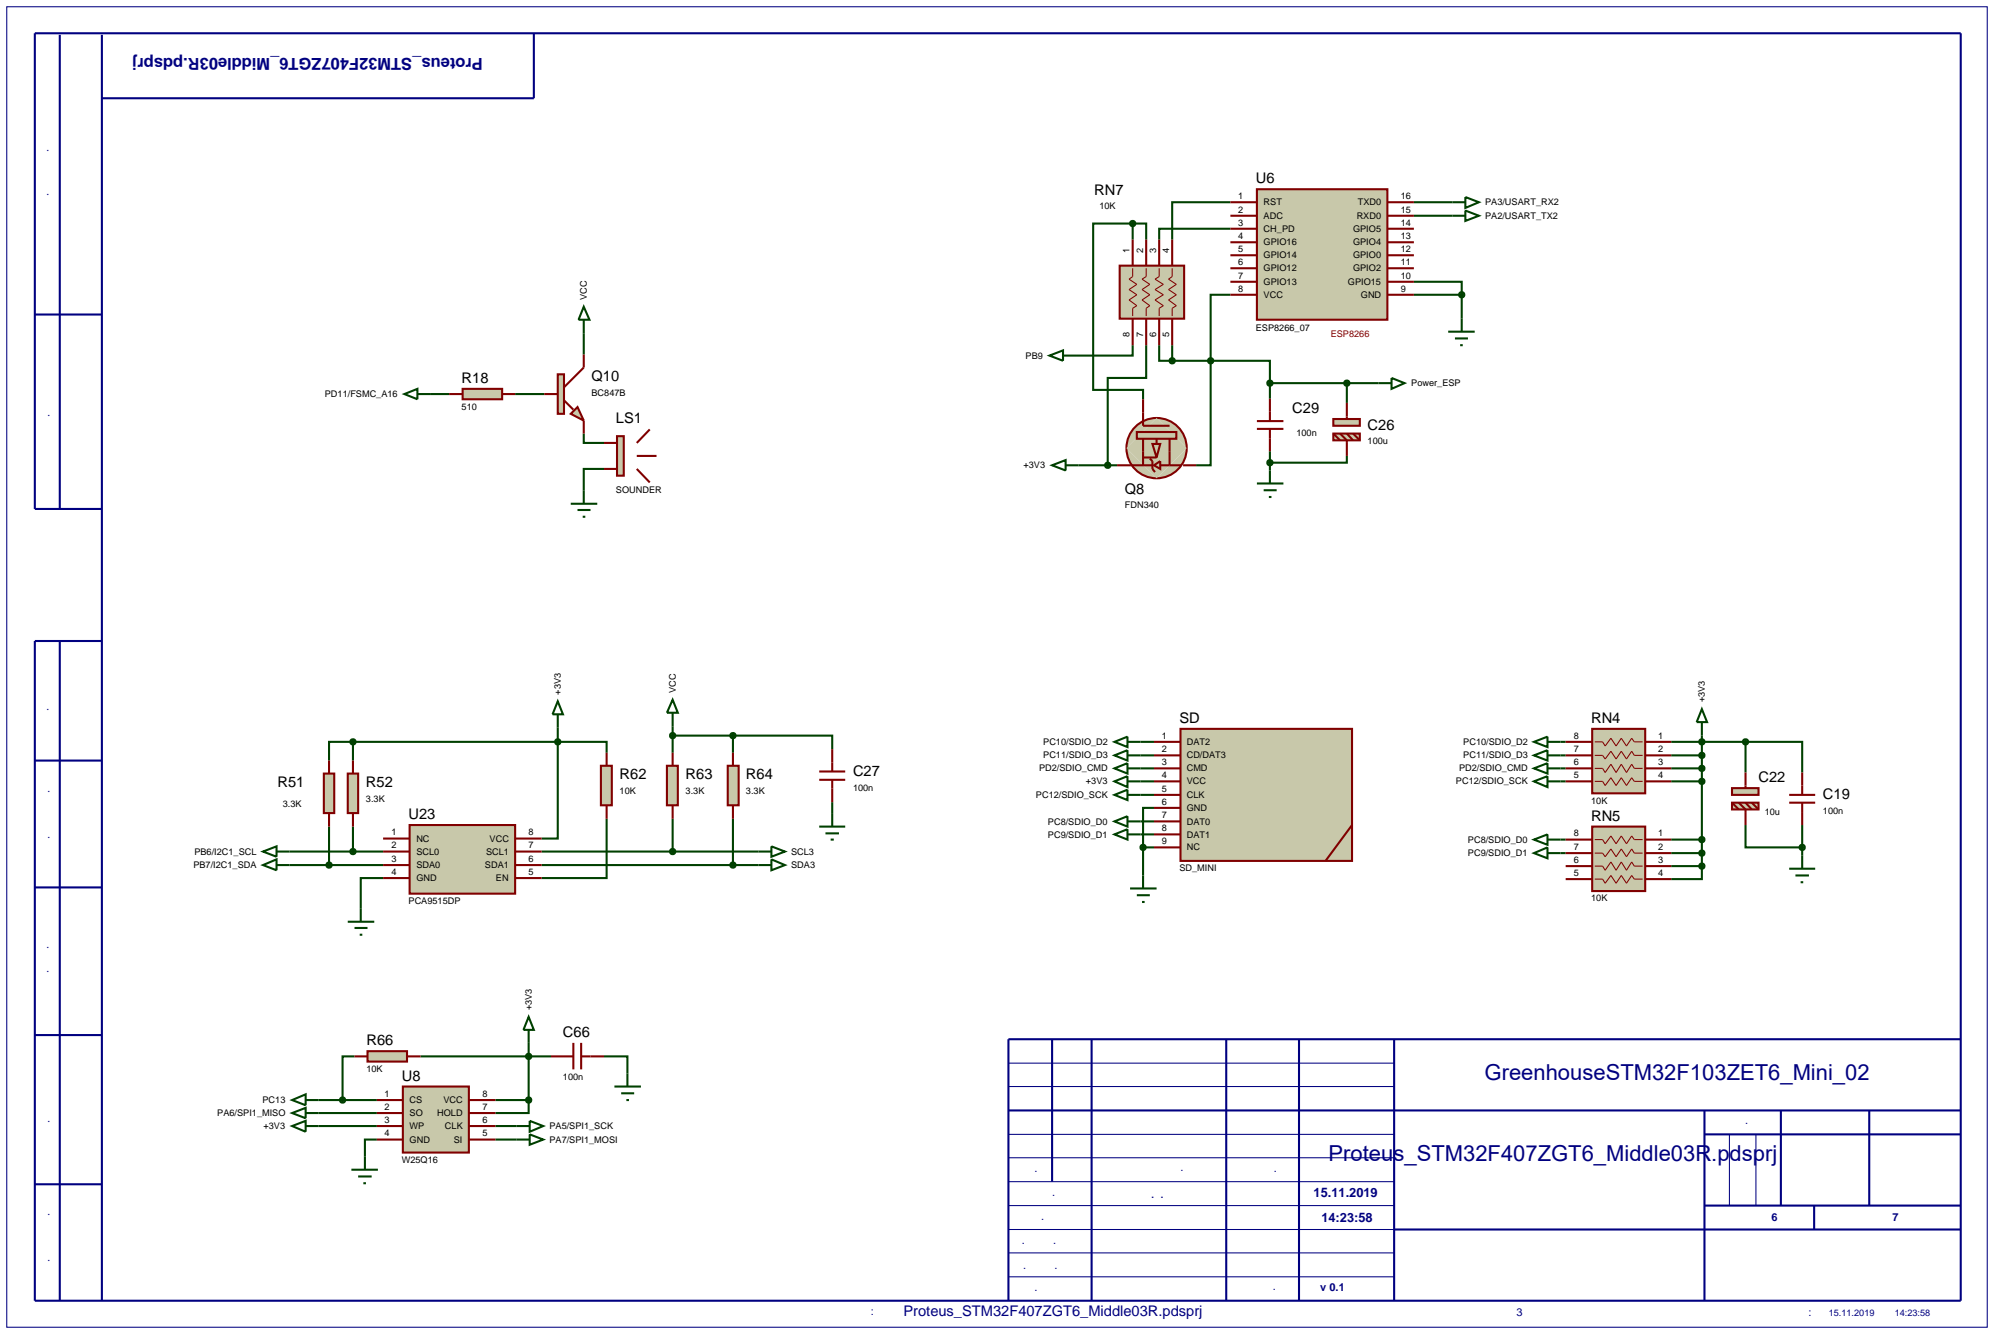
[picture p36: page 6]

Инв. № подл. Подп. и дата Взам. инв. № Инв. № дубл. Справ. № Перв. примен. Подп. и дата

GreenhouseSTM32F103ZET6_Mini_02

Лит. | Масса | Масштаб

Изм. | Лист | № докум. | Подп. | Дата

Разраб. | | Мосейчук А.В. | | 15.11.2019
Пров. | | | 14:23:58 | | Лист 6 7 | Листов

U17

J16

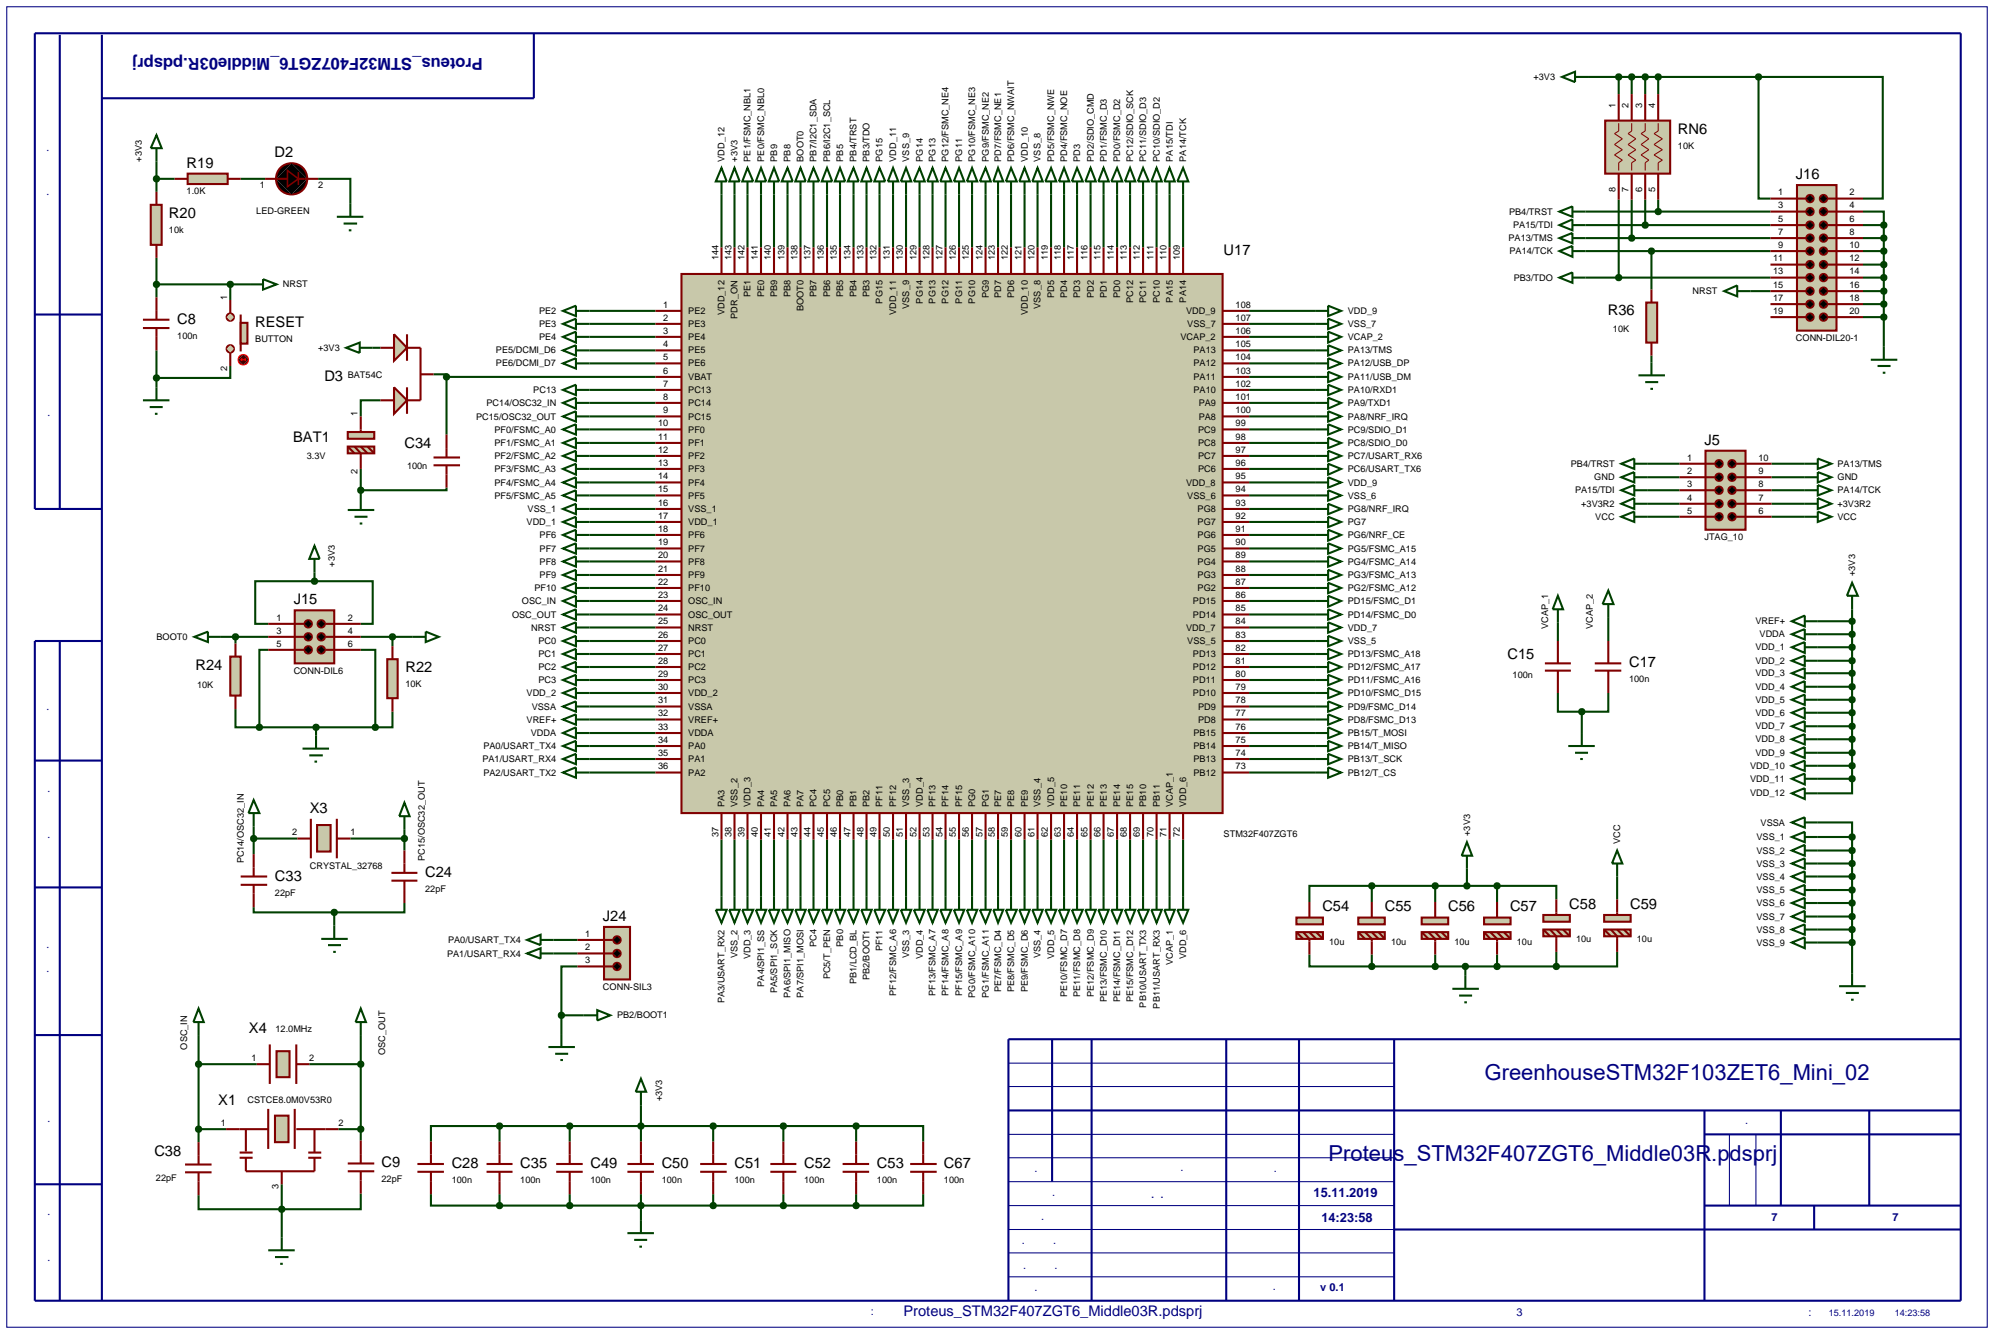
[picture p37: page 7]

Инв. № подл. Подп. и дата Взам. инв. № Инв. № дубл. Справ. № Перв. примен. Подп. и дата

GreenhouseSTM32F103ZET6_Mini_02

Лит. | Масса | Масштаб

Изм. | Лист | № докум. | Подп. | Дата

Разраб. | | Мосейчук А.В. | | 15.11.2019
Пров. | | | 14:23:58 | | Лист 7 7 | Листов
