madeonline/GreenhouseProject_continuation/Инструкции на контроллер теплицы/Аппаратная информация/Universal controller_SAM3X8E_01R.PDF

J11

C7

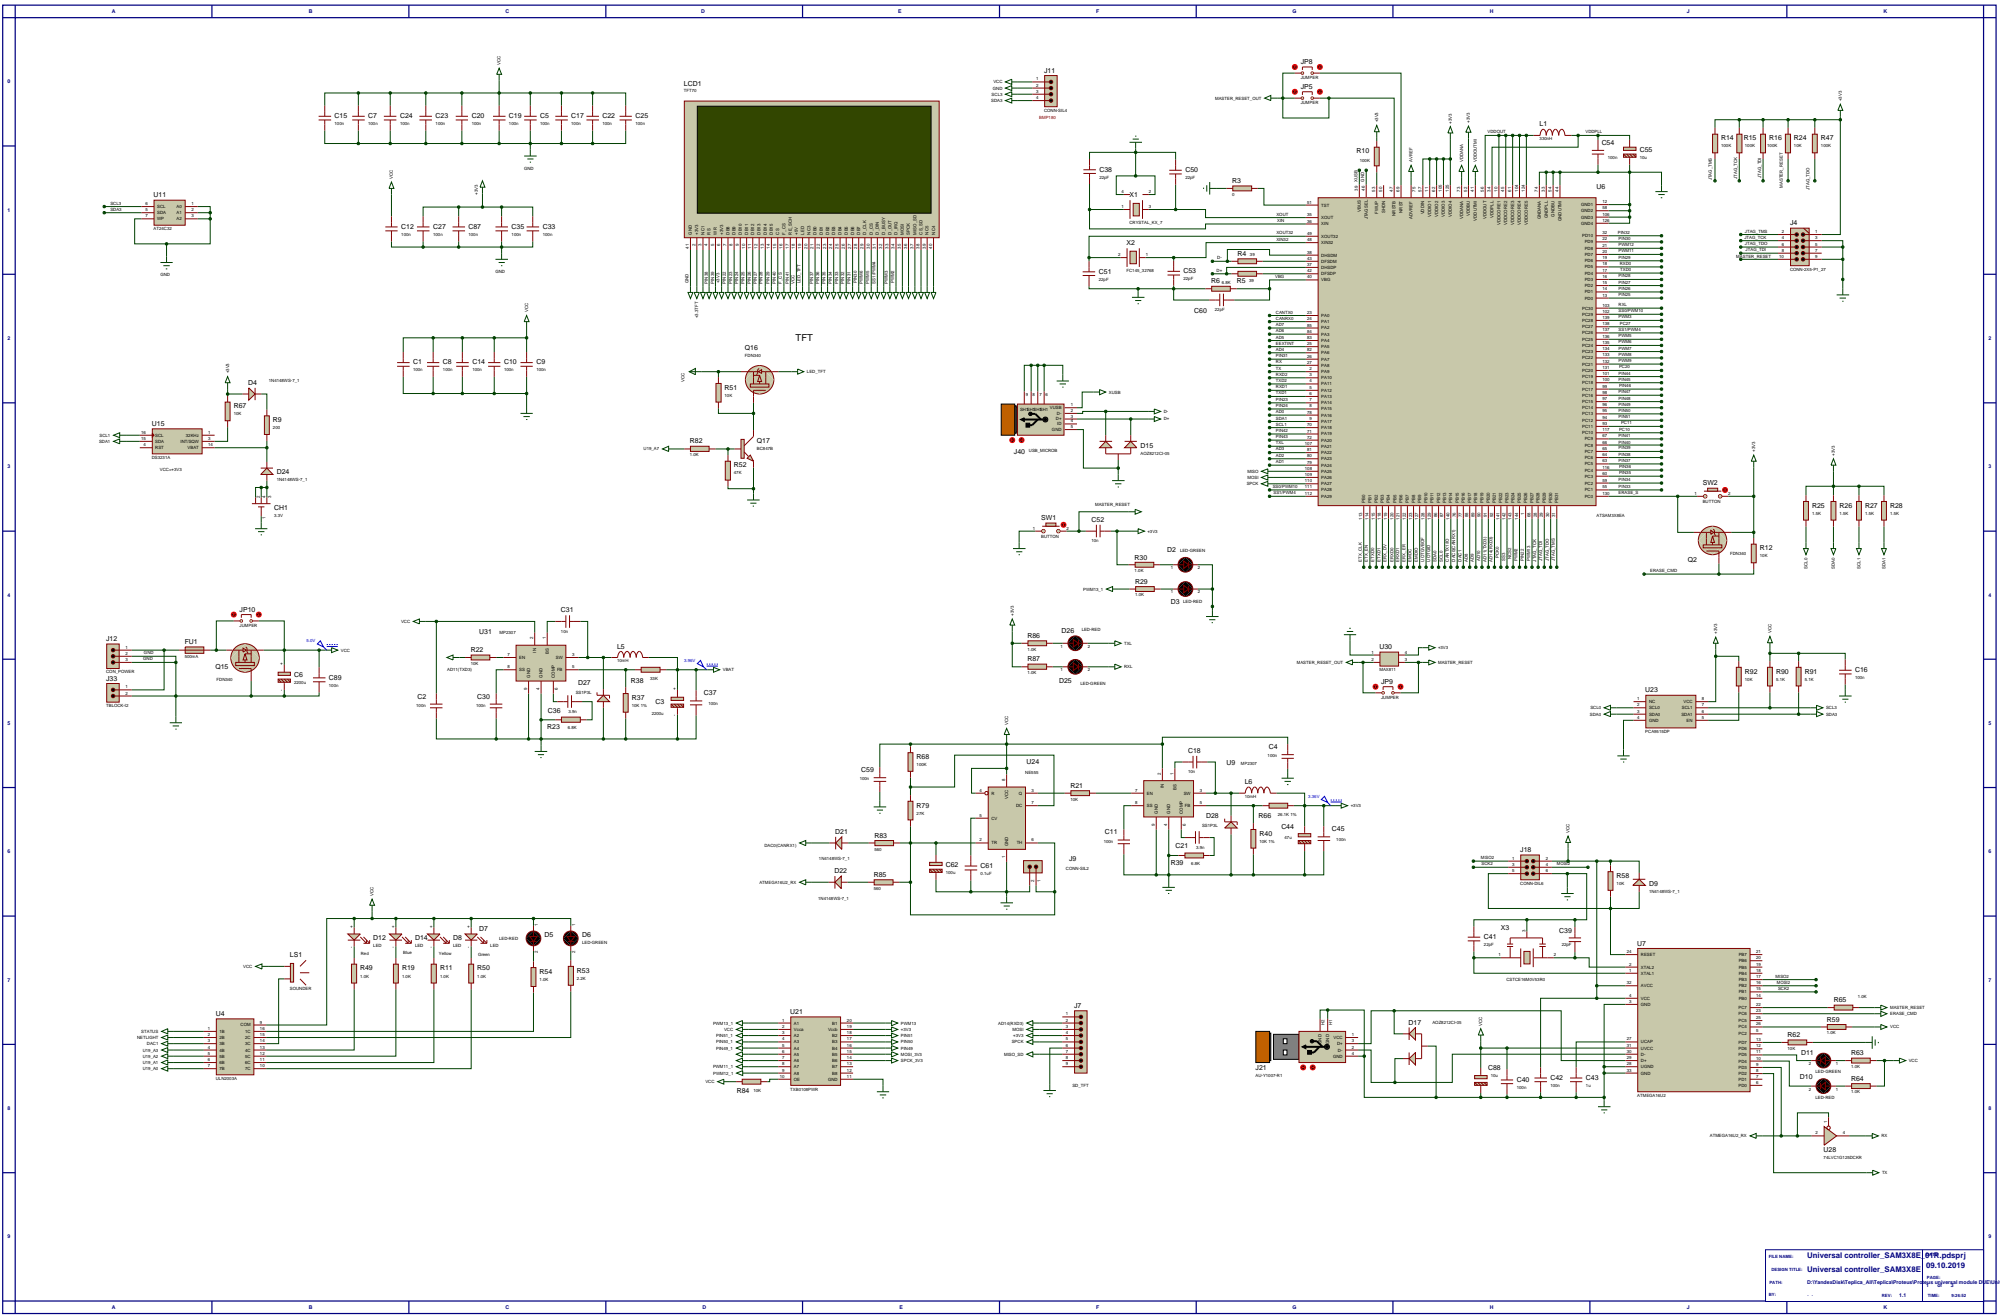
[picture p38: page 1]

R2

R8

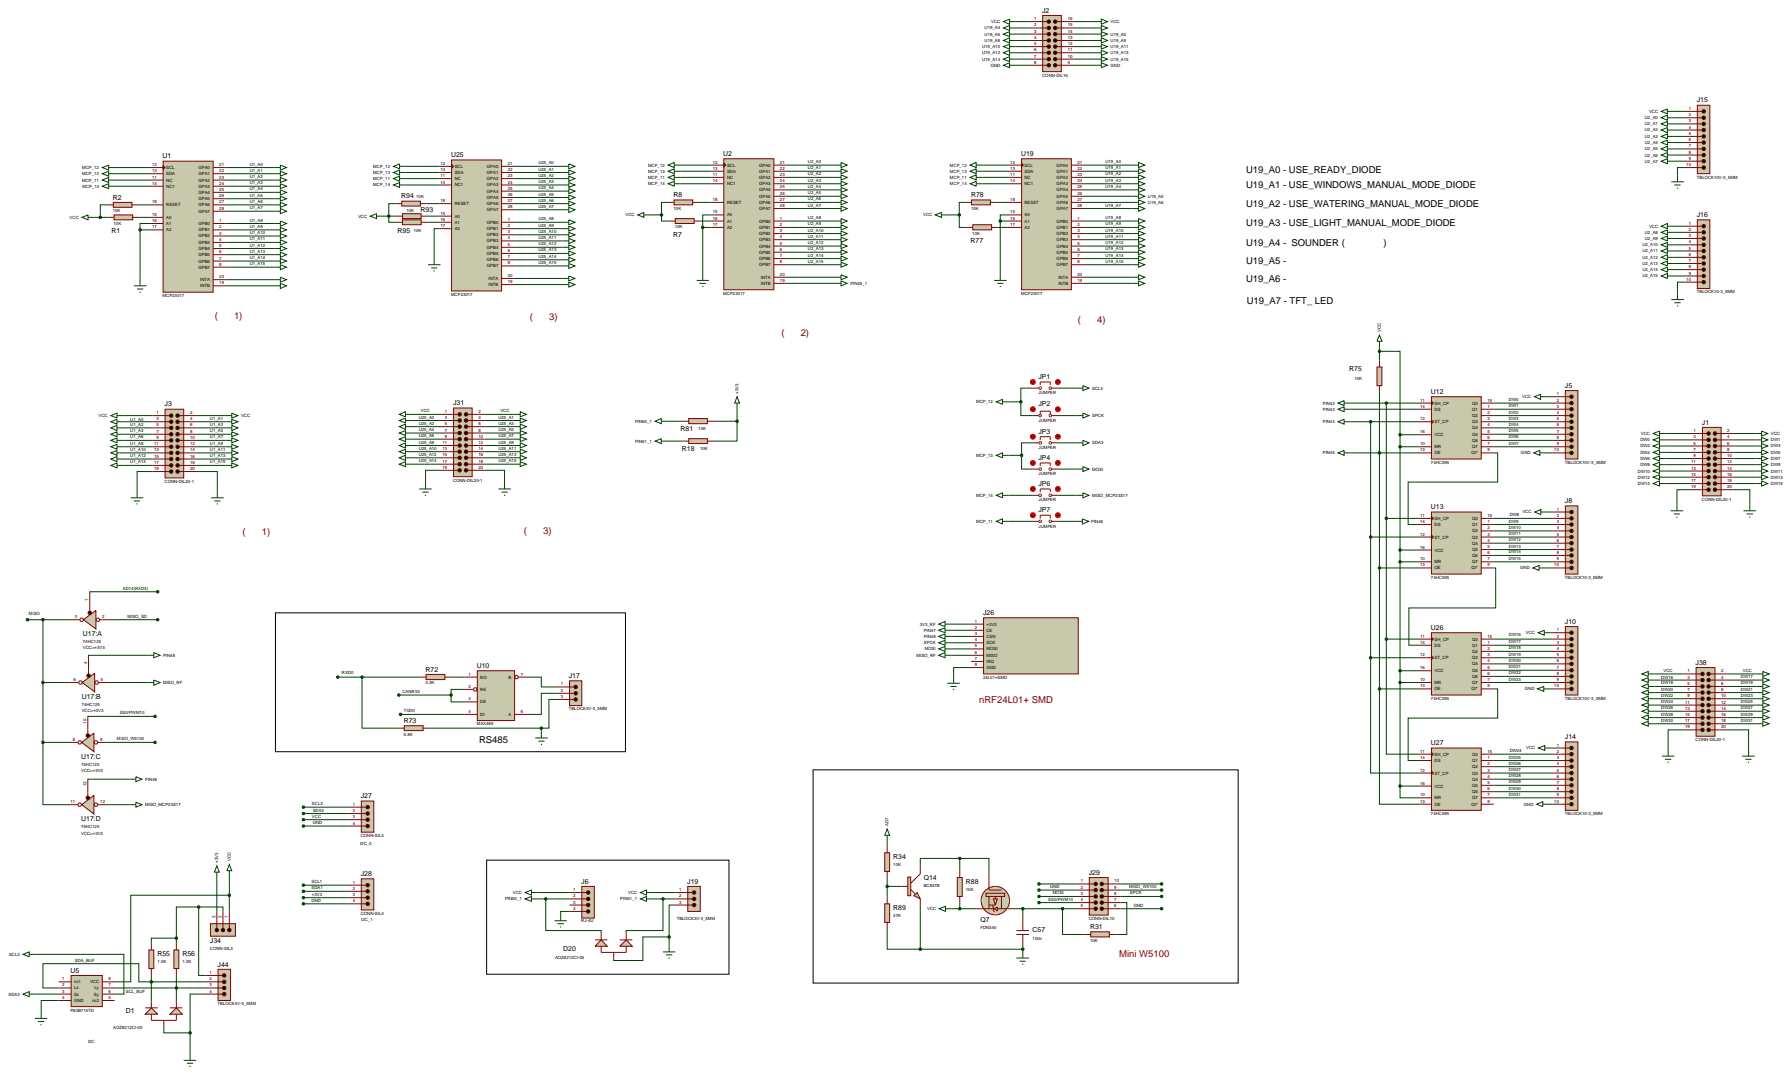
[picture p39: page 2]

на которых висят универсальные модули

C26

C70

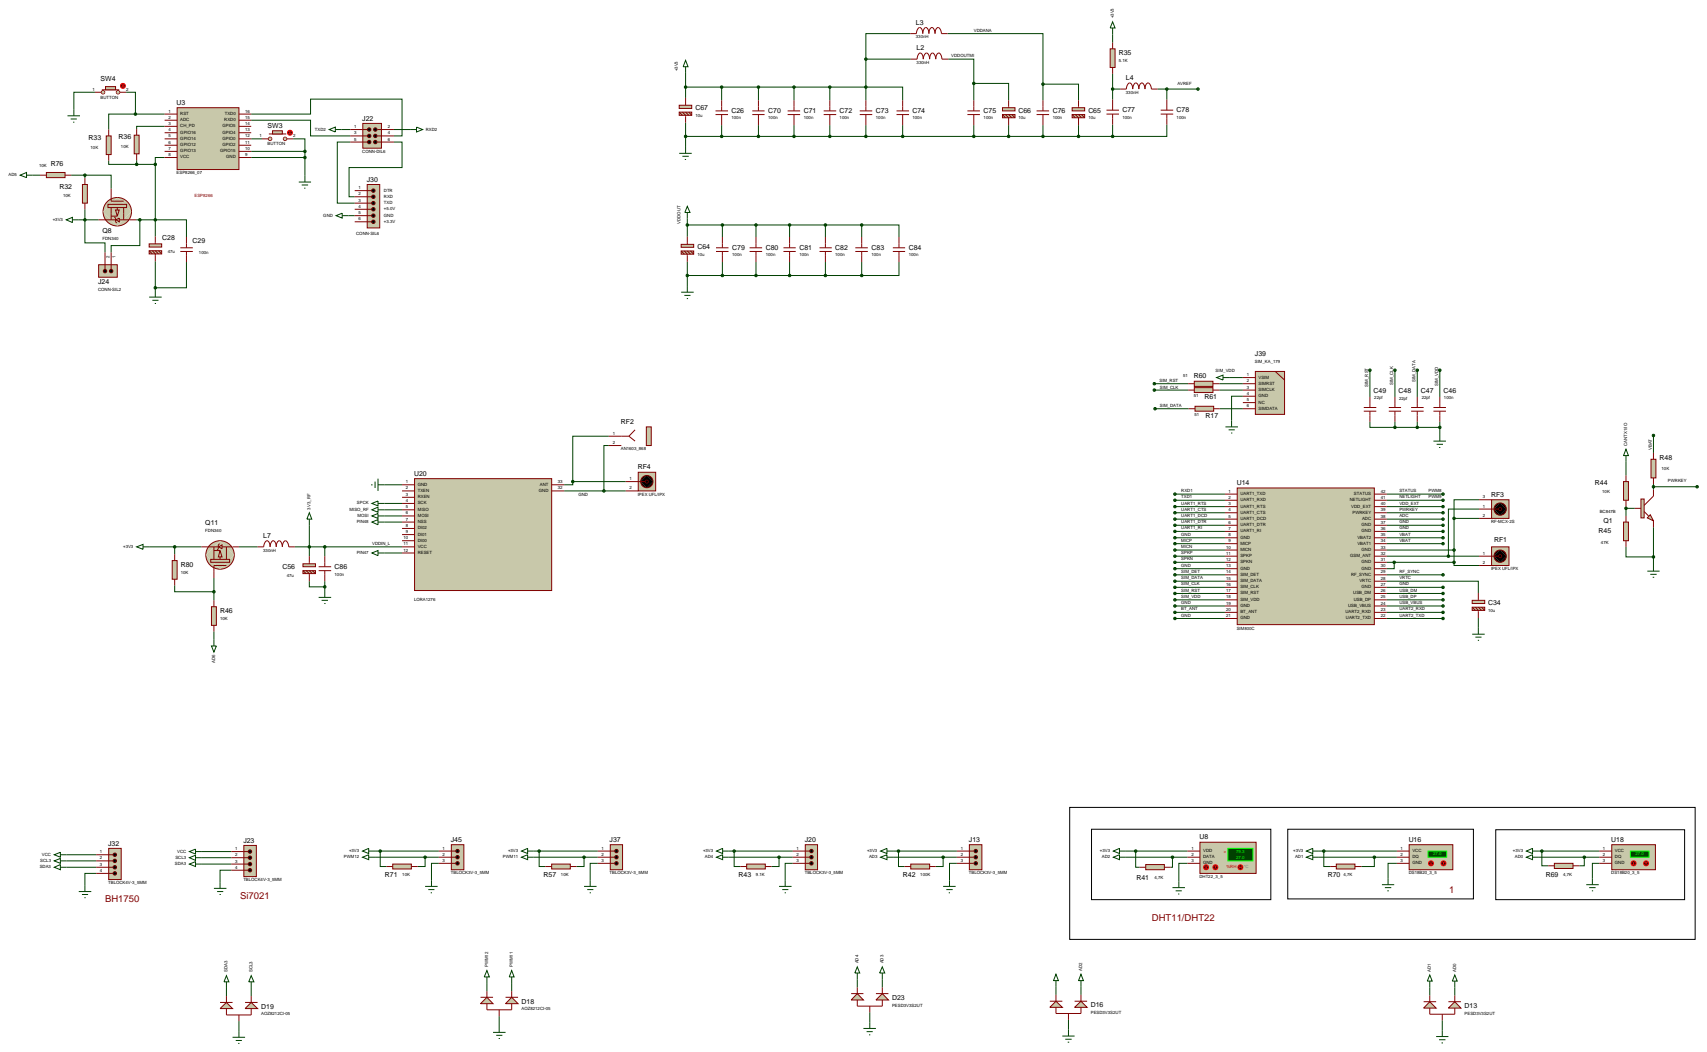
[picture p40: page 3]
