madeonline/GreenhouseProject_continuation/Инструкции на контроллер теплицы/Аппаратная информация/Universal controller_SAM3X8E_02.PDF

J11

C7

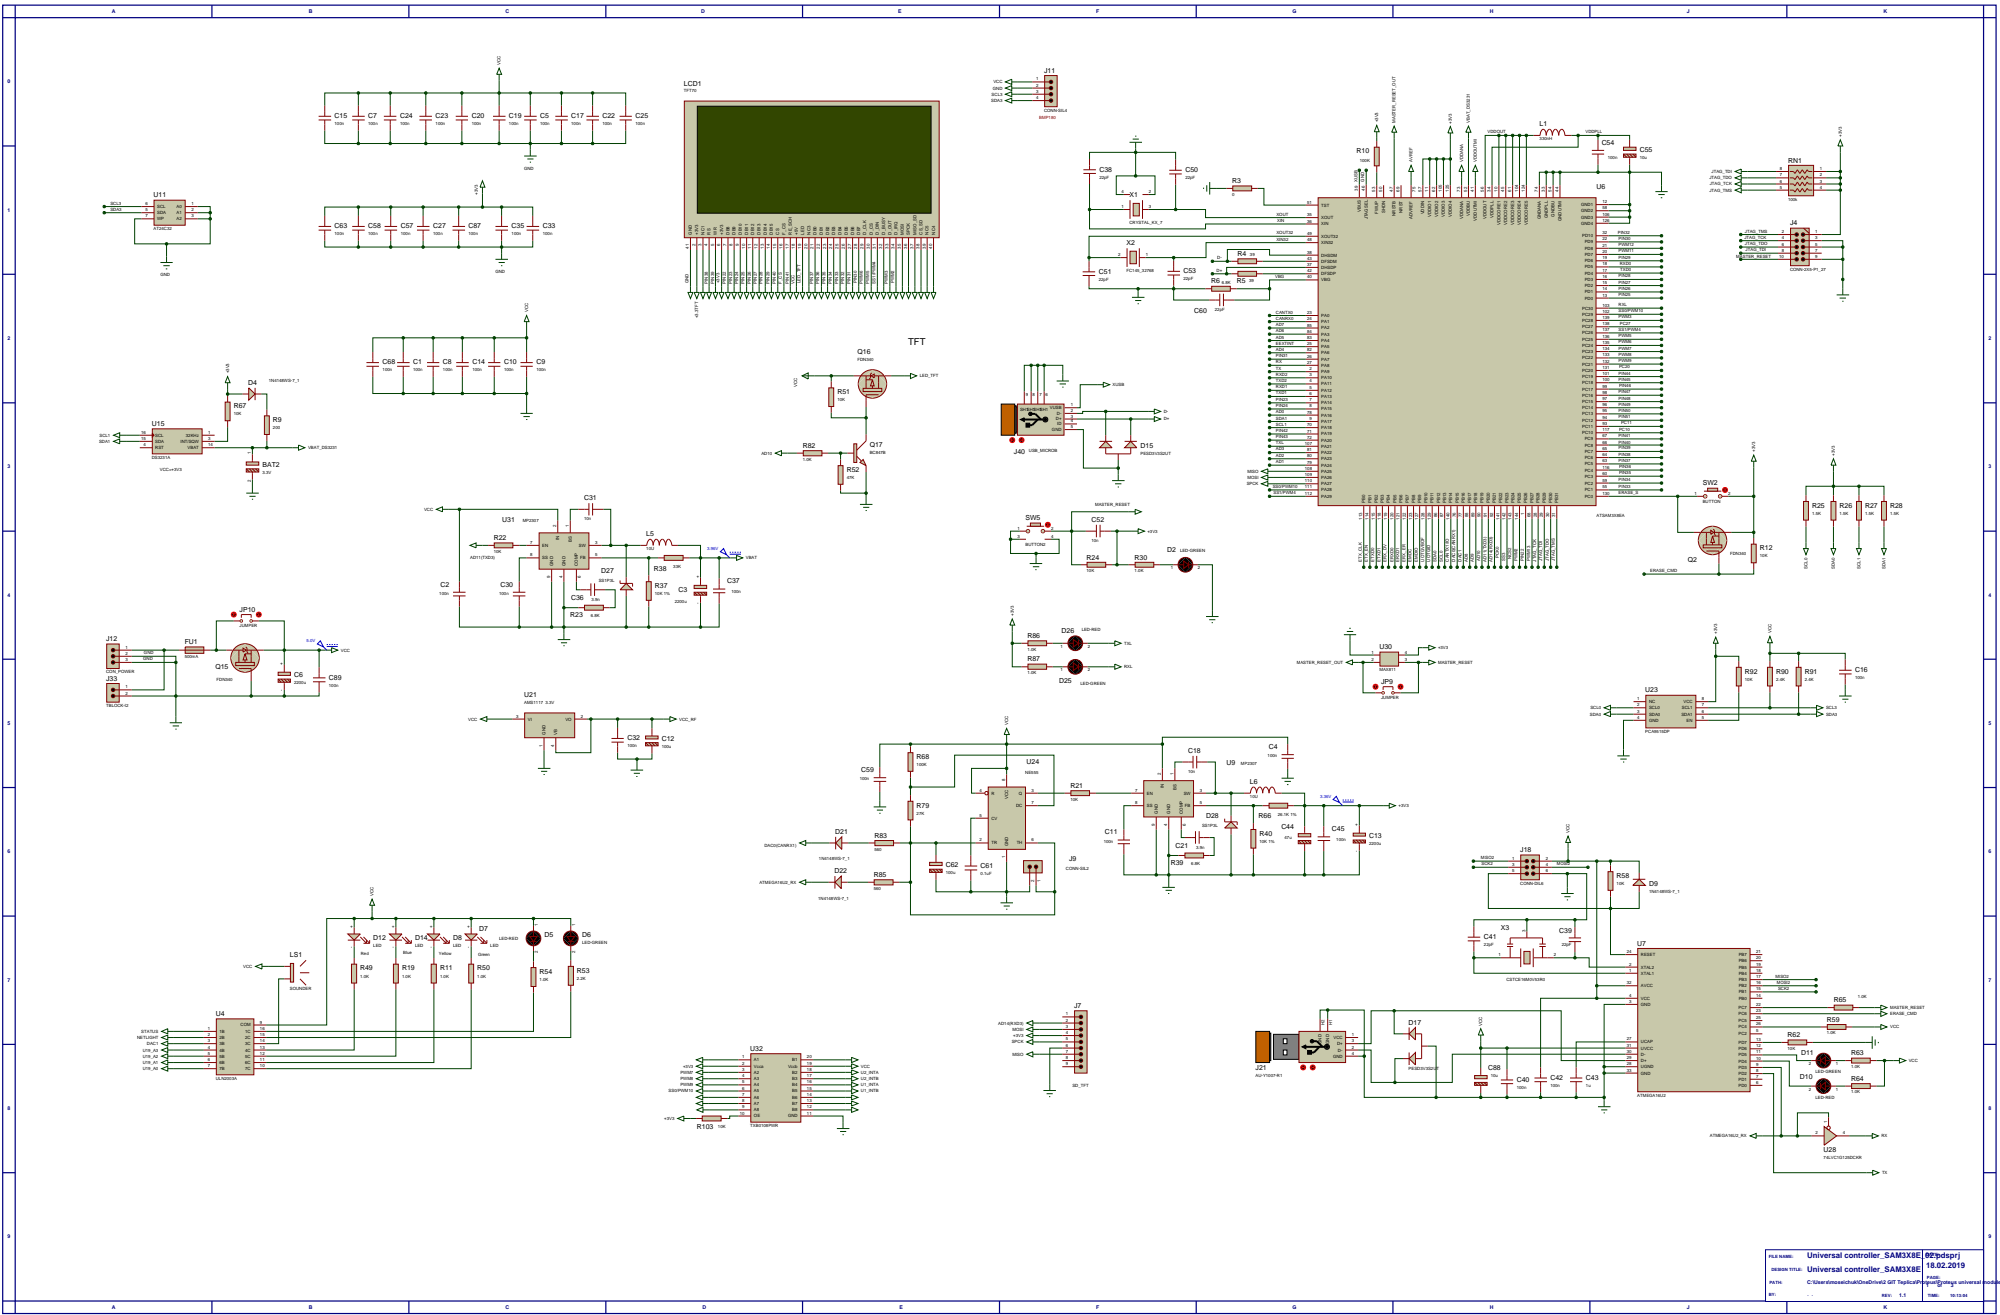
[picture p41: page 1]

R2

R8

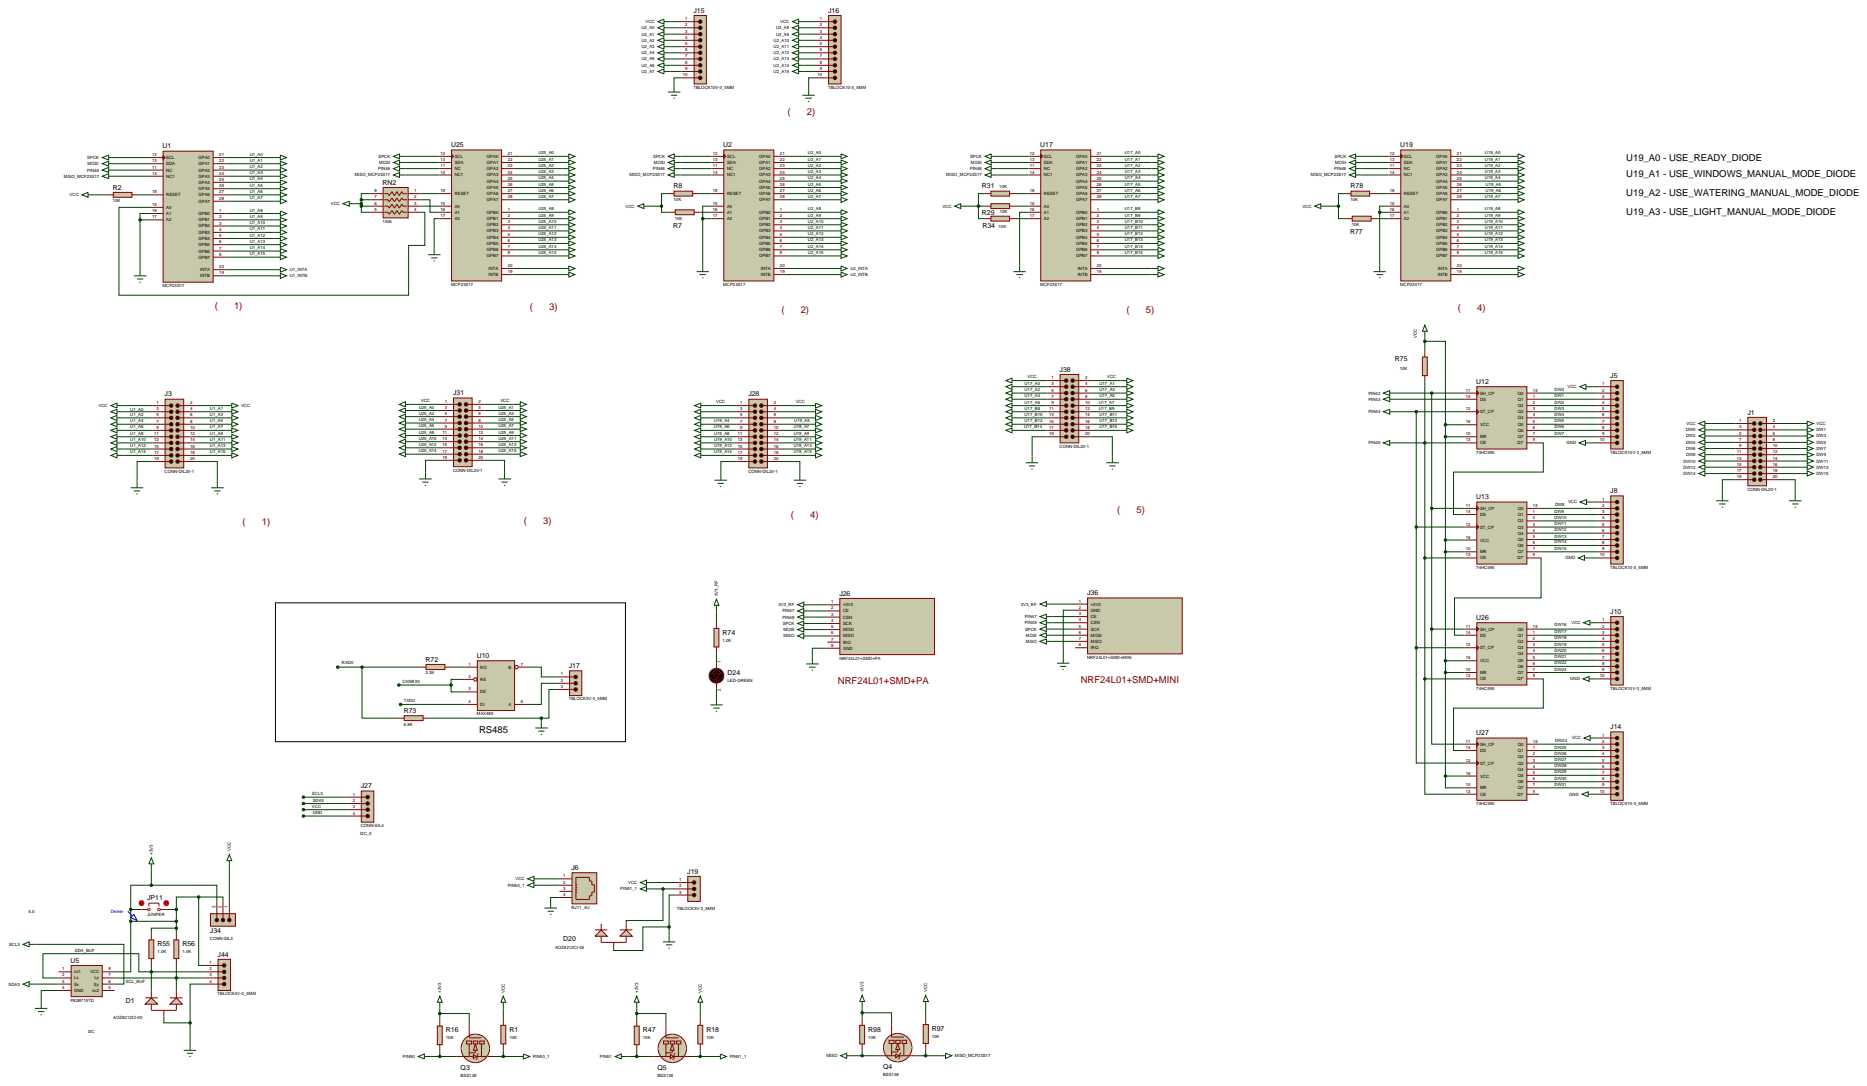
[picture p42: page 2]

на которых висят универсальные модули

C26

C70

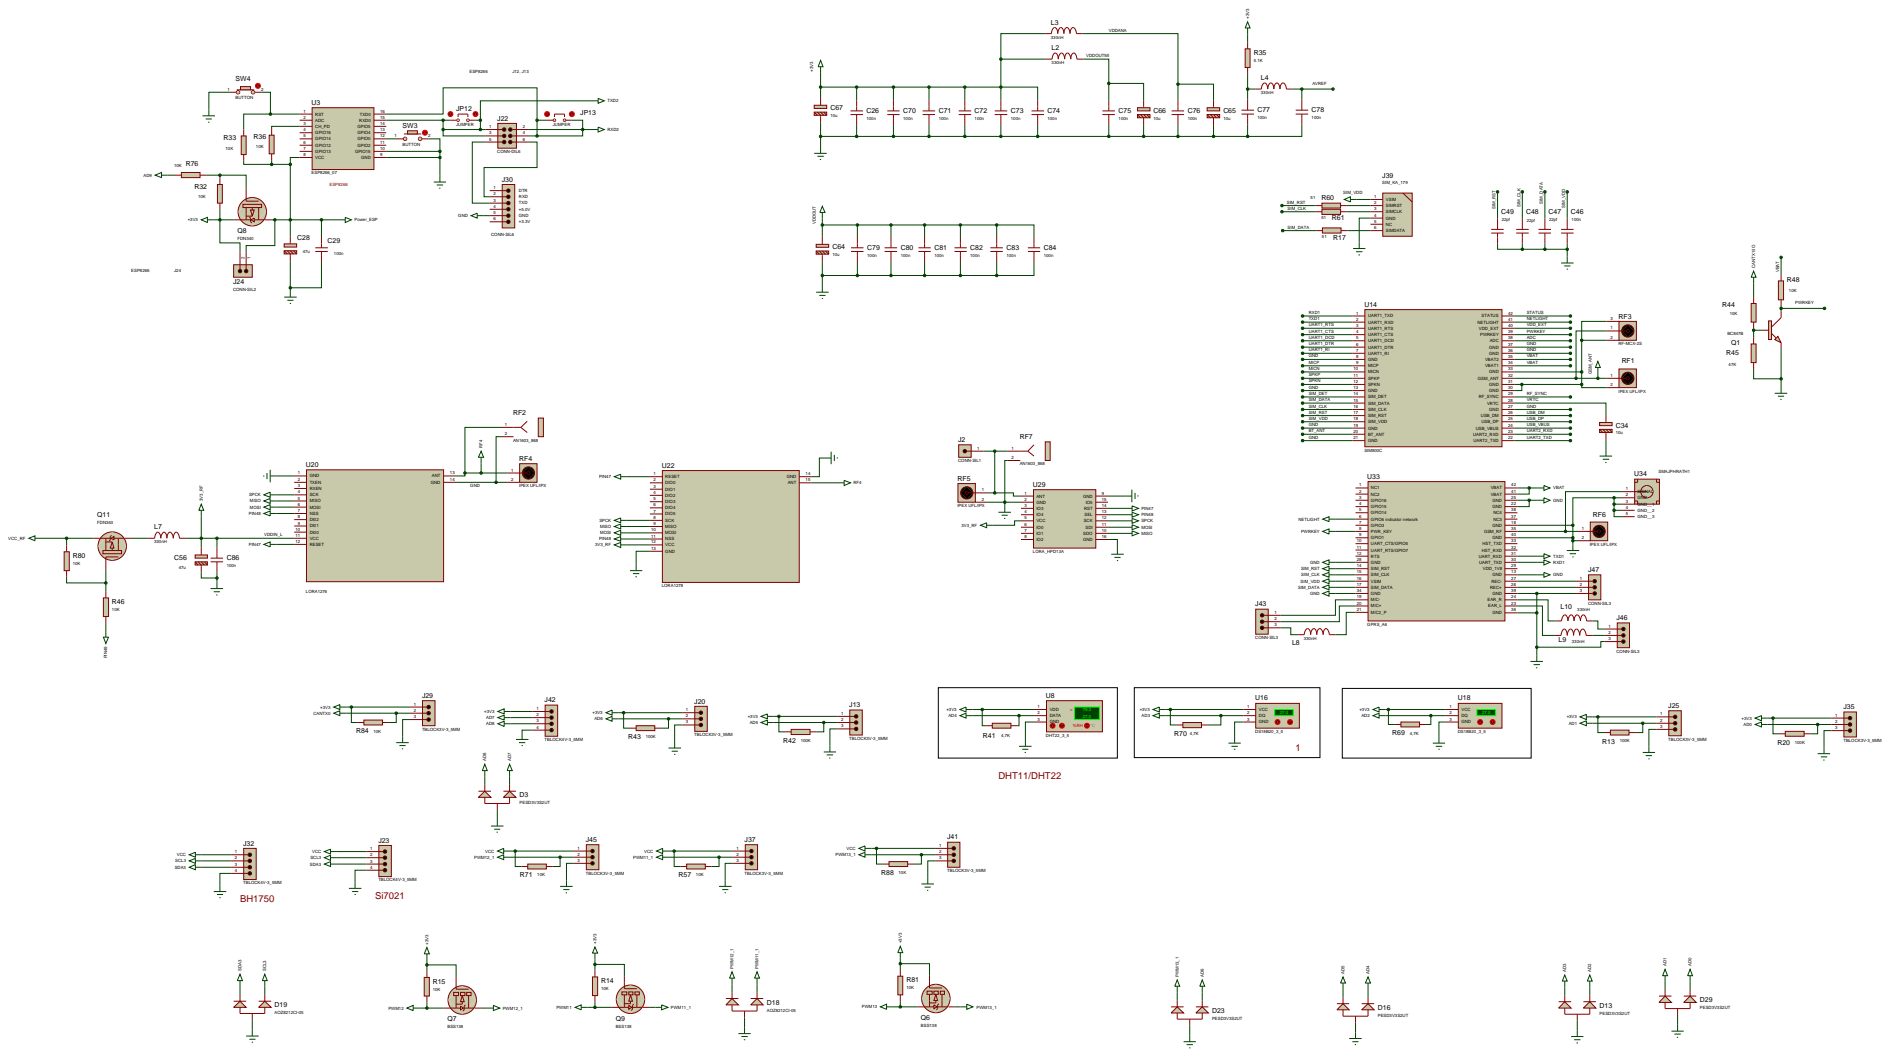
[picture p43: page 3]

При программировании ESP8266 перемычки J12, J13 удалить

При программировании ESP8266 перемычки J24 замкнуть
