madeonline/GreenhouseProject_continuation/Инструкции на контроллер теплицы/Аппаратная информация/Коммутация_реле_фрамуг.PDF

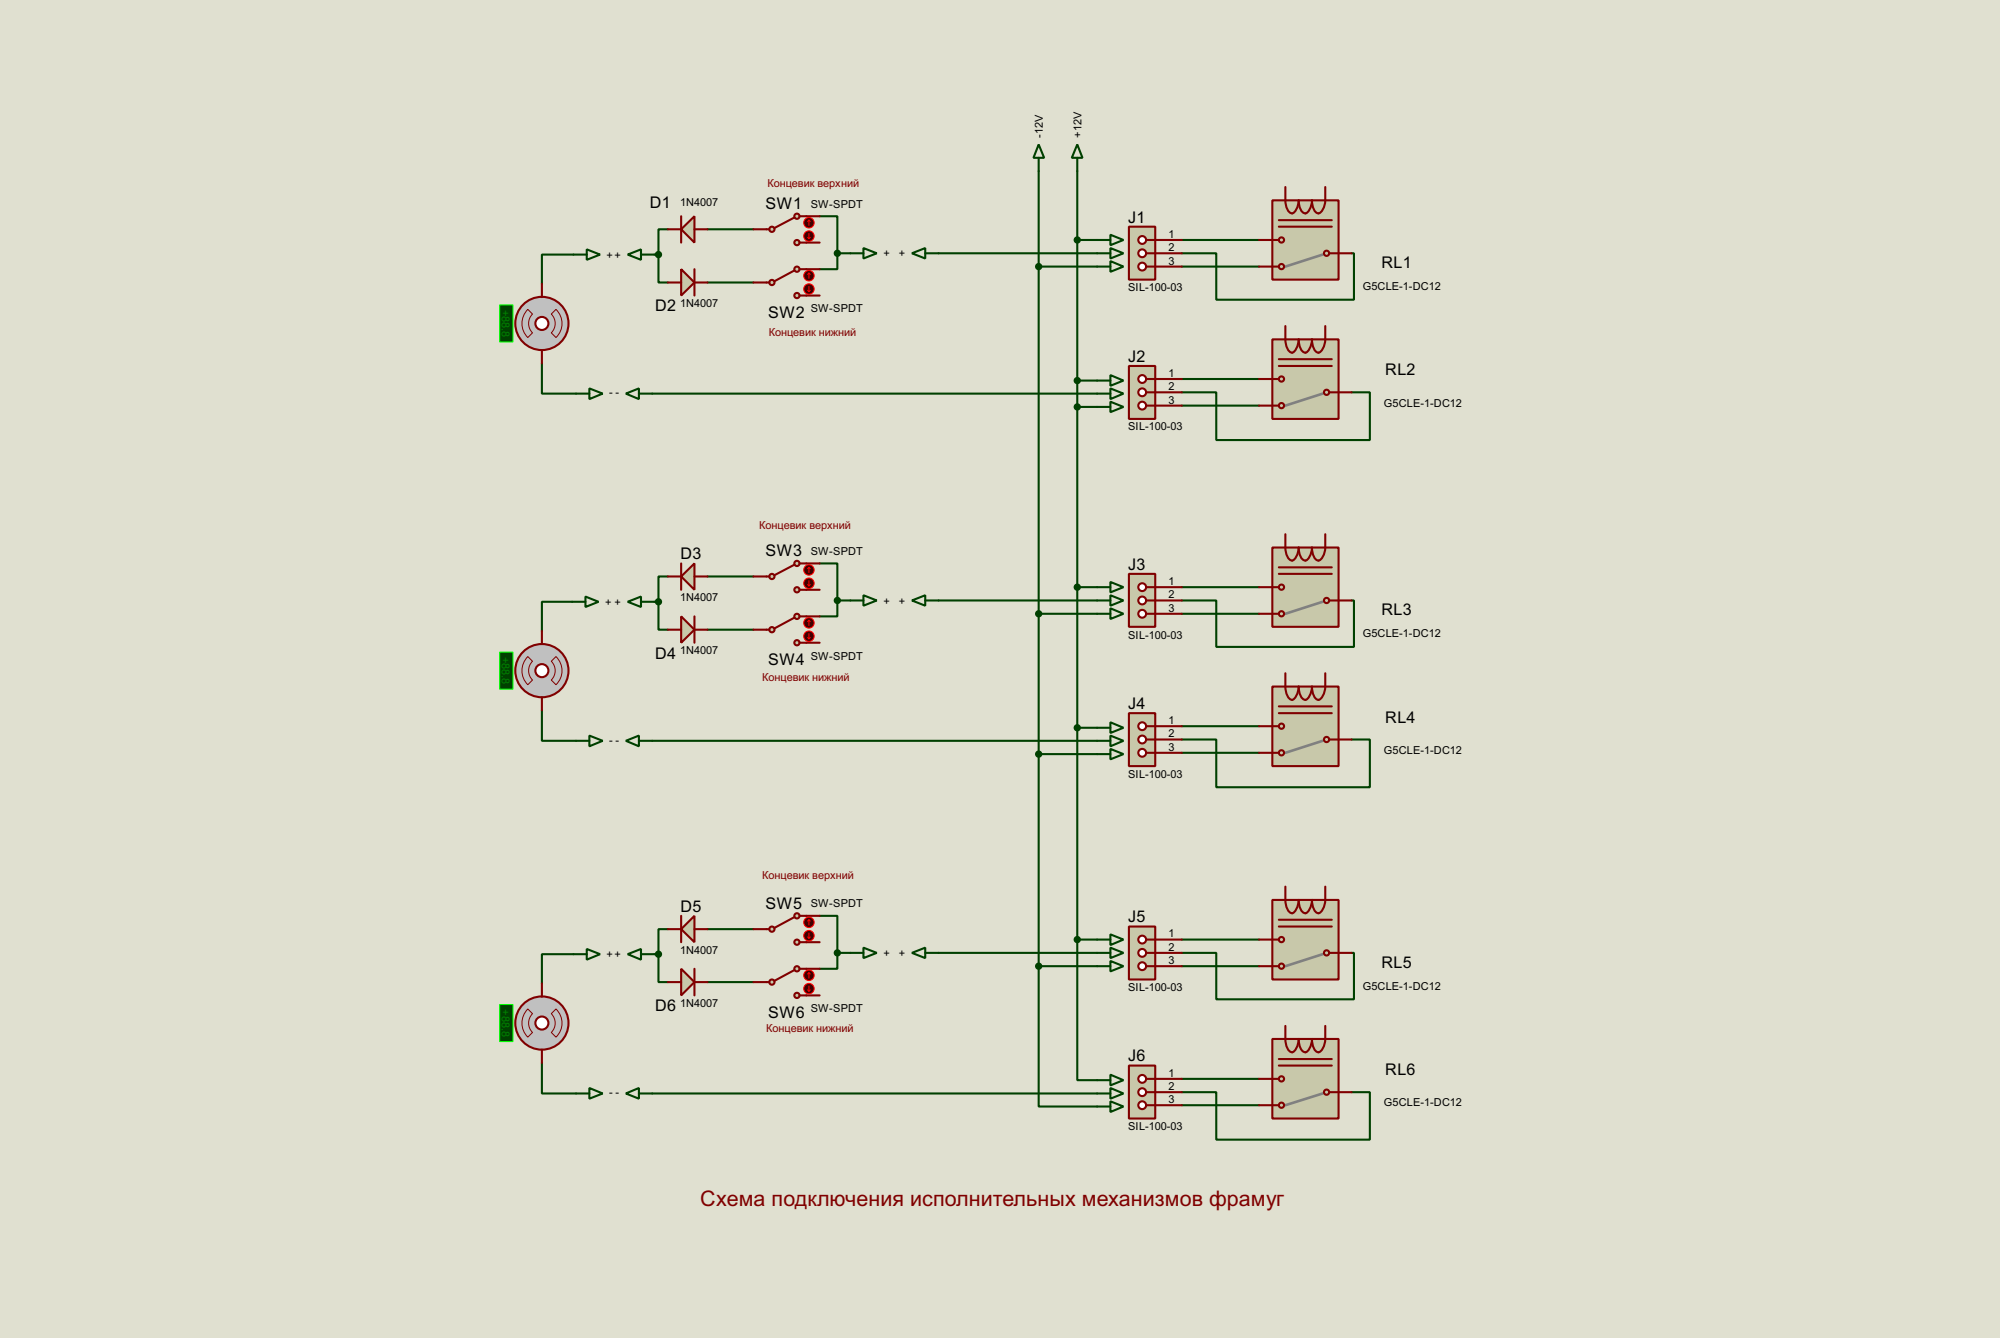
[picture p44: page 1]

Схема подключения исполнительных механизмов фрамуг
