madeonline/GreenhouseProject_continuation/Ультразвуковой модуль уровня воды/UniversalUltrasonicModule_02/UltrasonicWaterTankModuleR1.PDF

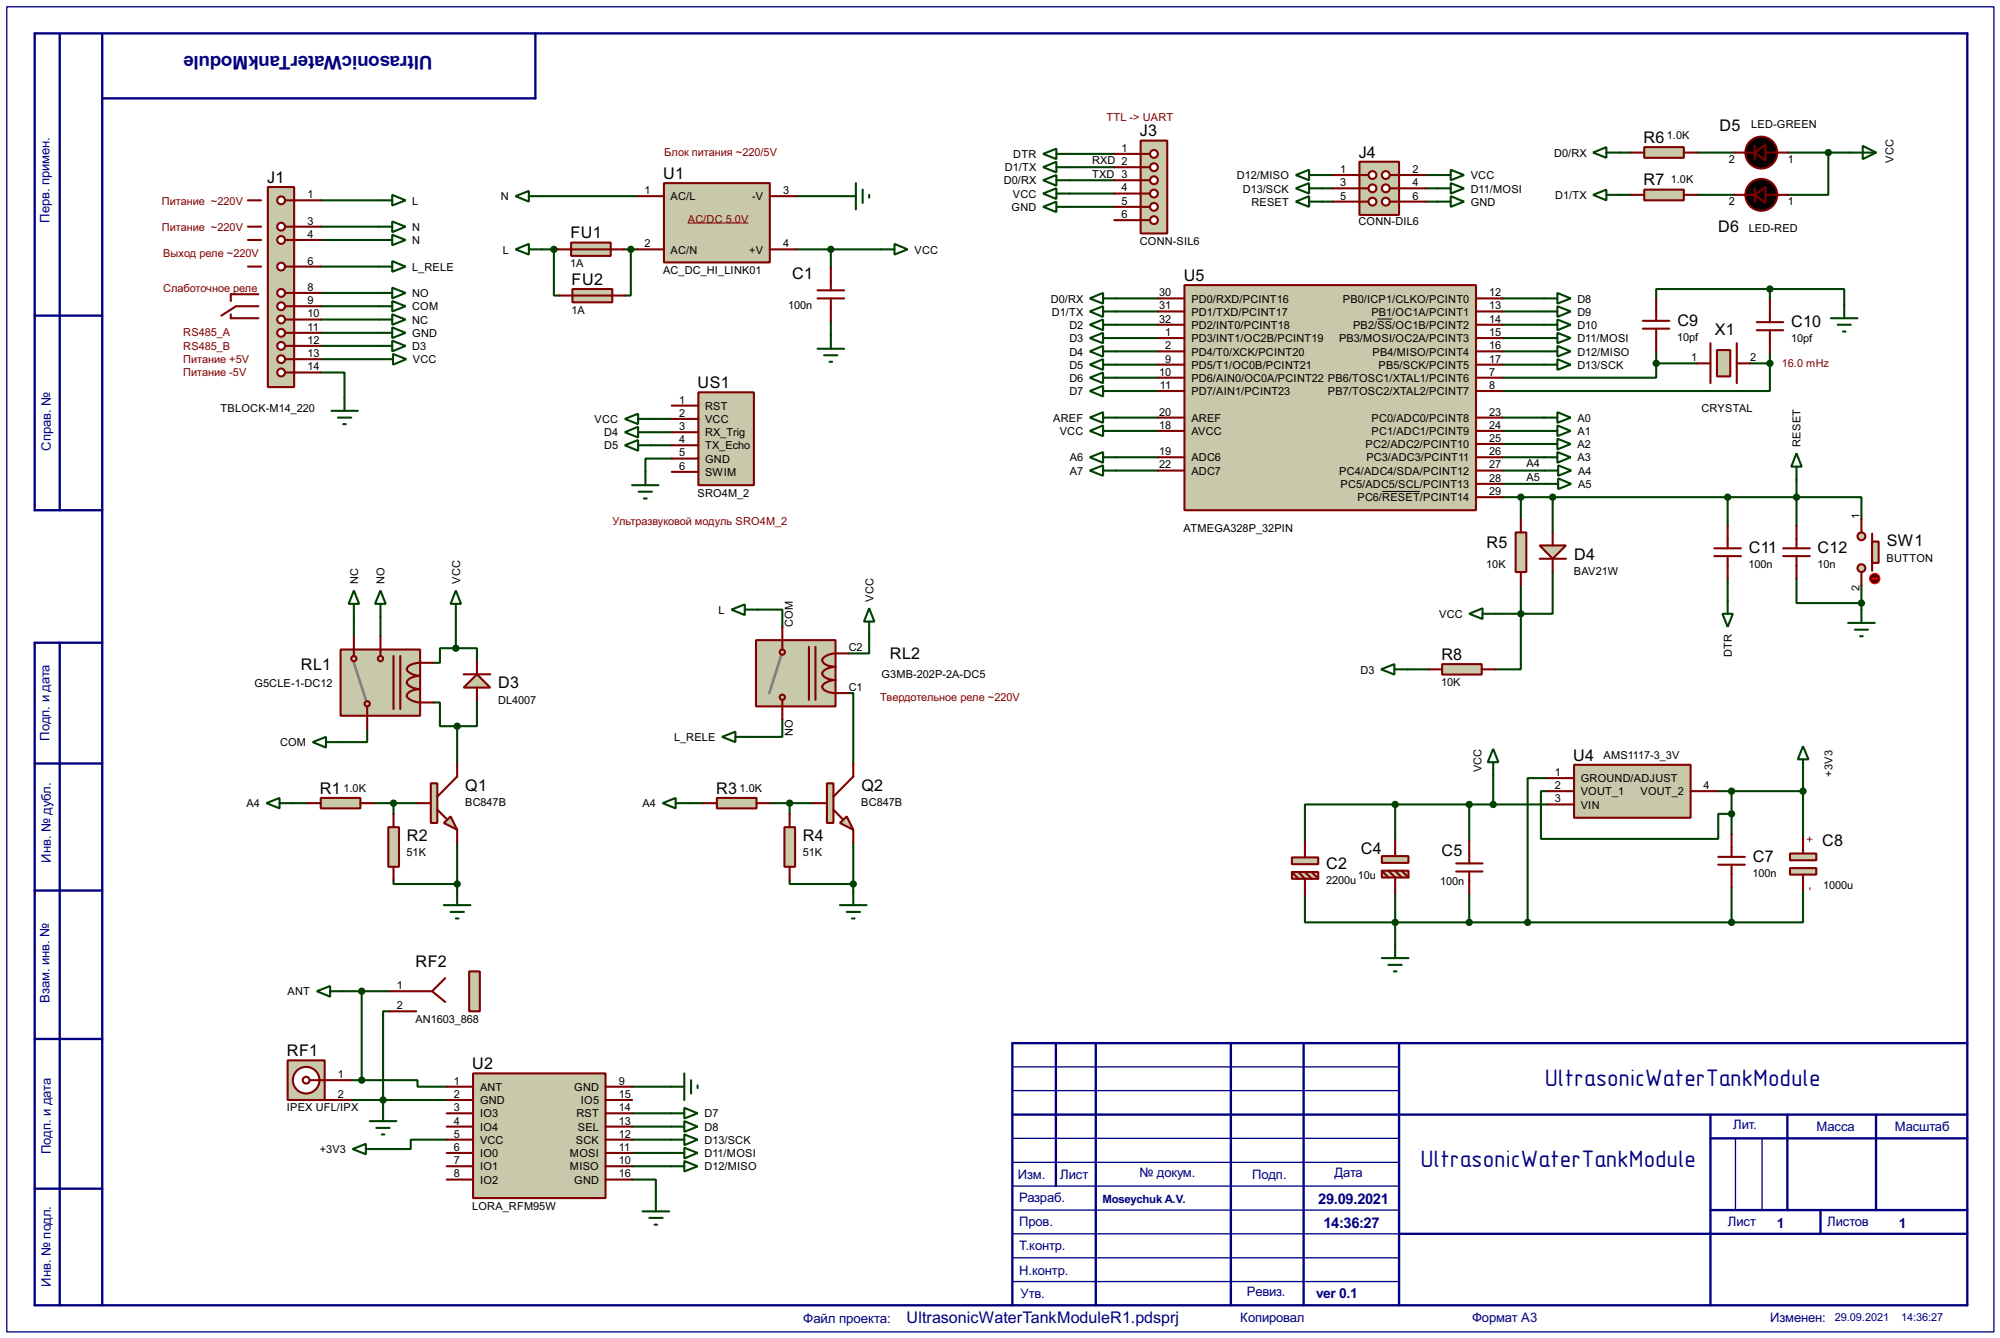
[picture p45: page 1]

Инв. № подл. Подп. и дата Взам. инв. № Инв. № дубл. Справ. № Перв. примен. Подп. и дата

Изм. Лист Разраб. Пров. Т.контр. Н.контр. Утв. | | 14:36:27 | Лист 1 | Листов 1

Moseychuk A.V. | 29.09.2021
