madeonline/GreenhouseProject_continuation/Датчик влажности грунта/Soil_moisture_sensorAmega328_6/Soil_moisture_sensorAmega328_6.PDF

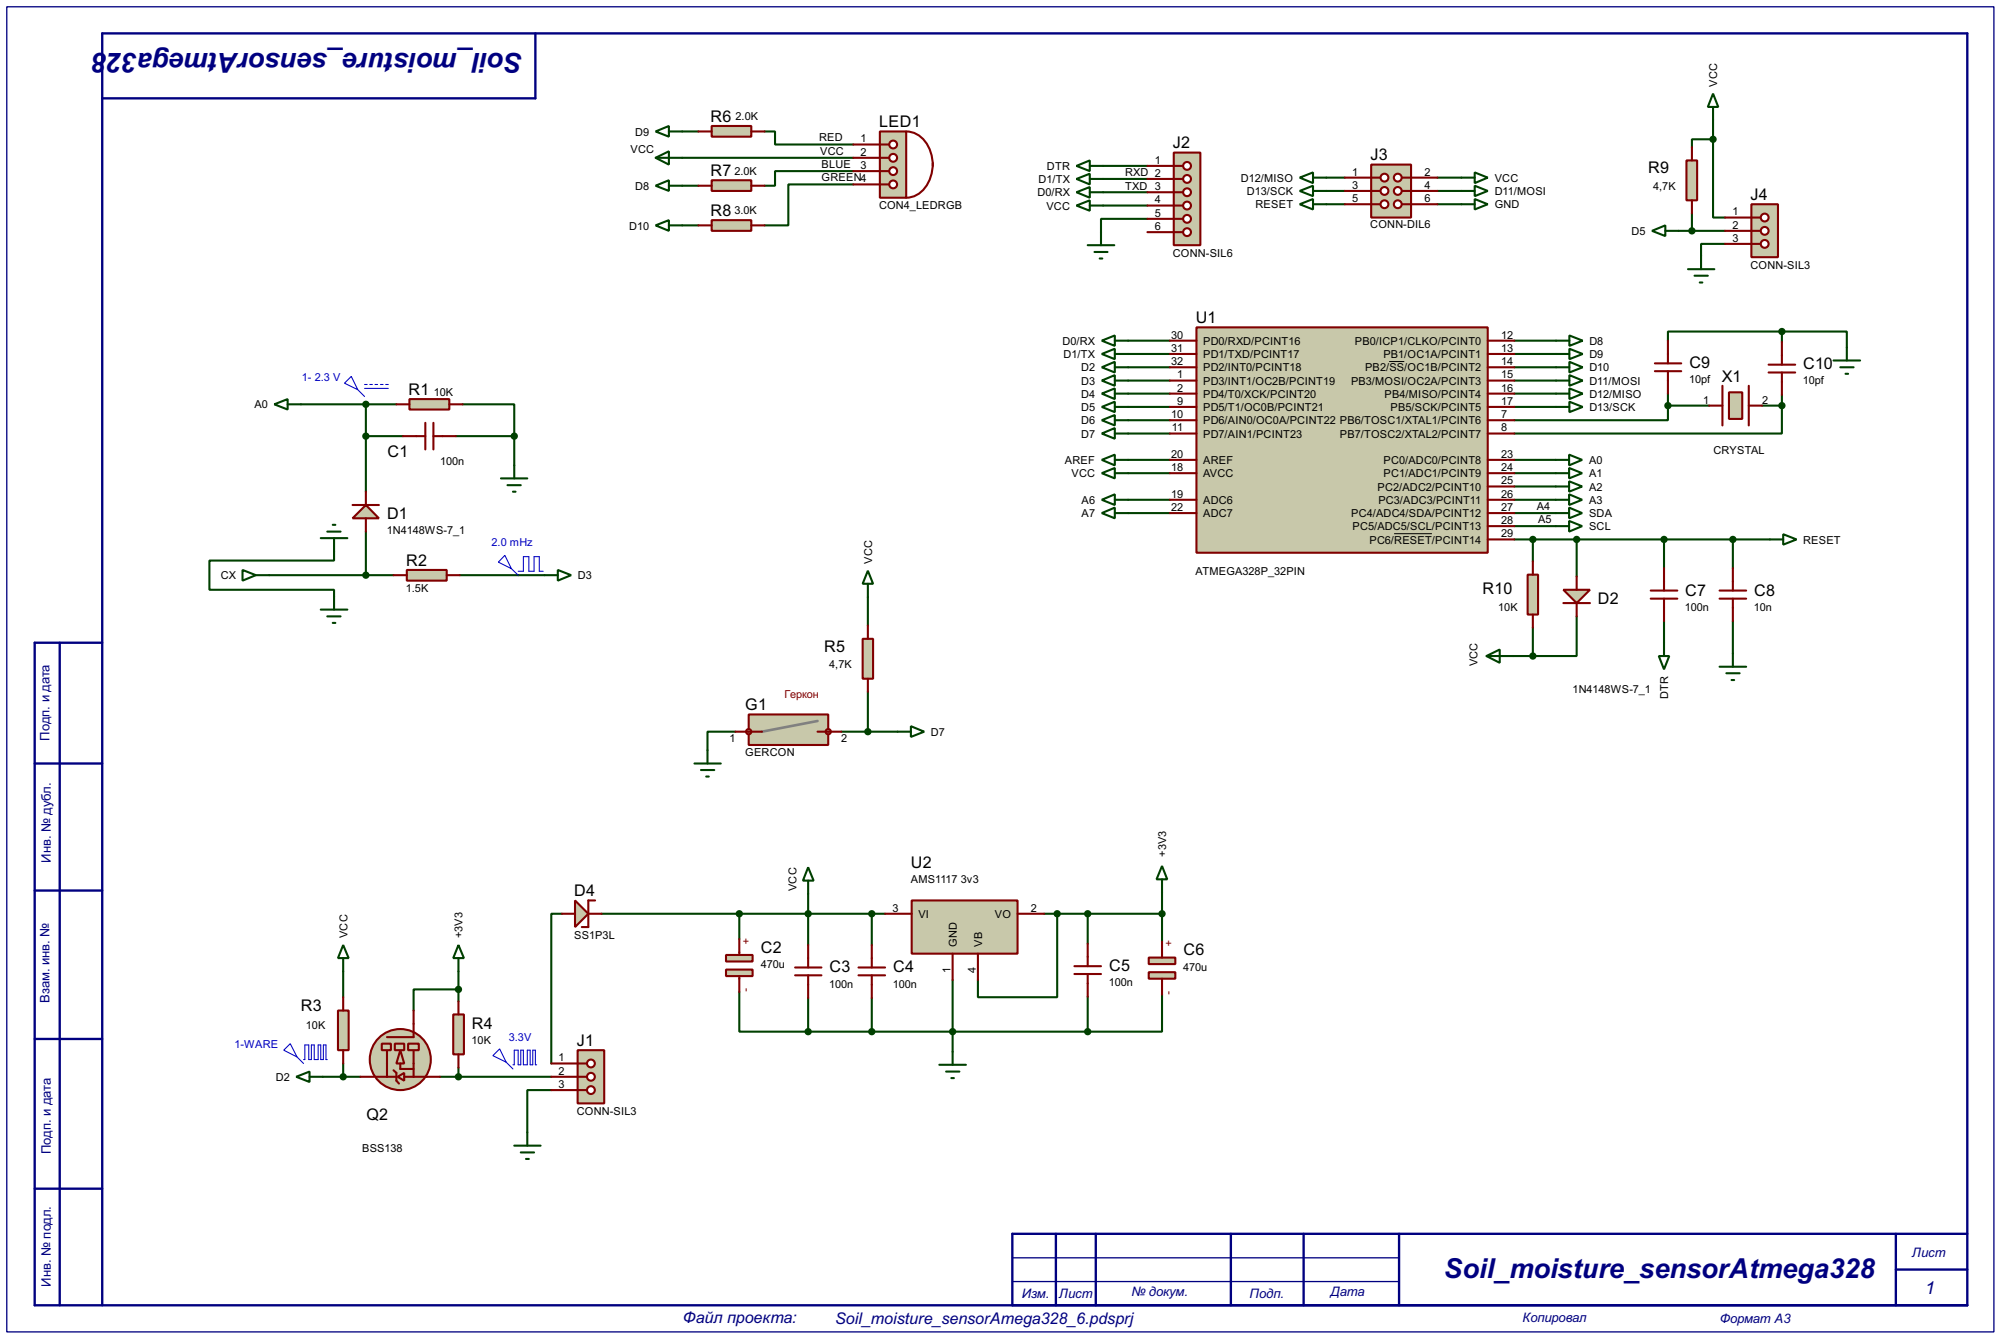
[picture p46: page 1]

Инв. № подл. Подп. и дата Взам. инв. № Инв. № дубл. Подп. и дата
