madeonline/GreenhouseProject_continuation/Радиомодуль внешних датчиков/Proteus/UniversalSensorsModuleDS1820/UniversalSensorsModuleDS1820_02.PDF

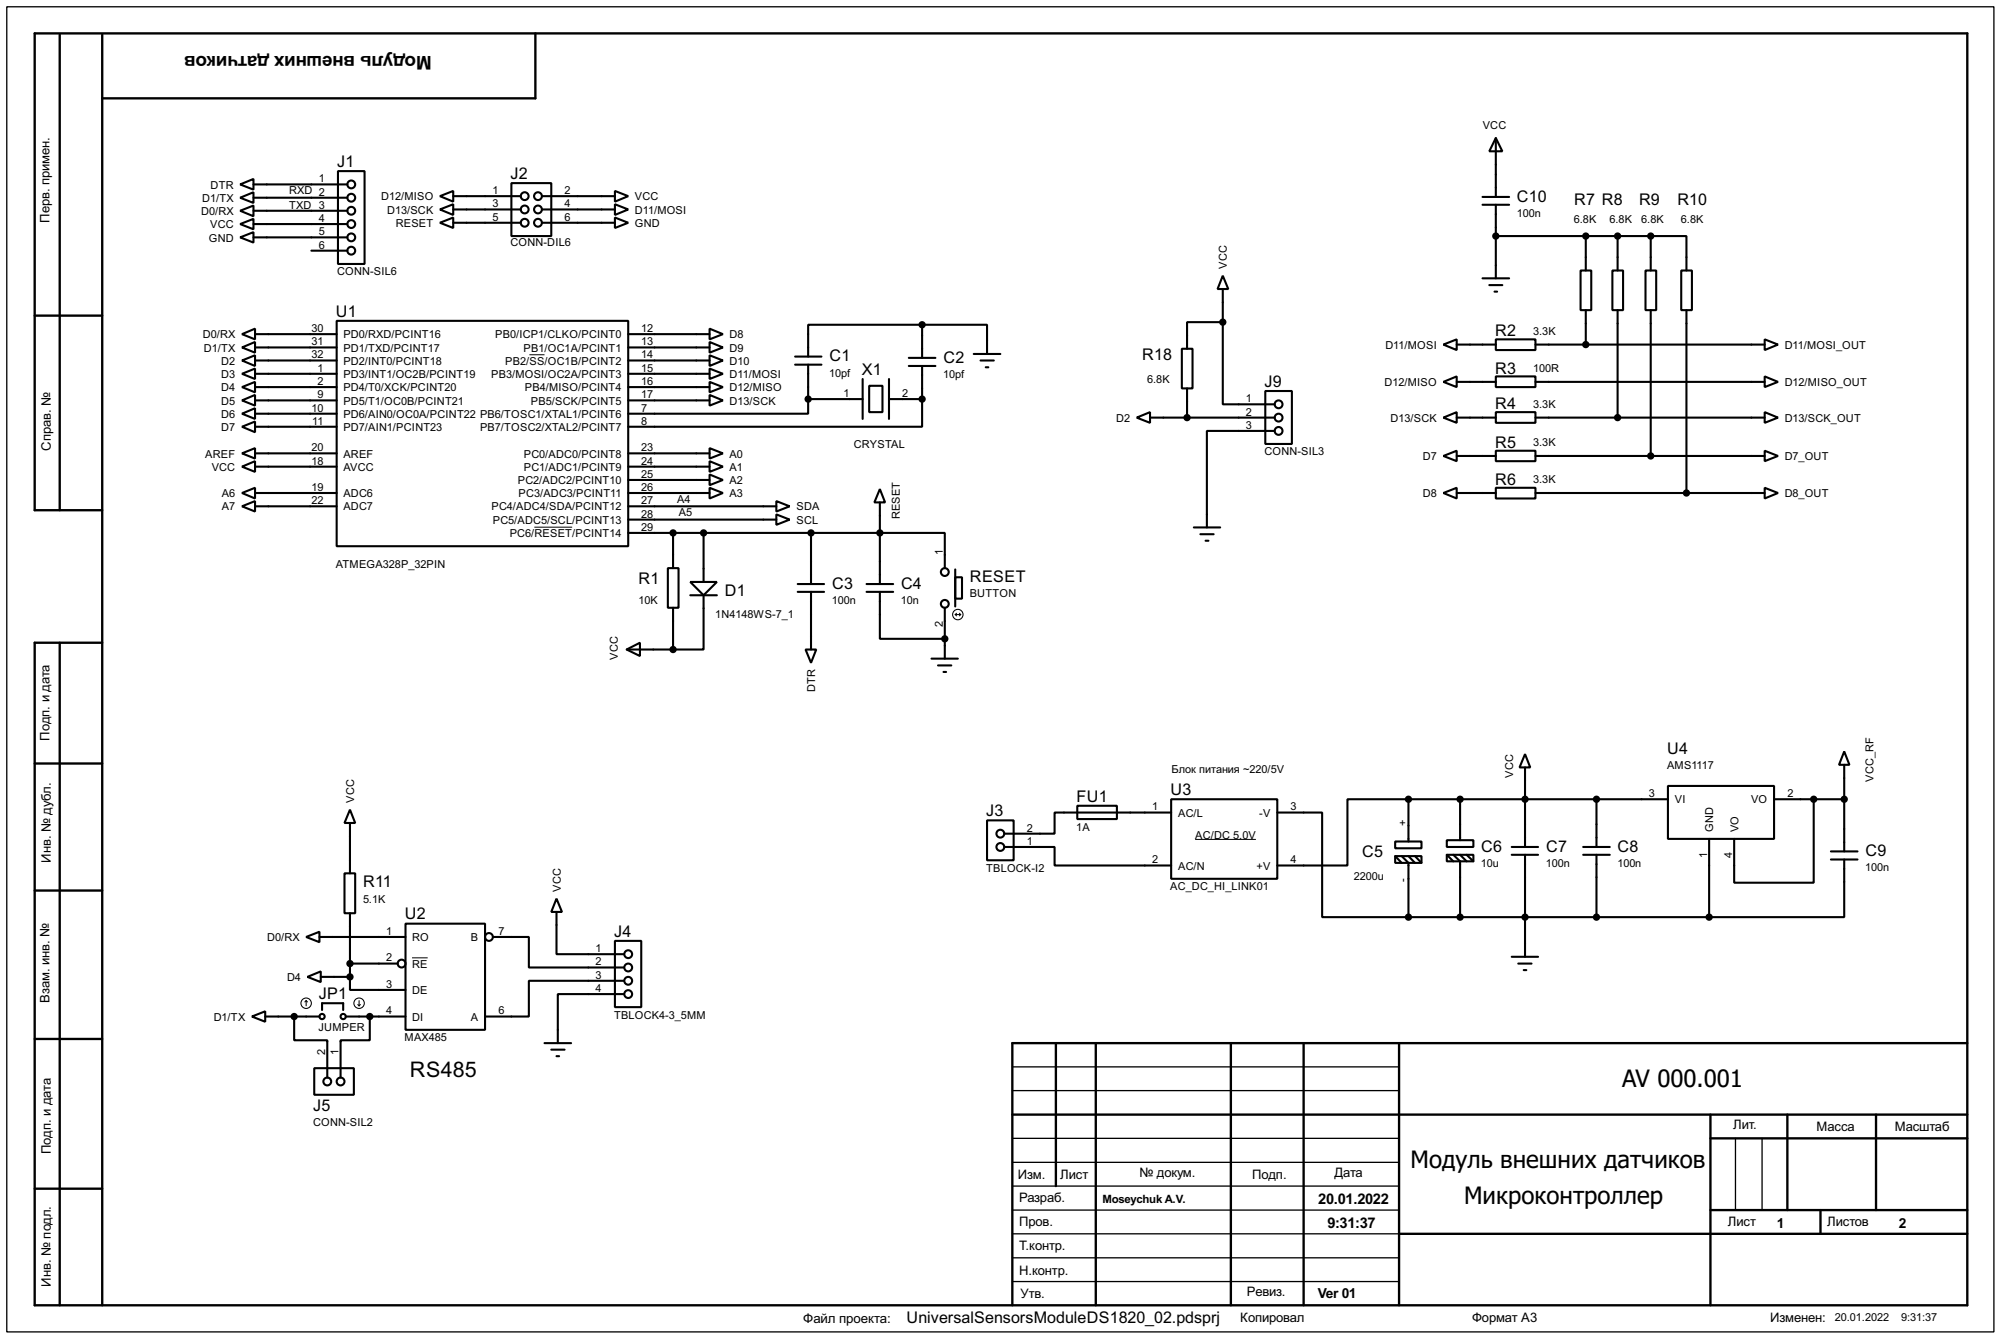
[picture p47: page 1]

Инв. № подл. Подп. и дата Взам. инв. № Инв. № дубл. Справ. № Перв. примен. Подп. и дата

Модуль внешних датчиков Микроконтроллер | Лит. | Масса | Масштаб

Изм. Лист Разраб. Пров. Т.контр. Н.контр. Утв. | | 9:31:37 | | Лист 1 | Листов 2

№ докум. | Подп. | Дата

Moseychuk A.V. | | 20.01.2022

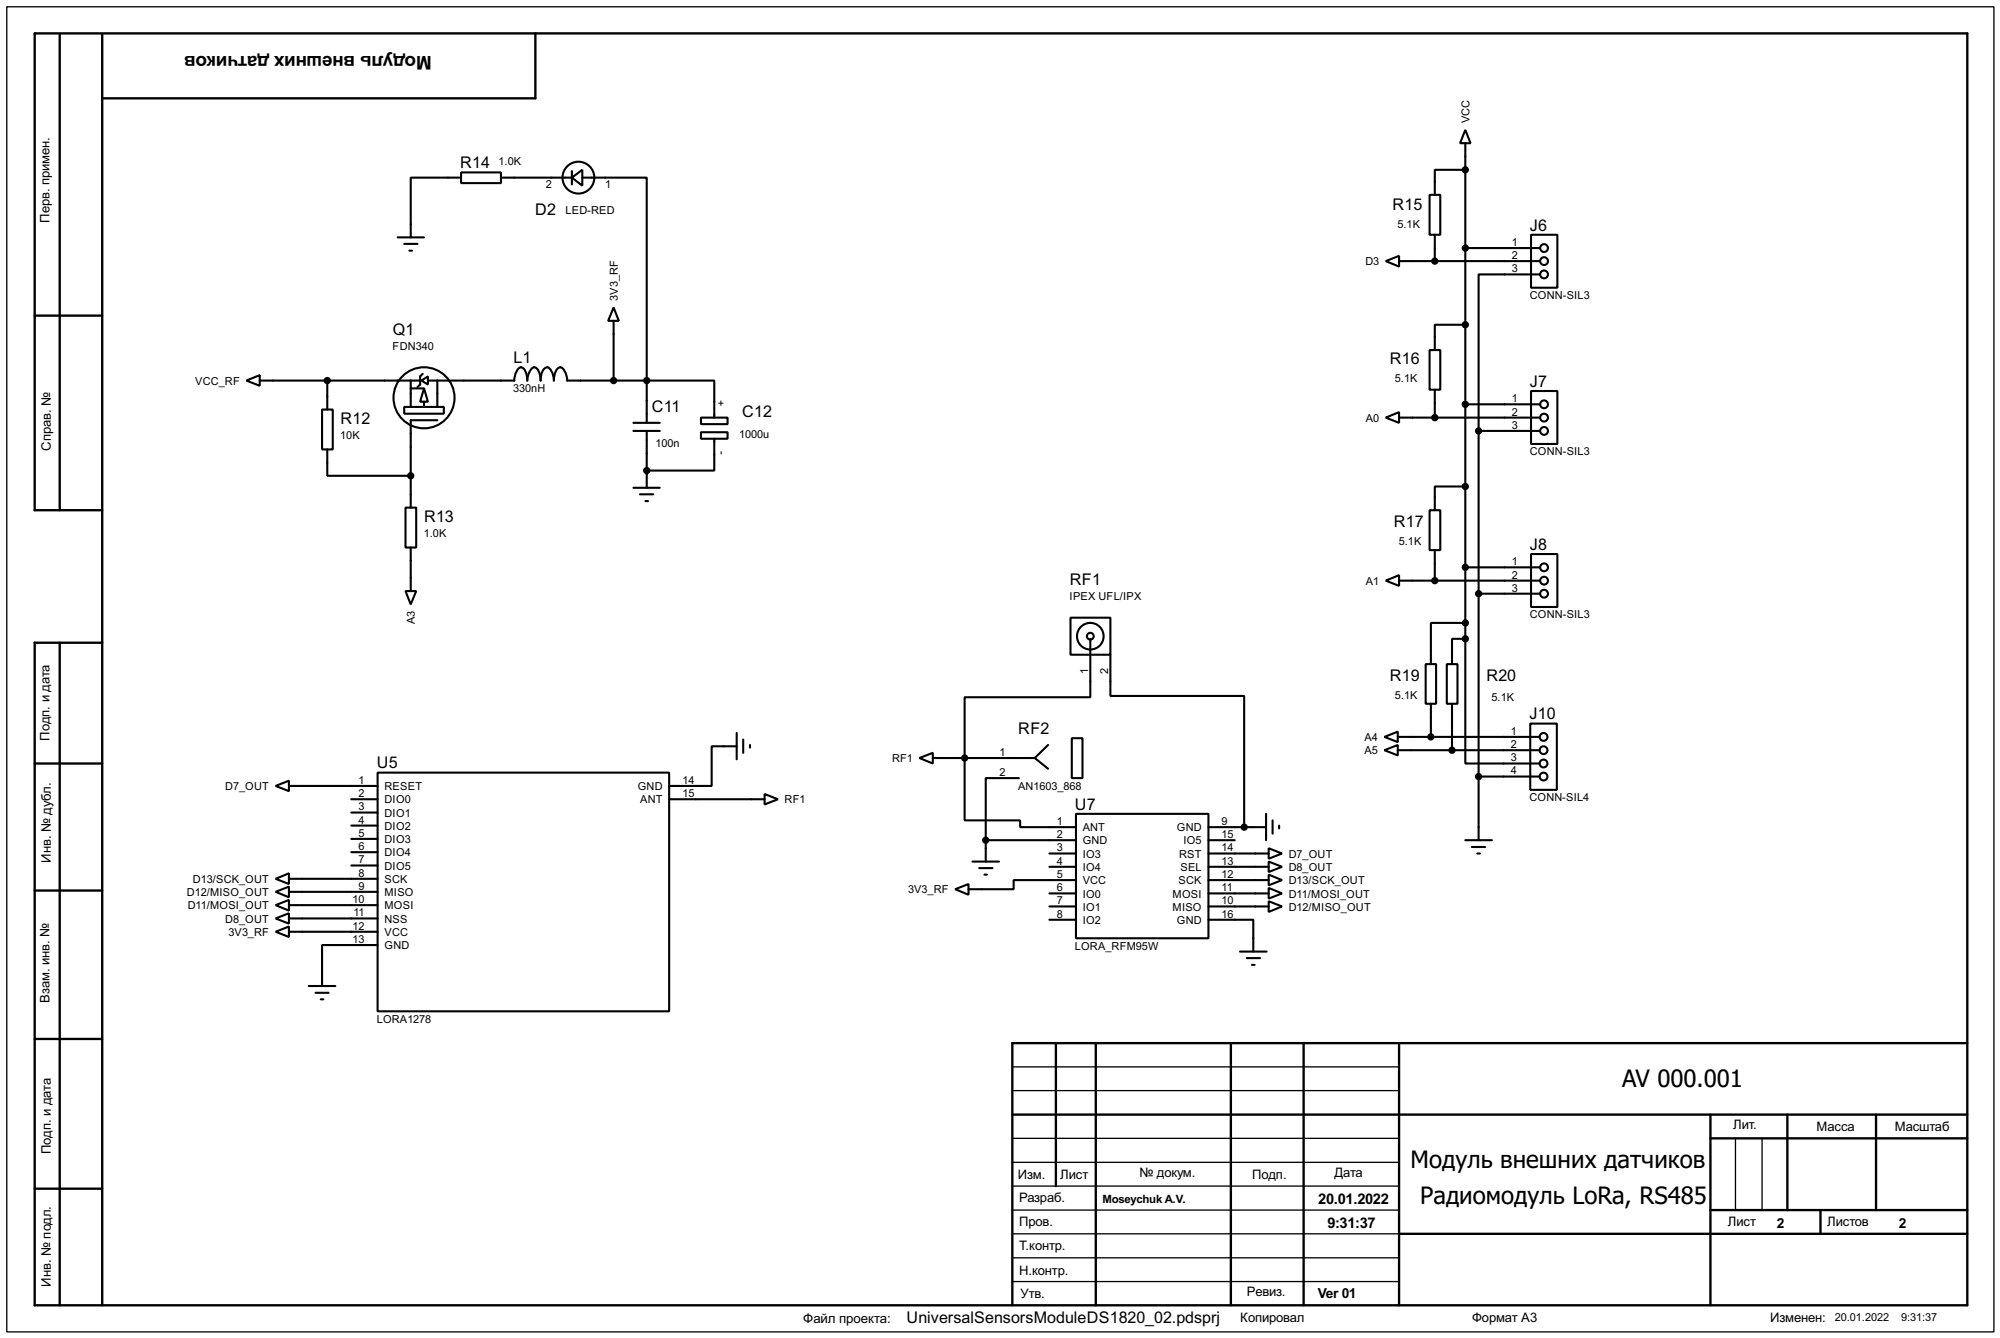
[picture p48: page 2]

Инв. № подл. Подп. и дата Взам. инв. № Инв. № дубл. Справ. № Перв. примен. Подп. и дата

Модуль внешних датчиков Радиомодуль LoRa, RS485 | Лит. | Масса | Масштаб

Изм. Лист Разраб. Пров. Т.контр. Н.контр. Утв. | | 9:31:37 | | Лист 2 | Листов 2

№ докум. | Подп. | Дата

Moseychuk A.V. | | 20.01.2022
