madeonline/GreenhouseProject_continuation/Радиомодуль управления фрамугами/Project ControllerModule_Framug/Proteus/UniversalControllerModule_Framug2/ControllerModule_Framug2.PDF

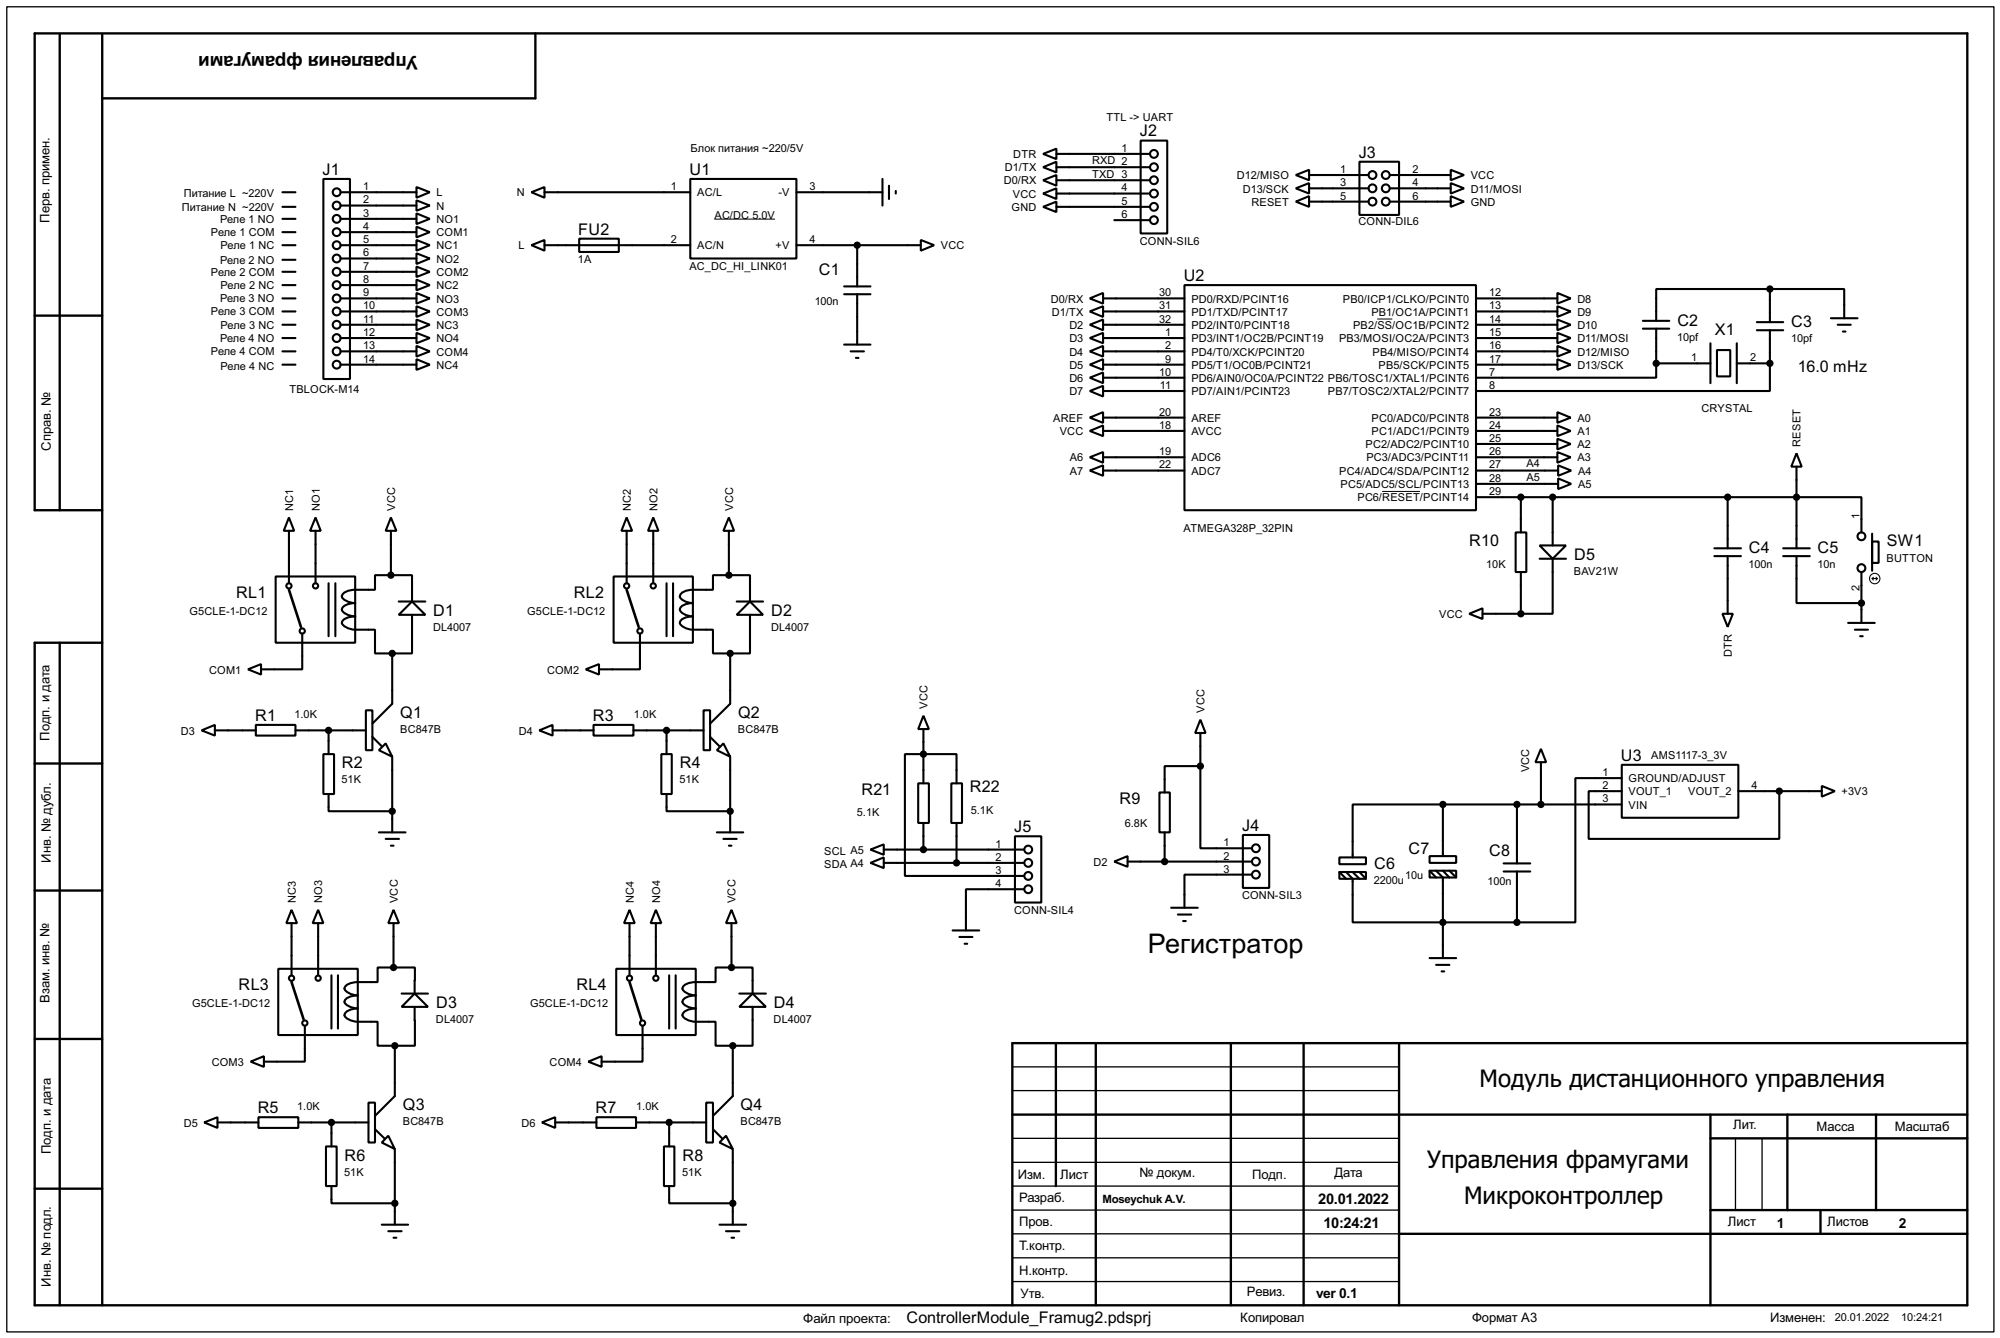
[picture p49: page 1]

Инв. № подл. Подп. и дата Взам. инв. № Инв. № дубл. Справ. № Перв. примен. Подп. и дата

Модуль дистанционного управления

Управления фрамугами Микроконтроллер | Лит. | Масса | Масштаб

Изм. Лист Разраб. Пров. Т.контр. Н.контр. Утв. | | 10:24:21 | | Лист 1 | Листов 2

№ докум. | Подп. | Дата

Moseychuk A.V. | | 20.01.2022

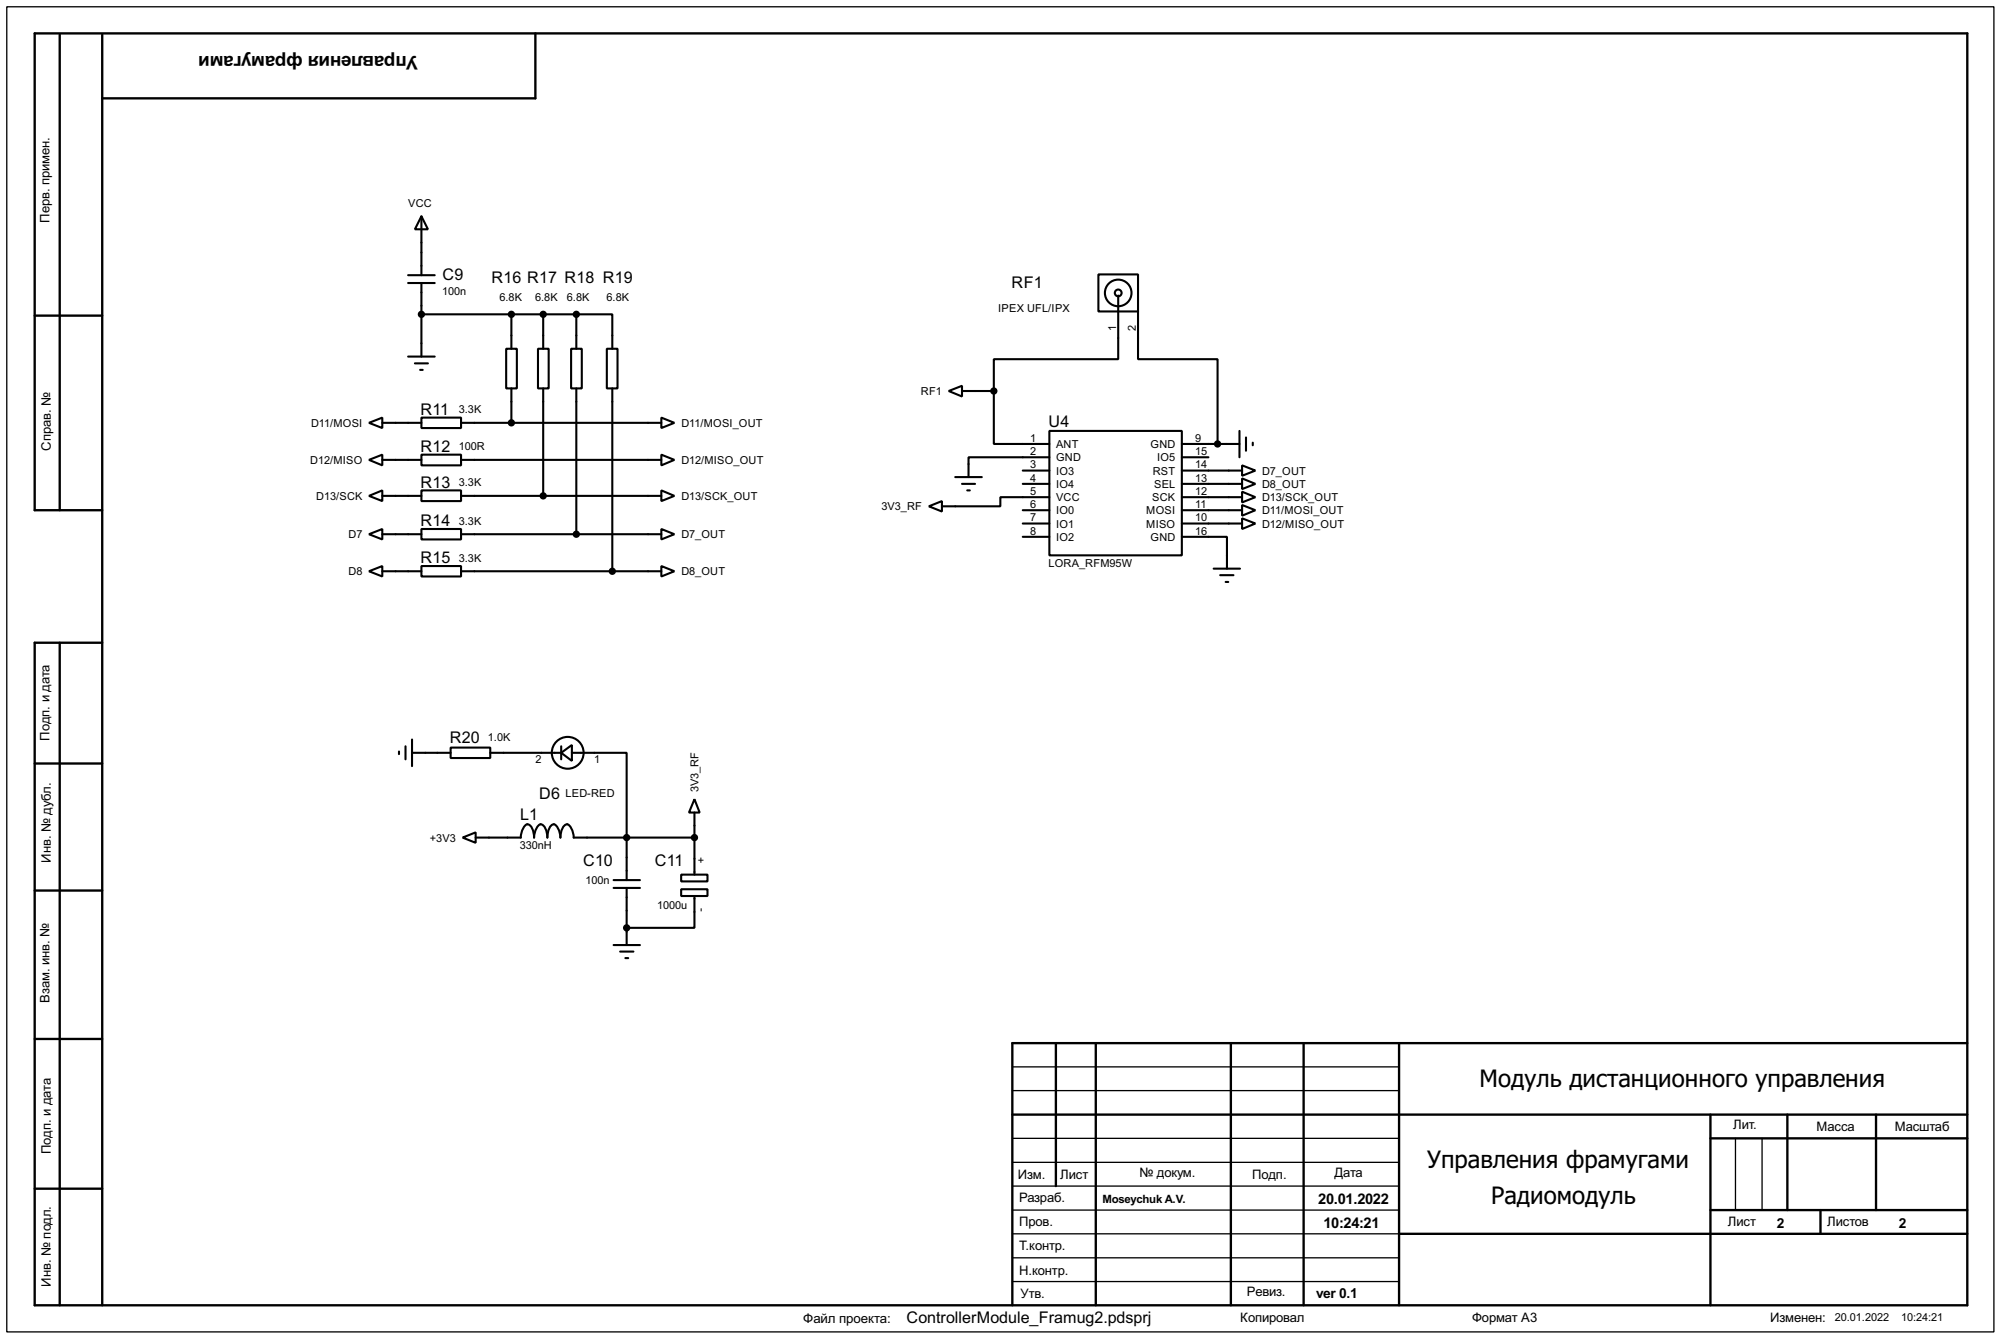
[picture p50: page 2]

Инв. № подл. Подп. и дата Взам. инв. № Инв. № дубл. Справ. № Перв. примен. Подп. и дата

Модуль дистанционного управления

Управления фрамугами Радиомодуль | Лит. | Масса | Масштаб

Изм. Лист Разраб. Пров. Т.контр. Н.контр. Утв. | | 10:24:21 | | Лист 2 | Листов 2

№ докум. | Подп. | Дата

Moseychuk A.V. | | 20.01.2022
