madeonline/GreenhouseProject_continuation/Радиомодуль управления фрамугами/Project ControllerModule_Framug/Proteus/UniversalControllerModule_Framug1/ControllerModule_Framug1.PDF

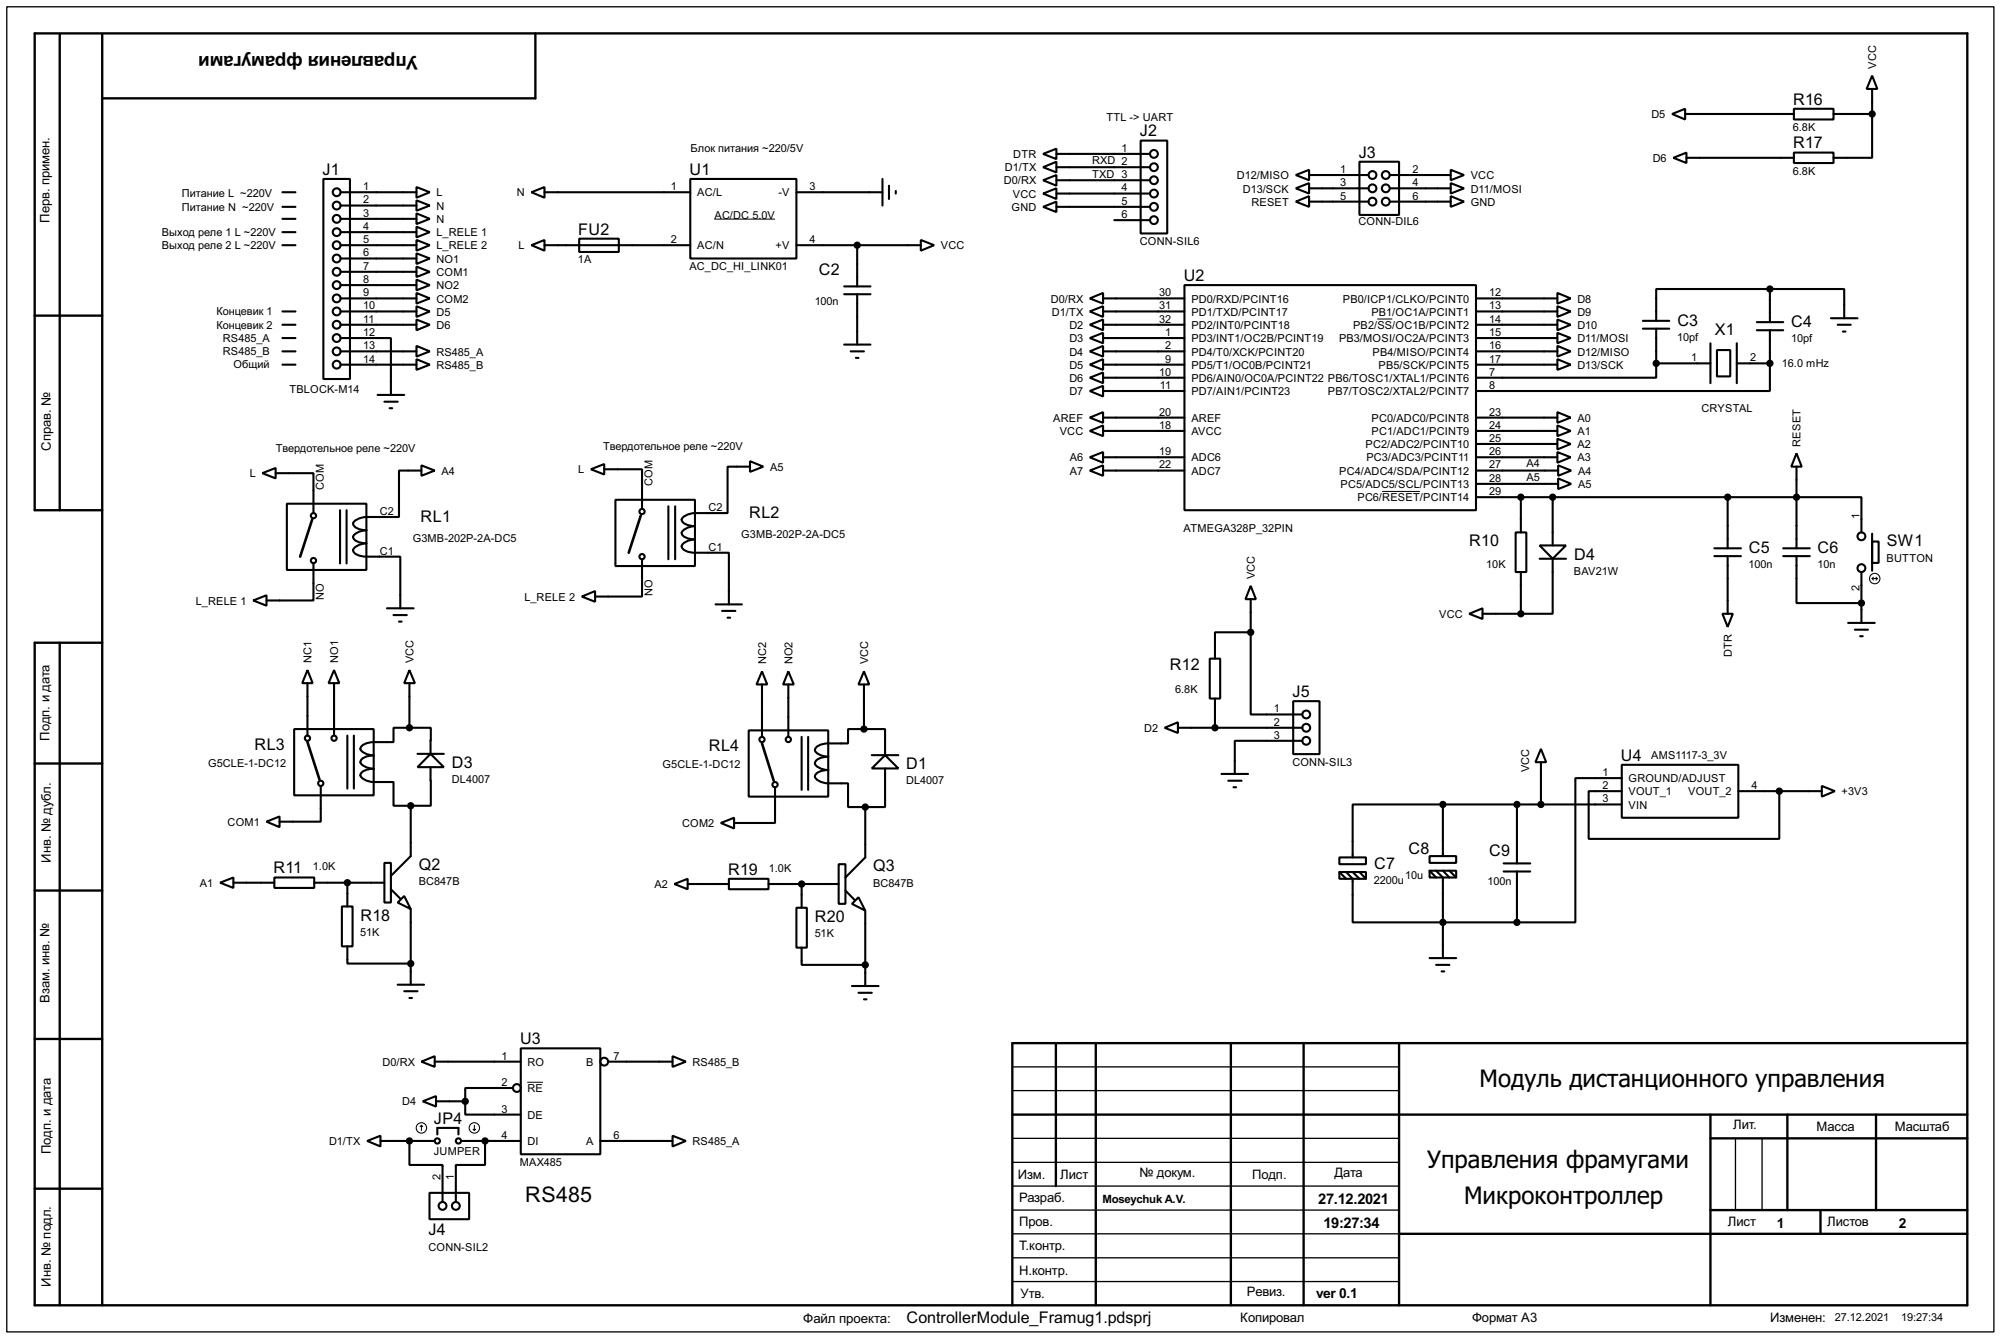
[picture p51: page 1]

Инв. № подл. Подп. и дата Взам. инв. № Инв. № дубл. Справ. № Перв. примен. Подп. и дата

Модуль дистанционного управления

Изм. Лист Разраб. Пров. Т.контр. Н.контр. Утв. | | 19:27:34 | | Лист 1 | Листов 2

№ докум. | Подп. | Дата

Moseychuk A.V. | | 27.12.2021

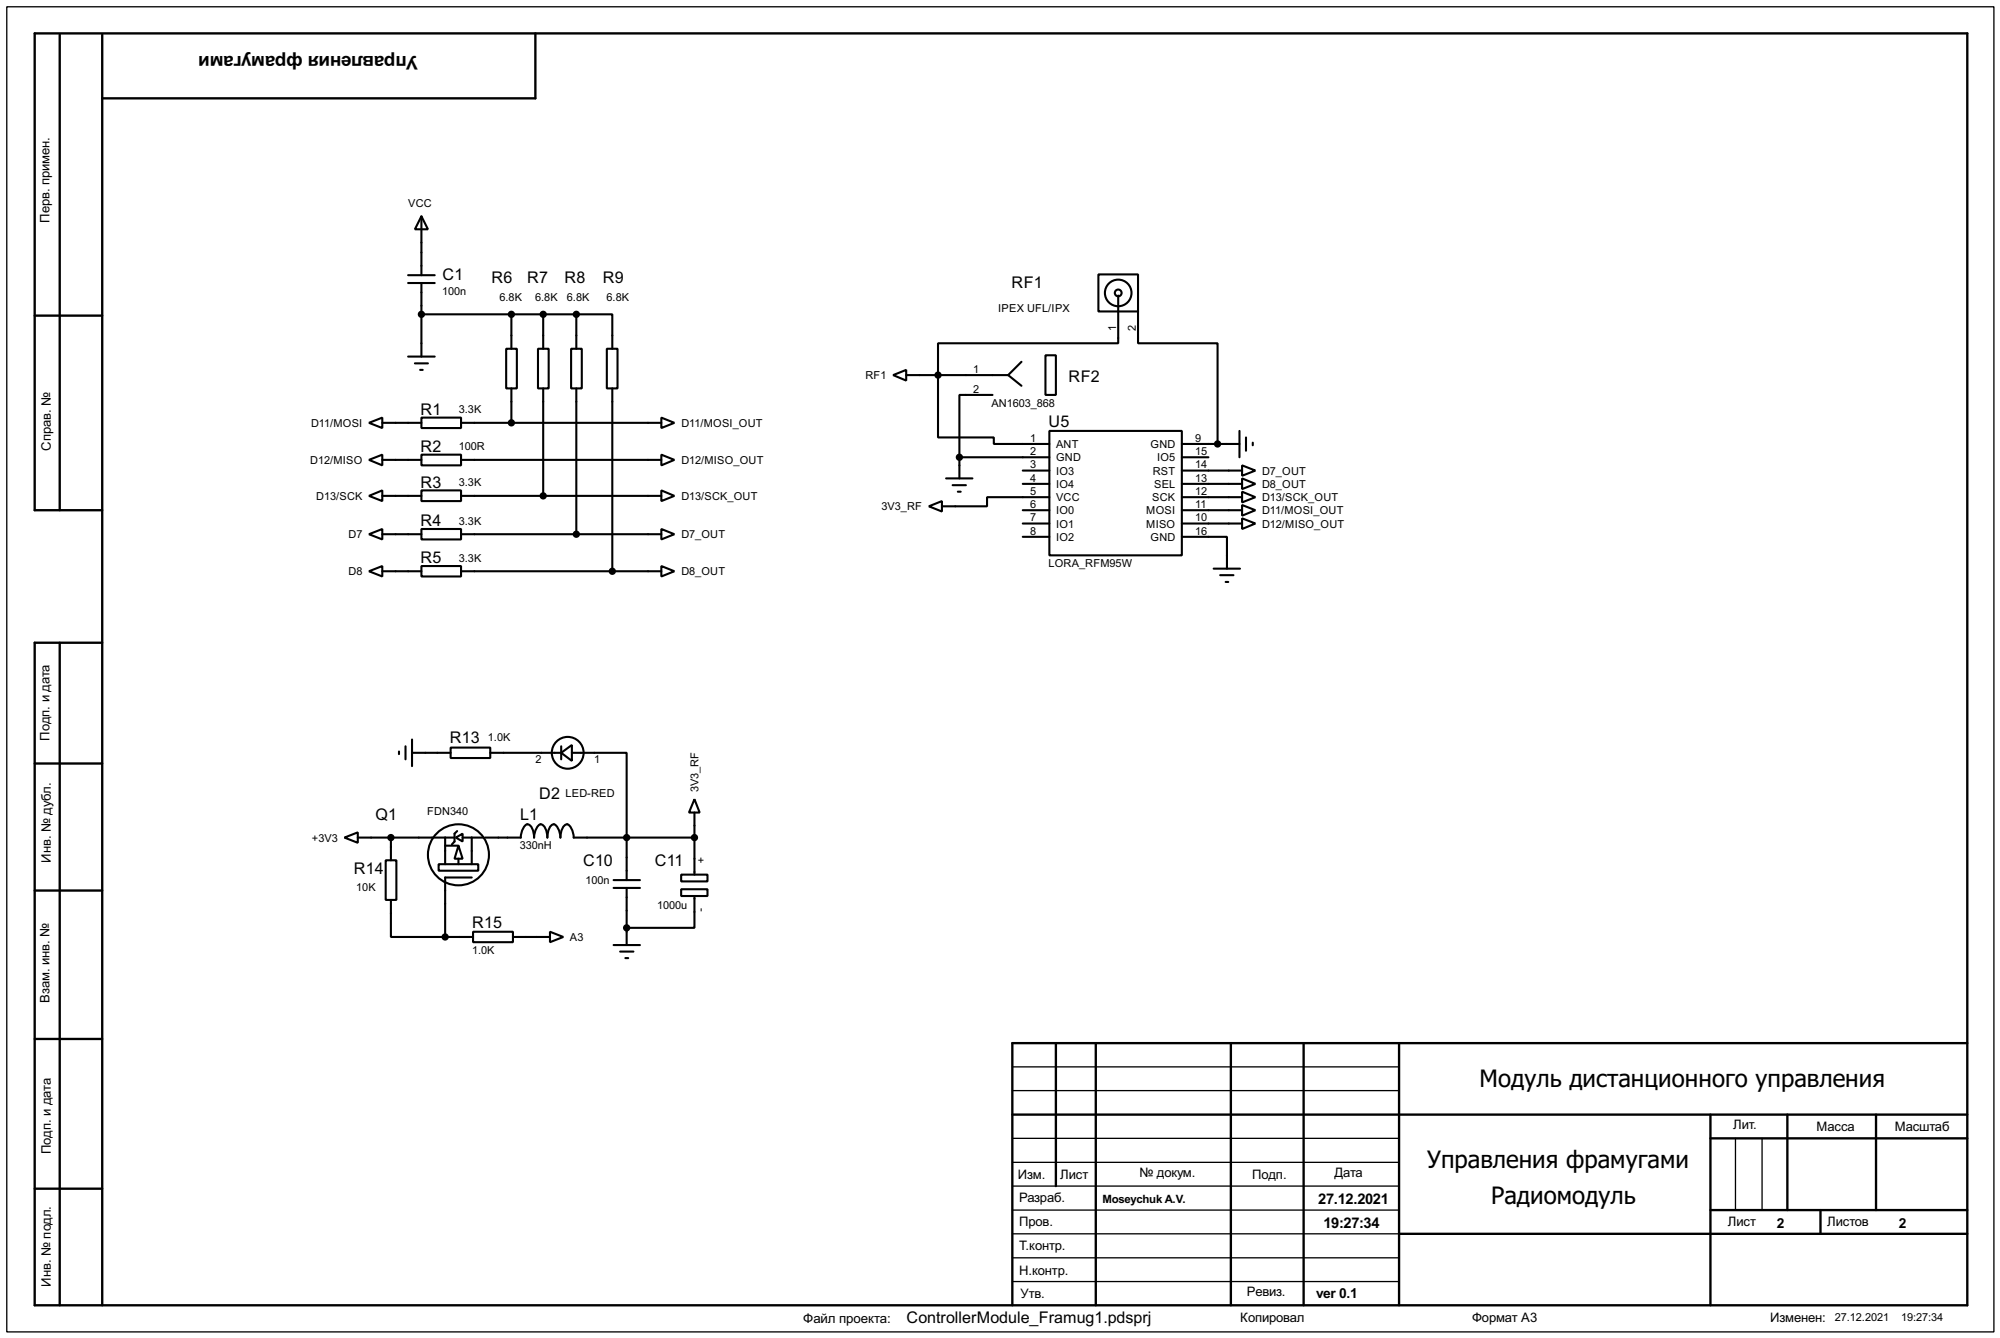
[picture p52: page 2]

Инв. № подл. Подп. и дата Взам. инв. № Инв. № дубл. Справ. № Перв. примен. Подп. и дата

Модуль дистанционного управления

Управления фрамугами Радиомодуль | Лит. | Масса | Масштаб

Изм. Лист Разраб. Пров. Т.контр. Н.контр. Утв. | | 19:27:34 | | Лист 2 | Листов 2

№ докум. | Подп. | Дата

Moseychuk A.V. | | 27.12.2021
