madeonline/GreenhouseProject_continuation/(list of files, drawings)

Other design files:
Внешний модуль полива/WateringExecutionModule_01.pdsprj
Внешний модуль полива/Модуль полива шилд.pdsprj
Датчик влажности грунта/Soil_moisture_sensorAmega328_6/Soil_moisture_sensorAmega328_6.pdsprj
Приемник метеостанции_MisolAmega328/Receive_MisolAmega328_1.pdsprj
Радиомодуль внешних датчиков/Proteus/UniversalSensorsModuleDS1820/UniversalSensorsModuleDS1820_02.pdsprj
Радиомодуль управления фрамугами/Project ControllerModule_Framug/Proteus/UniversalControllerModule_Framug1/ControllerModule_Framug1.pdsprj
Радиомодуль управления фрамугами/Project ControllerModule_Framug/Proteus/UniversalControllerModule_Framug1/Модуль фрамуг шилд1.pdsprj
Радиомодуль управления фрамугами/Project ControllerModule_Framug/Proteus/UniversalControllerModule_Framug1/Модуль фрамуг шилд2.pdsprj
Радиомодуль управления фрамугами/Project ControllerModule_Framug/Proteus/UniversalControllerModule_Framug2/ControllerModule_Framug2.pdsprj
Ультразвуковой модуль уровня воды/UniversalUltrasonicModule_02/UltrasonicWaterTankModule_21_10_02/DOC/UltrasonicWaterTankModuleR1.pdsprj
Ультразвуковой модуль уровня воды/UniversalUltrasonicModule_02/UltrasonicWaterTankModuleR1.pdsprj
Ультразвуковой модуль уровня воды/UniversalUltrasonicModule_02/Модуль ультразвуковой шилд.pdsprj
