madeonline/GreenhouseProject_continuation/Радиомодуль внешних датчиков/Soft/UniversalSensorsModule2/BH1750.h

#ifndef _BH1750_H
#define _BH1750_H

#include <Arduino.h>
// смотрим, какие методы Wire актуальны - чтоб не париться с препроцессором в рабочем коде
#if (ARDUINO >= 100)
  #define BH1750_WIRE_READ Wire.read
  #define BH1750_WIRE_WRITE Wire.write
#else
  #define BH1750_WIRE_READ Wire.receive
  #define BH1750_WIRE_WRITE Wire.send
#endif


typedef enum
{
  ContinuousHighResolution = 0x10,
  ContinuousHighResolution2 = 0x11,
  ContinuousLowResolution = 0x13
    
} BH1750Mode;

enum { BH1750PowerOff=0x00, BH1750PowerOn=0x01, BH1750Reset = 0x07 };

typedef enum { BH1750Address1 = 0x23, BH1750Address2 = 0x5C } BH1750Address; // адрес датчика освещенности на шине I2C

class BH1750Support
{
  private:
    void writeByte(uint8_t toWrite);

    BH1750Address deviceAddress;
    BH1750Mode currentMode;
  
  public:
    BH1750Support();
    
    void begin(BH1750Address addr = BH1750Address1, BH1750Mode mode = ContinuousHighResolution);
    
    void ChangeMode(BH1750Mode newMode);
    void ChangeAddress(BH1750Address newAddr);
     
    long GetCurrentLuminosity();
};

#endif
