madeonline/GreenhouseProject_continuation/Радиомодуль внешних датчиков/Soft/UniversalSensorsModule2/DHTSupport.h

#ifndef _DHT_SUPPORT_H
#define _DHT_SUPPORT_H

#if ARDUINO < 100
#include <WProgram.h>
#else
#include <Arduino.h>
#endif

#include "UniGlobals.h"

typedef enum { DHT_11, DHT_2x } DHTType; // тип датчика, который опрашиваем, поскольку у DHT11 немного другой формат данных
enum { DHT2x_WAKEUP=1, DHT11_WAKEUP=18 }; // таймауты инициализации для разных типов датчиков



class DHTSupport
{
  private:

  DHTType type;

  public:
    DHTSupport(DHTType sensorType);
    void read(uint8_t pin, HumidityAnswer& answer); // читаем показания с датчика
};

#endif
