madeonline/GreenhouseProject_continuation/MAIN/InfoDiodes.h

#pragma once
//--------------------------------------------------------------------------------------------------
#include <Arduino.h>
//--------------------------------------------------------------------------------------------------
class InfoDiodesList
{
  public:
    InfoDiodesList();
    void begin();

    void ready(bool on=true);
    void failure(bool on=true);
    void test(bool on=true);

  private:
};
//--------------------------------------------------------------------------------------------------
extern InfoDiodesList InfoDiodes;
//--------------------------------------------------------------------------------------------------
