madeonline/GreenhouseProject_continuation/(commit log)

2018-02-26 Добавил документацию по УРОВ и тестеру УРОВ
2018-02-26 Добавил файл Назначение выводов УРОВ SAM3X8E
    [Назначение выводов УРОВ SAM3X8E.xls]
2018-02-26 Изменил вывод импульса имитации магнитного датчика.
2018-02-26 добавил паузу в 5 секунд между сценами импульсов
2018-02-26 Изменил время между импульсами.
2018-02-26 поменял местами импульсы
2018-02-26 Изменил количество импульсов тестера, имитация индуктивного датчика.
2018-02-26 Изменил нижний порог синхронизации синусоиды. Увеличил поиск нижней точки до 48 точек
2018-02-27 Установлена на компьютере Decima
2018-02-27 Добавил файл LoRaSenderTestDima.ino
2018-02-27 Тестирование GIT
2018-02-27 Уточнил входа индикации
    [Назначение выводов УРОВ SAM3X8E.xls]
2018-02-27 Синхронизация по одному графику
2018-02-27 Поправил синхронизацию
2018-02-27 правка отладочной инфы
2018-02-27 Редактирование выводов УРОВ
    [Назначение выводов УРОВ SAM3X8E.xls]
2018-02-27 Исправление ошибки GIT
2018-02-27 Изменил подключение индуктивных датчиков к цифровым портам
    [Назначение выводов УРОВ SAM3X8E.xls]
2018-02-27 Добавил файл "Программа по прерыванию"
2018-02-27 Исключил Debug
2018-02-28 Прерывания
2018-03-02 Тестирование прерывания
2018-03-02 Перечень работ по программированию УРОВ
    [UROV_Base4_1R.pdsprj]
2018-03-02 Изменения в схеме модуля
    [UROV_4_2R.pdsprj, UROV_Base4_1R.pdsprj]
2018-03-02 Исправлены ошибки в прерывании.
2018-03-02 Добавил схему дисплея. Уточнил назначение выводов микроконтроллера.
    [UROV_display_ LGDP4524_1R.pdsprj, Назначение выводов УРОВ SAM3X8E.xls]
2018-03-02 Добавил принудительный сброс дисплея при старте.
2018-03-02 поправил работу с прерываниями
2018-03-02 кнопки и светодиоды
2018-03-02 Добавил тест.
2018-03-02 Обновление кнопок
2018-03-05 Изменил настройки импульсов
2018-03-07 Уточнения в программе теста
2018-03-07 Добавил программу тестирования прерывания
    [Proteus_Tester_SAMD21G_01.pdsprj]
2018-03-07 Добавил задержку в InterruptHandler.cpp
2018-03-08 Попытка по другому организовать работу с прерываниями
2018-03-09 Уточнение параметров теста
2018-03-13 Переделал обработчик прерываний на событийный интерфейс
    Сабж. Это поможет нам использовать один обработчик прерываний в разных экранах. Надо подумать, нет ли в этой концепции слабых мест, новые экраны нарисовать недолго ;)
2018-03-14 Автоотключение обработчика результатов прерываний
    При переходе на любой экран, кроме главного - отключается обработчик результатов прерываний, чтобы обеспечить целостность работы с меню.
2018-03-16 Экран настроек эталонов
2018-03-16 revert back with interrupts
2018-03-16 turn off 2 and 3 interrupts
2018-03-17 Работа со списками прерываний
    Переписал логику отображения списка прерываний, подробности - в файле InterruptHandler.cpp
2018-03-18 Поправил работу кнопок, попытка синхронизировать отрисовку графиков.
2018-03-19 Тест
2018-03-20 Перенёс реакцию на срабатывание прерываний в класс прерываний
2018-03-20 Удалил testSAM3X8E
2018-03-20 Больше отладочной информации
2018-03-20 Ещё больше отладочной информации
2018-03-21 ТЗ на Март 2018г.
2018-03-21 Уточнение ТЗ Март.
2018-03-21 Уточнение ТЗ Март
2018-03-21 Нормализация списков прерываний
2018-03-21 нормализация
2018-03-21 расчёт графика
2018-03-22 Добавил программу теста с приемником LoRa. Настроен на прием пакетов.
2018-03-22 Схема модуля УРОВ
2018-03-22 Основное меню
2018-03-22 Новая структура меню
2018-03-23 В конец ТЗ добавил “ Дополнения, уточнения” Добавил файл с примером клавиатуры. “Пример клавиатуры.txt”
2018-03-24 Уточнения ТЗ на март.
2018-03-24 Перенёс документацию в формат DOC, чтобы можно было легко править выполненные пункты.
2018-03-24 Исправил свои ошибки в тексте.
2018-03-24 Некоторые изменения по текущим задачам
2018-03-24 Изменения в документации
2018-03-24 Запись даты/времени срабатывания системы в файл
2018-03-24 Не знаю что изменилось. ничего не менял.
2018-03-24 Исправил переменную
2018-03-24 Запись факта срабатывания прерываний в файл
2018-03-24 Цвета кнопок для промежуточных экранов
2018-03-24 Первая версия класса настроек + цвета для кнопок промежуточных экранов TFT
2018-03-24 Уточнение данных
    [Назначение выводов УРОВ SAM3X8E.xls]
2018-03-24 Уточнение
2018-03-25 Кучу всяких изменений
2018-03-26 Уточнение схемы
2018-03-26 Вывод 200 вольт убрал числа после запятой. Сместил на 1 позицию влево вывод версии программы.
2018-03-26 Изменил цветовую схему вывода напряжения и числовые параметры. Увеличил интервалы прерывания в тестовом модуле до 20 сек.
2018-03-26 Настройка измерения источников питания
2018-03-26 Увеличено количество аналоговых входов до 9. Настройка.
2018-03-26 Частично решено чтение аналоговых входов.
2018-03-26 Добавлено измерение источников питания
2018-03-26 Сохранил библиотеку UTFT
2018-03-26 Работа с лог-файлами, показания вольтажа, допилинг отрисовки кнопок и т.п.
2018-03-27 Первая версия экранной клавиатуры
2018-03-27 Уточнения по библиотекам
2018-03-27 Уточнил параметры клавиатуры и измерение источников питания.
2018-03-27 Изменил отображение источников питания.
2018-03-27 Исправлено измерение источников питания.
2018-03-27 Настройки индуктивных датчиков - три экрана.
2018-03-28 Показания исправности индуктивных датчиков.
2018-03-28 Сменил порядок инициализации
2018-03-28 Немного изменил цвета отображения исправности индуктивных датчиков.
2018-03-28 Отредактировал файл "ТЗ на март.docx" для отчета.
2018-03-28 Правка состояния индуктивных датчиков
2018-03-28 Тест программы
2018-03-28 моторесурс + сброс на главный экран.
2018-03-29 Отображение моторесурса на экране прерываний
2018-04-02 Первая версия записи эталона
2018-04-03 Экран создания эталонов
2018-04-03 Запись положения штанги на момент прерываний в файл
2018-04-03 запись положения штанги в файл
2018-04-03 установка кнопок графика на первый график с данными
2018-04-04 Просмотр эталонов - начало
2018-04-04 Рефакторинг
2018-04-04 Просмотр эталона из файла
2018-04-04 Добавил информационный диод о прерывании в программу MeandrSAMD21G18A Отредактировал отчет ТЗ на Март
2018-04-04 Мигающая надпись превышения моторесурса
2018-04-04 мигание моторесурса
2018-04-04 неодновременное мигание моторесурса
2018-04-04 Костяк класса сравнения списка прерываний с эталоном
2018-04-05 Оптимизация работы со списками прерываний
2018-04-05 ревакторинг
2018-04-05 Оптимизация запроса времени с часов - не чаще раза в секунду
2018-04-05 Попытка переделать регистрацию пачек прерываний
2018-04-06 Изменил количество импульсов прерывания (по 30 на канал)
2018-04-06 Уточнение программы "Test_Interrupt.ino"
2018-04-06 Обновил программу Meandr
2018-04-06 поменял приоритеты прерываний
2018-04-06 попытка группировки прерываний
2018-04-06 поменял группу прерываний для импульсов
2018-04-06 группы приоритетов
2018-04-06 опять группы приоритетов
2018-04-06 тестовый вывод времени в Serial
2018-04-06 Устранены "пики" на графиках прерывания
2018-04-08 Поправил сброс TFT-дисплея
2018-04-09 Сравнение эталонов
2018-04-09 Запись результата сравнения в файл
2018-04-09 зажигание светодиодов в зависимости от результатов сравнения
2018-04-09 гасим светодиоды прерываний
2018-04-09 Разные датчики для каждой штанги
2018-04-09 зажигание светодиодов + правка цветов графиков
2018-04-10 вывод файла с COM-порт
2018-04-10 начало механизма общения с внешним миром
2018-04-10 поправил ошибку совместной работы с файлами парсера команд и экрана логов
2018-04-10 Заблокировал вывод в КОМ порт тестовой информации.
2018-04-10 Список поддерживаемых команд
2018-04-10 Добавил вывод версии софта в Serial при старте UROV
2018-04-13 первая версия софта
2018-04-13 Изменил иконку и добавил информационный текст
2018-04-13 Добавил защиту от повторного включения и иконку программы.
2018-04-13 Установил защиту от повторного запуска.
2018-04-16 изменения по софту
2018-04-16 удаление выбранного файла
2018-04-16 команда получения размера файла
2018-04-19 Тестирование
2018-04-25 Графики и лог-файлы в софте
2018-04-26 запись информации по прерываниям в лог.
2018-04-26 перевод записи лога в бинарный формат
2018-04-26 добавил нужные на будущее перечисления в софт ПК
2018-04-27 Первая версия парсинга лог-файла, пока без вывода в UI
2018-04-27 Визуализация лог-файлов в софте ПК
2018-04-27 пофиксил заголовок формы
2018-04-27 Изменил формат лога - теперь туда пишутся данные эталона, с которым сравнивали
2018-04-29 авторство в окне About
2018-04-29 Уникальный ID контроллера - установка софтом ПК.
2018-05-01 Выгрузка эталона с ПК в контроллер
2018-05-01 таймаут вычитки данных файла из потока. Загрузка файлов глючит, на стороне контроллера работает через раз
2018-05-02 Фикс загрузки эталоона в контроллер - C# виснет, если писать сразу весь буфер в порт, приходится писать побайтово
2018-05-02 убрал кнопку "Загрузить эталон"
2018-05-03 Редактирование имени контроллера
2018-05-03 Имя контроллера, редактирование
2018-05-03 Заглушка для архивации данных с контроллера
2018-05-04 Импорт настроек, пока без сохранения на диске
2018-05-07 Сохранение и просмотр архива
2018-05-07 Обновил скетч генератора
2018-05-07 Контроль сигнала срабатывания защиты
2018-05-07 Синхронизация GIT
    [Proteus_Tester_SAMD21G_01.pdsprj]
2018-05-08 Изменение загрузки эталона
2018-05-08 Изменил pin входа реле защиты.
2018-05-08 В программе MeandrSAMD21G18A изменил период следования. В программе УРОВ изменил вход реле защиты на 12 pin/ Выход АСУ ТП на 50 pin для удобного тестирования.
2018-05-08 Поменял тип переменной
2018-05-08 Отображение времени меджу срабатыванием реле защиты и первым прерыванием
2018-05-08 Установка порогов трансформатора
2018-05-08 настройки порогов по умолчанию
2018-05-08 Установка порогов АЦП при старте в работу
2018-05-10 Изменил настройки задержки в MeandrSAMD21G18A
2018-05-10 Создание нового проекта. Аварийный регистратор переменного тока.
    [Proteus_Tester_SAMD21G_01.pdsprj]
2018-05-10 Разработка схемы
    [UROV_4_2R.pdsprj, UROV_display_ LGDP4524_1R.pdsprj]
2021-05-02 Корректировка программы
2021-06-04 Обновление GreenhouseProject21_06_03
    [Configuration_DEBUG.h, Configuration_DUE.h, Configuration_DUE_HARDWARE.h, Configuration_Shared.h]
2021-06-04 Добавил проект датчика влажности грунта
    [Soil_moisture_sensorAmega328_6.pdsprj]
2021-06-05 Корректировка программы датчика влажности грунта
2021-06-05 Настроил файл конфигурации контроллера Configuration_DUE_HARDWARE.h
    [Configuration_DUE_HARDWARE.h]
2021-06-06 Инструкция, добавлено Диапазоны индикации влажности светодиодами
2021-06-07 Обновил программу контроллера теплицы и приемника метеостанции Misol
    [Configuration_DEBUG.h, Configuration_DUE.h, Configuration_DUE_HARDWARE.h, Configuration_Shared.h]
2021-06-10 Программа приема данных с метеостанции WN5300CA
2021-06-10 Удалил неактуальные файлы
    [Configuration_DEBUG.h, Configuration_DUE.h, Configuration_DUE_HARDWARE.h, Configuration_Shared.h]
2021-06-10 Проект приемника метеостанции Misol для подключения к контроллеру теплицы.
    [Receive_MisolAmega328_1.pdsprj]
2021-06-10 Проект приемника метеостанции Misol для подключения к контроллеру теплицы
    [Receive_MisolAmega328_1.pdsprj]
2021-06-13 Удаление файлов
2021-06-13 Добавил файлы программ приемника Misol
2021-06-14 Обновление программ
    [Configuration_DEBUG.h, Configuration_DUE.h, Configuration_DUE_HARDWARE.h, Configuration_Shared.h]
2021-06-15 Конфигуратор ПК
2021-06-15 Конфигуратор ПК (новый)
2021-06-16 Новая версия Main_controller_SAM3X8E_06_21_06_16_Misol
    [Configuration_DEBUG.h, Configuration_DUE.h, Configuration_DUE_HARDWARE.h, Configuration_Shared.h]
2021-06-25 Программа контроллера теплицы на STM32 с дисплеем NT35510
2021-10-02 Обновление
    [UltrasonicWaterTankModuleR1.pdsprj, Модуль полива шилд.pdsprj, Модуль ультразвуковой шилд.pdsprj]
2021-10-26 Добавил Main_controller_SAM3X8E_07_21_10_04
    [Configuration_DEBUG.h, Configuration_DUE.h, Configuration_DUE_HARDWARE.h, Configuration_Shared.h]
2021-11-11 Обновление программы контроллера теплицы Main_controller_SAM3X8E_07_21_11_10
    [Configuration_DEBUG.h, Configuration_DUE.h, Configuration_DUE_HARDWARE.h, Configuration_Shared.h]
2021-11-14 Добавил прошивку Main_controller_SAM3X8E_07_21_11_10_pin51
2021-11-14 Инструкция загрузки прошивки
2022-01-16 Контроллер теплицы DUE
    [Configuration_DEBUG.h, Configuration_DUE.h, Configuration_DUE_HARDWARE.h, Configuration_Shared.h]
2022-01-19 Project ControllerModule_Framug
    [ControllerModule_Framug1.pdsprj, ControllerModule_Framug2.pdsprj, Модуль фрамуг шилд1.pdsprj, Модуль фрамуг шилд2.pdsprj]
2022-01-20 Радиомодуль управления фрамугами
    [ControllerModule_Framug2.pdsprj]
2022-01-20 Радиомодуль внешних датчиков
    [UniversalSensorsModuleDS1820_02.pdsprj]
2023-03-09 Обзор конструкций теплиц
2023-05-20 Инструкции на контроллер теплицы
    [Назначение выводов Universal controller_SAM3X8E_07.xls]
